addrummond/lightmeter/Readme.markdown

ARM gcc toolchain:

    https://launchpad.net/gcc-arm-embedded/+download

Programming known to work with OpenOCD 0.8.0.

See firmware/GDB_Readme.markdown.

Python 3 plus 'pypng' module required for build process.
