addrummond/lightmeter/schematic/lbr/README.markdown

Some lbr files which may be used in the schematic (some of these aren't but I haven't sorted out which ones yet).
