addrummond/lightmeter/schematic/proto2notes.markdown

* Layout for headphone jack is slightly wrong.
* Switch to fixed voltage buck reg (2.8V ?)
* Appear not to have 1uF caps in parts list?
* No Schotkey diodes in parts list?
* Power mux design is bad when both sources plugged in.
