addrummond/lightmeter/schematic/lipolybatterynotes.markdown

Display is ~27mm wide.

A good battery match is the HW352730, which is 27mm wide, 30mm long and 3.5mm
thick.

http://www.howellenergy.com/en/products/Li_polymer_battery/2013/0703/28.html

These batteries output 3.7V (nominal) and have a 200mAH capacity. Could consider
using two of them (27x60mm).

Also some suitable ones here:

http://www.lipolbattery.com/lipo%20battery.html
http://www.plgenergy.com/content/?1186.html
