addrummond/lightmeter/schematic/ordered/notesonfirstprotoboards.markdown

Notes on issues with initial prototype boards
-----

* Diodes should all have anode/cathode the same way round.

* Q5 and R5 are too close.

* Debug pad should be turned into via.

* Pad spacing on attiny1634 to be changed.

* Add battery recharge circuit (with microusb connector)?

* Test pad for op amp output?
