addrummond/lightmeter/schematic/Display_power_usage.markdown

When all pixels are set, uses 35mA when running on 5V via the Adafruit board,
and 20mA when half of the pixels are set, 11.8 when 1/4 are set, and 7.6 when
1/8 are set.

Typical usage for displaying moderate amounts of text appears to be around 5mA.
