addrummond/lightmeter/schematic/lightmeter.brd

## EAGLE design schematic/lightmeter.brd (2016-03-10)

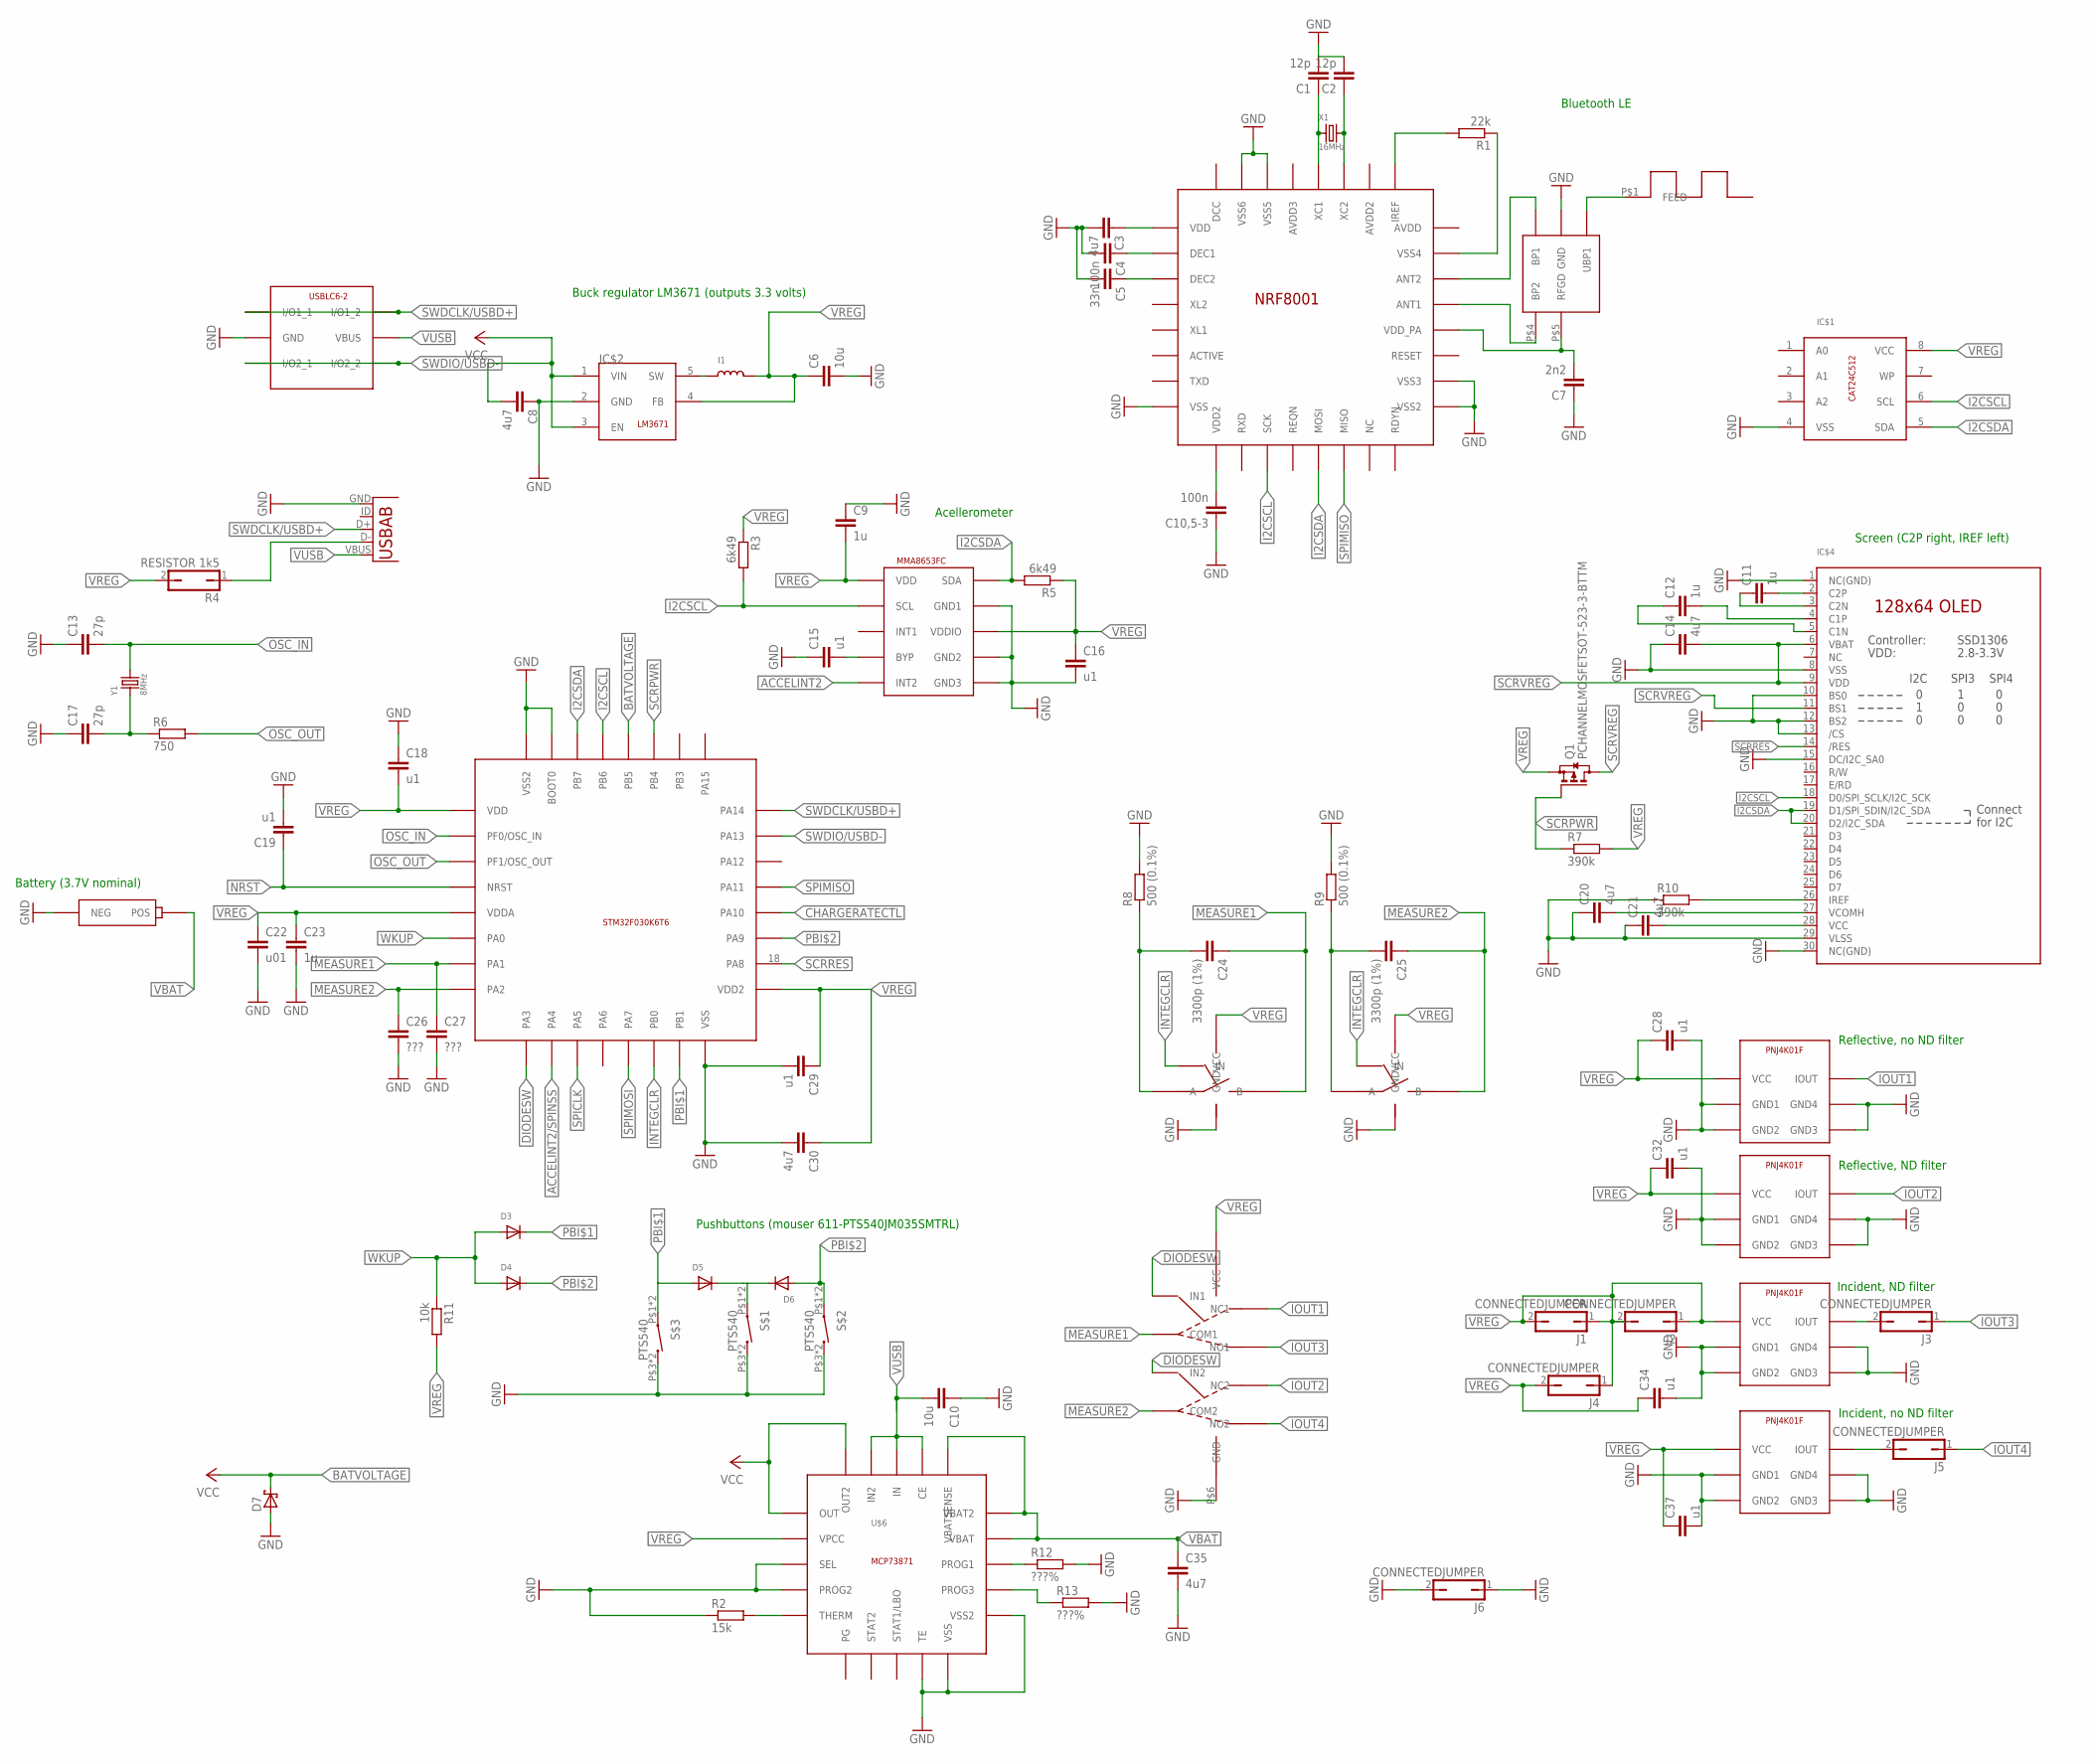
[picture p1: schematic lightmeter.sch]

Parts:
C1, C2: 12p; C0402
C3, C8, C14, C20, C21, C30, C35: 4u7; C0402
C4, C10,5-3: 100n; C0402
C5: 33n; C0402
C6: 10u; C0603
C7: 2n2; C0402
C9: 1u; C0603
C10: 10u; C0402
C11, C12: 1u; C0402
C13: 27p; GAP0402
C15, C16, C18, C19, C28, C29, C32, C34, C37: u1; C0402
C17: 27p; C0402
C22: u01; GAP0402
C23: 1u; GAP0603
C24, C25: 3300p (1%); C0603
C26, C27: ???; GAP0402
D3, D4, D5, D6: DIODESOD-323F; SOD-323F
D7: SCHOTTKY-DIODESOD-929; SOD-923
I1: CDRH2D14
IC$1: CAT24C512; TSSOP8
IC$2: LM3671; SOT23-5
IC$3: MMA8653; DFN-10
IC$4: DISP_OLED_UG-2864HSWEG010.96"; UG-2864HSWEG01_0.96IN_WRAPAROUND
IC$5: STM32F030K6T6; QFP-32
IC$6, IC$7: SN74LVC1G66; SOT-553-5
IC$8, IC$9, IC$11, IC$13: PNJ4K01F
IC$12: NLAS5223B; WQFN10
J1, J2, J3, J4, J5, J6: CONNECTEDJUMPER; JUMPER_R0402
Q1: PCHANNELMOSFETSOT-523-3-BTTM; SOT-523-3-BTTM
R1: 22k; R0402
R2: 15k; R0402
R3, R5: 6k49; R0402
R4: RESISTOR 1k5; JUMPER_R0402
R6: 750; R0402
R7, R10: 390k; R0402
R8, R9: 500 (0.1%); R0402
R11: 10k; R0402
R12, R13: ???%; R0402
S$1, S$2, S$3: PTS540; PTS540BTM
U1: USB-ABUSB-AB-MICRO-MIDMOUNT; USB-AB-MICRO-MIDMOUNT
U$1: 2450AT18A100
U$2: 2450BM14A00022450BM14A0002; 2450BM14A0002
U$3: NRF8001
U$4: USBLC6-2; SOT666
U$5: LIBAT; 78171-0002
U$6: MCP73871; QFN20
X1: 16MHz; CRYSTAL-2X1.6
Y1: 8MHz; CRYSTAL3.2X5MM

Connections:
ACCELINT2: IC$3.P$5 (INT2)
ACCELINT2/SPINSS: IC$5.10 (PA4)
ANT1CON: U$2.P$4 (BP2), U$3.P$21 (ANT1)
ANT2CON: U$2.P$3 (BP1), U$3.P$22 (ANT2)
ANTTRACE: U$1.P$1, U$2.P$1 (UBP1)
BATVOLTAGE: D7.P$2 (C), IC$5.28 (PB5)
CHARGERATECTL: IC$5.20 (PA10)
DIODESW: IC$5.9 (PA3), IC$12.P$4 (IN1), IC$12.P$8 (IN2)
GND: C1.2, C2.2, C3.2, C4.2, C5.2, C6.2, C7.1, C8.1, C9.1, C10.1, C10,5-3.1, C13.1, C14.1, C15.1, C16.2, C17.1, C18.1, C19.2, C20.1, C21.1, C22.2, C23.2, C26.2, C27.2, C28.2, C29.2, C30.2, C32.2, C34.2, C35.2, C37.2, D7.P$1 (A), IC$1.4 (VSS), IC$2.2 (GND), IC$3.P$6 (GND3), IC$3.P$7 (GND2), IC$3.P$9 (GND1), IC$4.1 (NC(GND)), IC$4.8 (VSS), IC$4.10 (BS0), IC$4.12 (BS2), IC$4.13 (/CS), IC$4.15 (DC/I2C_SA0), IC$4.29 (VLSS), IC$4.30 (NC(GND)), IC$5.16 (VSS), IC$5.31 (BOOT0), IC$5.32 (VSS2), IC$6.P$3 (GND), IC$7.P$3 (GND), IC$8.P$2 (GND1), IC$8.P$3 (GND2), IC$8.P$4 (GND3), IC$8.P$5 (GND4), IC$9.P$2 (GND1), IC$9.P$3 (GND2), IC$9.P$4 (GND3), IC$9.P$5 (GND4), IC$11.P$2 (GND1), IC$11.P$3 (GND2), IC$11.P$4 (GND3), IC$11.P$5 (GND4), IC$12.P$6 (GND), IC$13.P$2 (GND1), IC$13.P$3 (GND2), IC$13.P$4 (GND3), IC$13.P$5 (GND4), J6.1, J6.2, R2.1, R8.2, R9.2, R10.1, R12.2, R13.2, S$1.P$3 (2), S$1.P$4 (2), S$2.P$3 (2), S$2.P$4 (2), S$3.P$3 (2), S$3.P$4 (2), U1.GND, U$2.P$2 (GND), U$3.P$8 (VSS), U$3.P$17 (VSS2), U$3.P$18 (VSS3), U$3.P$30 (VSS5), U$3.P$31 (VSS6), U$3.P$33 (VSS), U$4.P$2 (GND), U$5.P$1 (NEG), U$6.P$3 (SEL), U$6.P$4 (PROG2), U$6.P$9 (TE), U$6.P$10 (VSS), U$6.P$11 (VSS2), U$6.P$21 (VSS2)
I2CSCL: IC$1.6 (SCL), IC$3.P$2 (SCL), IC$4.18 (D0/SPI_SCLK/I2C_SCK), IC$5.29 (PB6), R3.2, U$3.P$11 (SCK)
I2CSDA: IC$1.5 (SDA), IC$3.P$10 (SDA), IC$4.19 (D1/SPI_SDIN/I2C_SDA), IC$4.20 (D2/I2C_SDA), IC$5.30 (PB7), R5.2, U$3.P$13 (MOSI)
INTEGCLR: IC$5.14 (PB0), IC$6.P$4 (IN), IC$7.P$4 (IN)
IOUT1: IC$8.P$6 (IOUT), IC$12.P$5 (NC1)
IOUT2: IC$9.P$6 (IOUT), IC$12.P$7 (NC2)
IOUT3: IC$12.P$2 (NO1), J3.1
IOUT4: IC$12.P$10 (NO2), J5.1
MEASURE1: C24.1, C27.1, IC$5.7 (PA1), IC$6.P$2 (B), IC$12.P$3 (COM1)
MEASURE2: C25.1, C26.1, IC$5.8 (PA2), IC$7.P$2 (B), IC$12.P$9 (COM2)
unnamed: IC$11.P$6 (IOUT), J3.2
unnamed: IC$13.P$6 (IOUT), J5.2
unnamed: C24.2, IC$6.P$1 (A), R8.1
unnamed: R2.2, U$6.P$5 (THERM)
unnamed: C25.2, IC$7.P$1 (A), R9.1
unnamed: C15.2, IC$3.P$4 (BYP)
unnamed: C17.2, R6.1, Y1.P$1 (1)
unnamed: I1.P$1 (1), IC$2.5 (SW)
unnamed: C20.2, IC$4.27 (VCOMH)
unnamed: D5.C, D6.C, S$1.P$1 (1), S$1.P$2 (1)
unnamed: C11.2, IC$4.2 (C2P)
unnamed: C11.1, IC$4.3 (C2N)
unnamed: C7.2, U$2.P$5 (RFGD), U$3.P$20 (VDD_PA)
unnamed: R1.2, U$3.P$25 (IREF)
unnamed: IC$4.26 (IREF), R10.2
unnamed: R1.1, U$3.P$23 (VSS4)
unnamed: C5.1, U$3.P$3 (DEC2)
unnamed: C3.1, U$3.P$1 (VDD)
unnamed: C10,5-3.2, U$3.P$9 (VDD2)
unnamed: C12.1, IC$4.5 (C1N)
unnamed: C4.1, U$3.P$2 (DEC1)
unnamed: C1.1, U$3.P$28 (XC1), X1.P$1 (1)
unnamed: C12.2, IC$4.4 (C1P)
unnamed: C2.1, U$3.P$27 (XC2), X1.P$3 (2)
unnamed: C21.2, IC$4.28 (VCC)
unnamed: R12.1, U$6.P$13 (PROG1)
unnamed: R13.1, U$6.P$12 (PROG3)
NRST: C19.1, IC$5.4 (NRST)
OSC_IN: C13.2, IC$5.2 (PF0/OSC_IN), Y1.P$2 (2)
OSC_OUT: IC$5.3 (PF1/OSC_OUT), R6.2
PBI$1: D3.C, D5.A, IC$5.15 (PB1), S$3.P$1 (1), S$3.P$2 (1)
PBI$2: D4.C, D6.A, IC$5.19 (PA9), S$2.P$1 (1), S$2.P$2 (1)
SCRPWR: IC$5.27 (PB4), Q1.P$3 (G), R7.1
SCRRES: IC$4.14 (/RES), IC$5.18 (PA8)
SCRVREG: C14.2, IC$4.6 (VBAT), IC$4.9 (VDD), IC$4.11 (BS1), Q1.P$1 (D)
SPICLK: IC$5.11 (PA5)
SPIMISO: IC$5.21 (PA11), U$3.P$14 (MISO)
SPIMOSI: IC$5.13 (PA7)
SWDCLK/USBD+: IC$5.24 (PA14), U1.D+, U$4.P$1 (I/O1_1), U$4.P$6 (I/O1_2)
SWDIO/USBD-: IC$5.23 (PA13), U$4.P$3 (I/O2_1), U$4.P$4 (I/O2_2)
USBD-: R4.1, U1.D-
VBAT: C35.1, U$5.P$2 (POS), U$6.P$14 (VBAT), U$6.P$15 (VBAT2), U$6.P$16 (VBATSENSE)
VCC: C8.2, IC$2.1 (VIN), IC$2.3 (EN), U$6.P$1 (OUT), U$6.P$20 (OUT2)
VREG: C6.1, C9.2, C16.1, C18.2, C22.1, C23.1, C28.1, C29.1, C30.1, C32.1, C34.1, C37.1, I1.P$2 (2), IC$1.8 (VCC), IC$2.4 (FB), IC$3.P$1 (VDD), IC$3.P$8 (VDDIO), IC$5.1 (VDD), IC$5.5 (VDDA), IC$5.17 (VDD2), IC$6.P$5 (VCC), IC$7.P$5 (VCC), IC$8.P$1 (VCC), IC$9.P$1 (VCC), IC$11.P$1 (VCC), IC$12.P$1 (VCC), IC$13.P$1 (VCC), J1.1, J1.2, J2.1, J2.2, J4.1, J4.2, Q1.P$2 (S), R3.1, R4.2, R5.1, R7.2, R11.2, U$6.P$2 (VPCC)
VUSB: C10.2, U1.VBUS, U$4.P$5 (VBUS), U$6.P$17 (CE), U$6.P$18 (IN), U$6.P$19 (IN2)
WKUP: D3.A, D4.A, IC$5.6 (PA0), R11.1

Notes on the sheet:
Battery (3.7V nominal)
Buck regulator LM3671 (outputs 3.3 volts)
Pushbuttons (mouser 611-PTS540JM035SMTRL)
Screen (C2P right, IREF left)
Acellerometer
Reflective, no ND filter
Reflective, ND filter
Incident, ND filter
Incident, no ND filter
Bluetooth LE

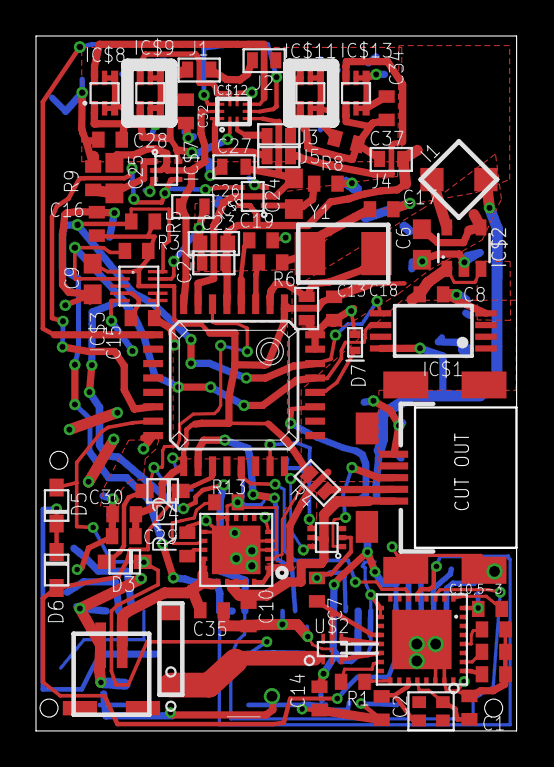
[picture p2: board lightmeter.brd from above]

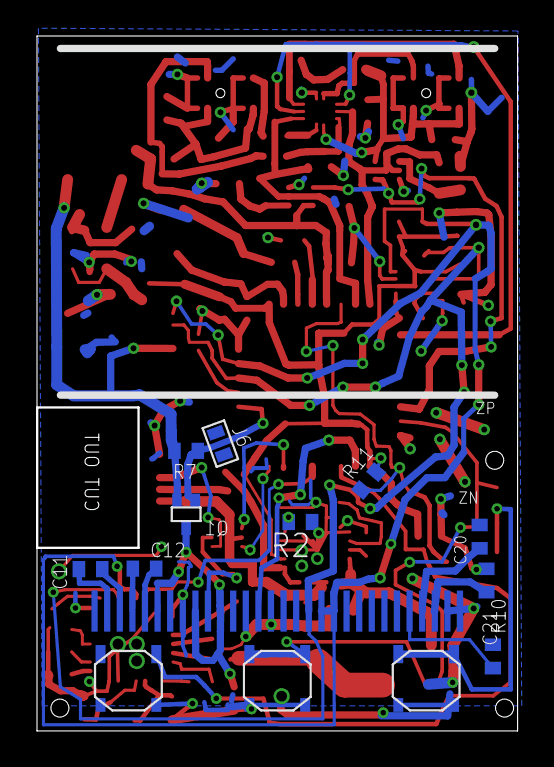
[picture p3: board lightmeter.brd from below]

Board: 2 copper layers, 26.7 x 38.6 mm, 85 parts (9 on the bottom side), 59 nets.
