addrummond/lightmeter/schematic/ordered/lightmeter_seeed2.brd

## EAGLE design schematic/ordered/lightmeter_seeed2.brd (2015-05-27)

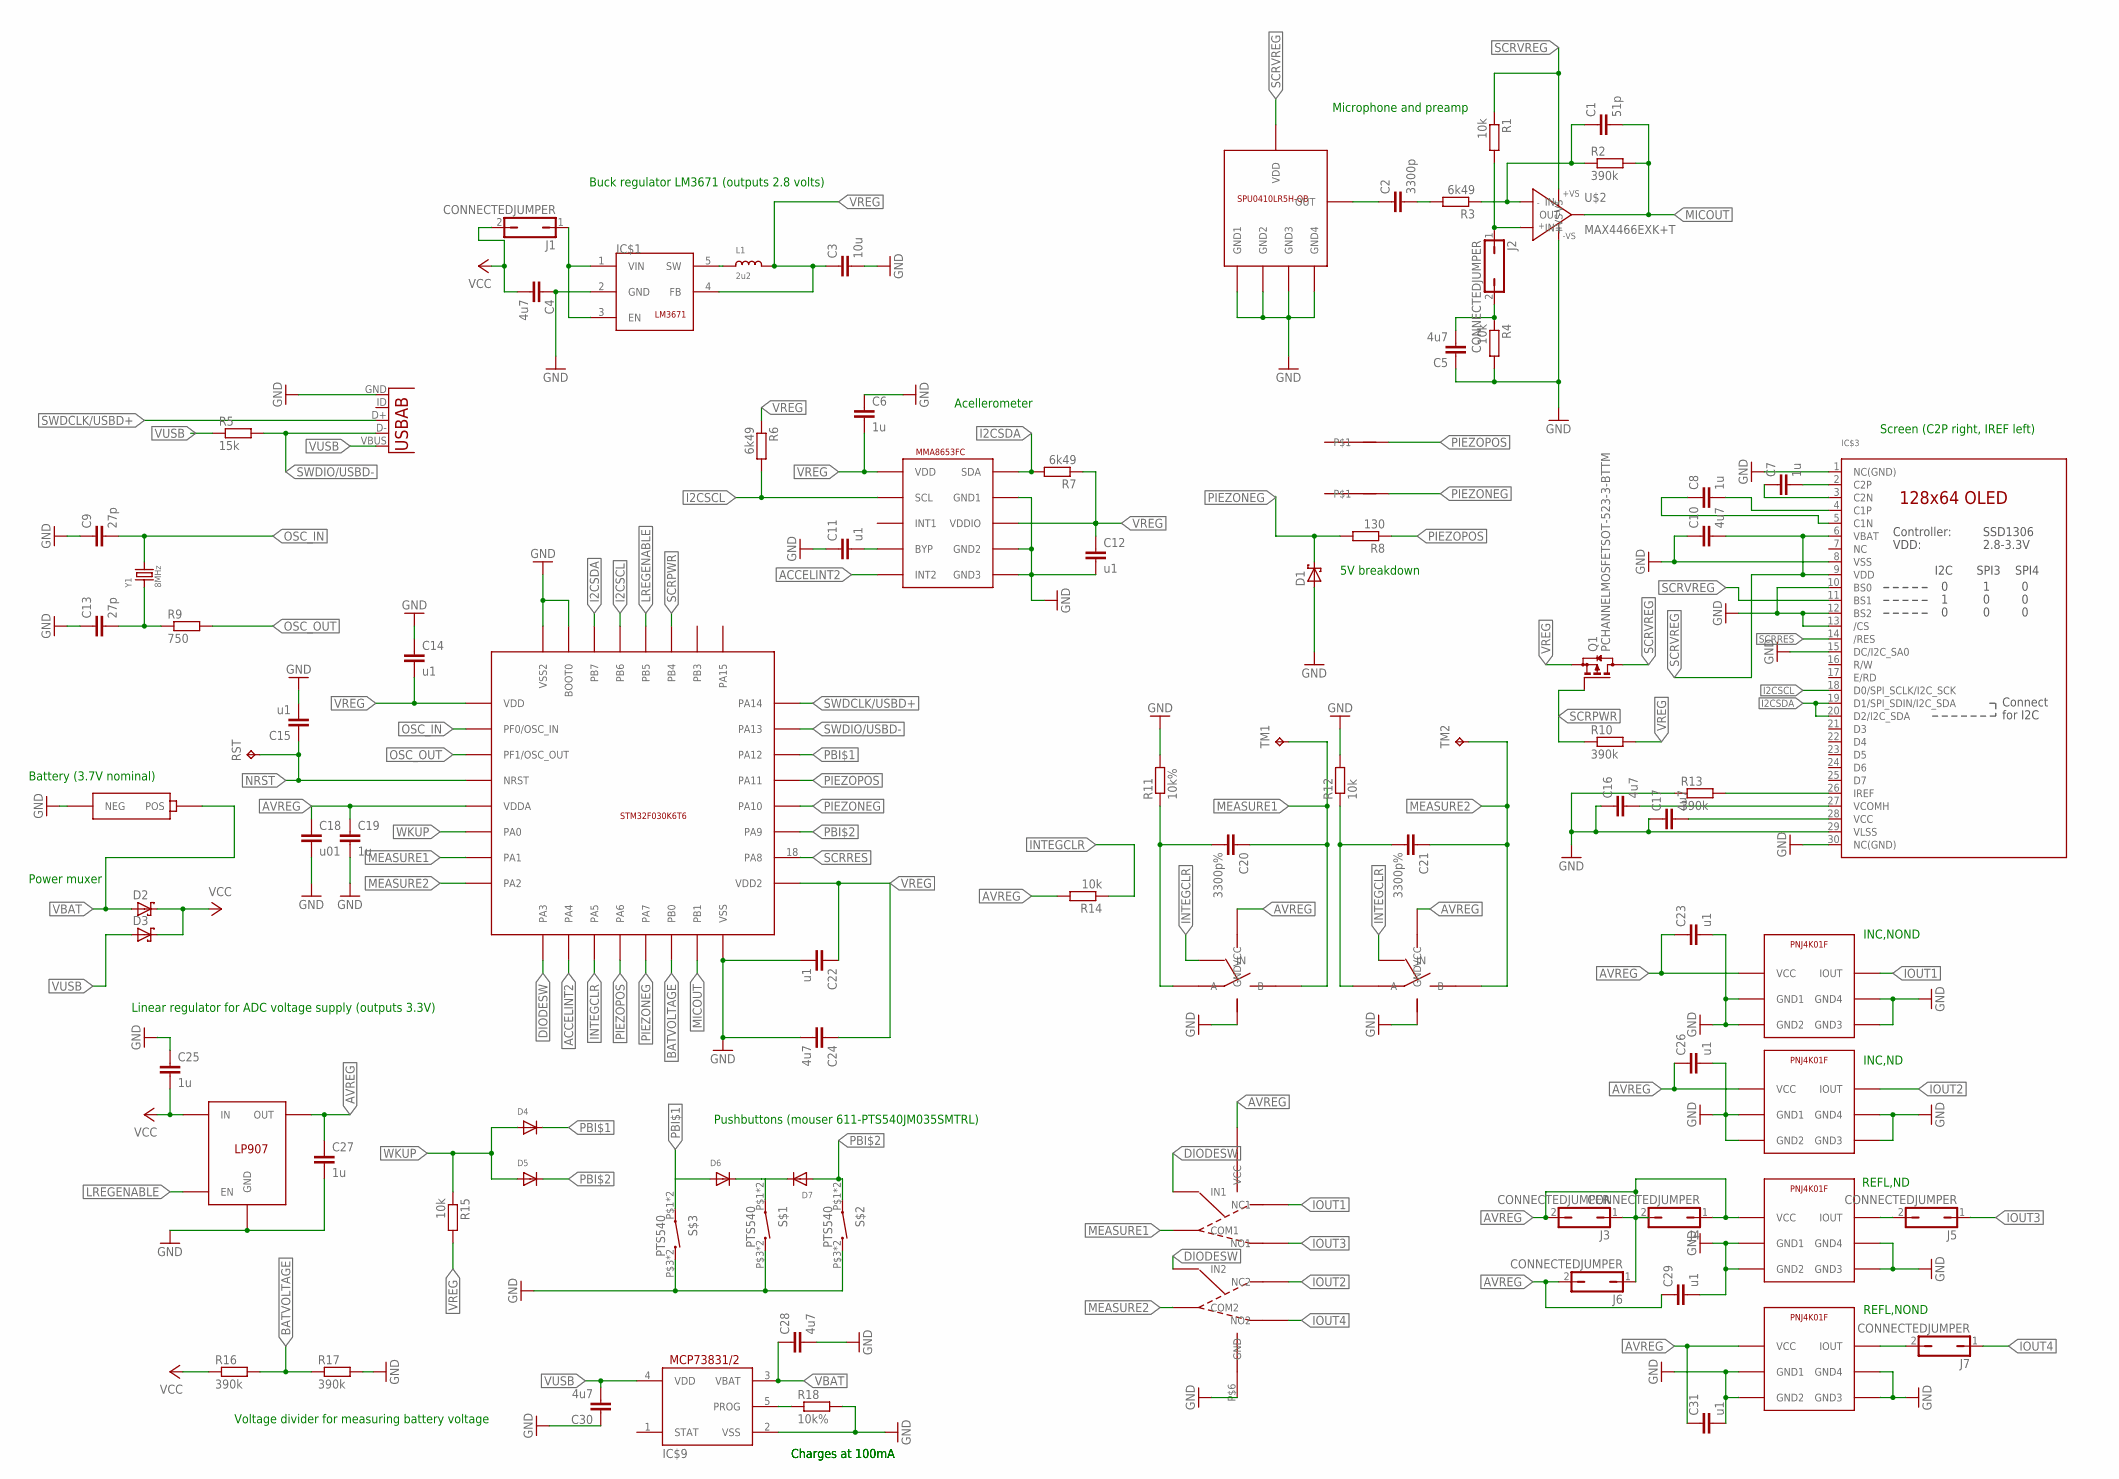
[picture p4: schematic lightmeter_seeed2.sch]

Parts:
C1: 51p; C0402
C2: 3300p; C0603
C3: 10u; C0402
C4, C5, C10, C16, C17, C24, C28, C30: 4u7; C0402
C6, C7, C8, C25, C27: 1u; C0603
C9: 27p; GAP0402
C11, C12, C14, C15, C22, C23, C26, C29, C31: u1; C0402
C13: 27p; C0402
C18: u01; GAP0402
C19: 1u; GAP0603
C20, C21: 3300p%; C0603
D1: SCHOTTKY-DIODESOD-923-BTTM; SOD-923-BTTM
D2, D3: SCHOTTKY-DIODESC-79; SC-79
D4, D5, D6, D7: DIODESOD-323F; SOD-323F
IC$1: LM3671; SOT23-5
IC$2: MMA8653; DFN-10
IC$3: DISP_OLED_UG-2864HSWEG010.96"; UG-2864HSWEG01_0.96IN_WRAPAROUND
IC$4: STM32F030K6T6; QFP-32
IC$5, IC$7, IC$8, IC$10: PNJ4K01F
IC$6: LP5907; SOT23-5L
IC$9: MCP73831/OT; SOT23-5L
J1, J2, J3, J4, J5, J6, J7: CONNECTEDJUMPER; JUMPER_R0402
L1: 2u2; _0603
Q1: PCHANNELMOSFETSOT-523-3-BTTM; SOT-523-3-BTTM
R1, R4, R12, R14, R15: 10k; R0402
R2, R10, R13, R17: 390k; R0402
R3, R6, R7: 6k49; R0402
R5: 15k; R0402
R8: 130; R0402
R9: 750; R0402
R11, R18: 10k%; R0402
R16: 390k; JUMPER_R0402
RST: TPB1,27; B1,27
S$1, S$2, S$3: PTS540; PTS540BTM
TM1, TM2: TPB1,27; B1,27
U1: USB-ABUSB-AB-MICRO-MIDMOUNT; USB-AB-MICRO-MIDMOUNT
U$1: SPU0410LR5H-QBSPU0410LRSH-QB; SPU0410LR5H-QB
U$2: MAX4466EXK+T; SC-70-5
U$3: LIBAT; 78171-0002
U$4, U$5: SN74LVC1G66; SOT-553-5
U$6: NLAS5223B; WQFN10
Y1: 8MHz; CRYSTAL3.2X5MM
ZN: WIREATTACHMENT; SMALLSQUAREWIREHOLE
ZP: WIREATTACHMENT; SMALLSQUAREWIREHOLE

Connections:
ACCELINT2: IC$2.P$5 (INT2), IC$4.10 (PA4)
AVREG: C18.1, C19.1, C23.1, C26.1, C27.1, C29.1, C31.1, IC$4.5 (VDDA), IC$5.P$1 (VCC), IC$6.5 (OUT), IC$7.P$1 (VCC), IC$8.P$1 (VCC), IC$10.P$1 (VCC), J3.1, J3.2, J4.1, J4.2, J6.1, J6.2, R14.2, U$4.P$5 (VCC), U$5.P$5 (VCC), U$6.P$1 (VCC)
BATVOLTAGE: IC$4.14 (PB0), R16.2, R17.1
DIODESW: IC$4.9 (PA3), U$6.P$4 (IN1), U$6.P$8 (IN2)
GND: C3.2, C4.1, C5.1, C6.1, C9.1, C10.1, C11.1, C12.2, C13.1, C14.1, C15.2, C16.1, C17.1, C18.2, C19.2, C22.2, C23.2, C24.2, C25.1, C26.2, C27.2, C28.2, C29.2, C30.1, C31.2, D1.P$1 (A), IC$1.2 (GND), IC$2.P$6 (GND3), IC$2.P$7 (GND2), IC$2.P$9 (GND1), IC$3.1 (NC(GND)), IC$3.8 (VSS), IC$3.10 (BS0), IC$3.12 (BS2), IC$3.13 (/CS), IC$3.15 (DC/I2C_SA0), IC$3.29 (VLSS), IC$3.30 (NC(GND)), IC$4.16 (VSS), IC$4.31 (BOOT0), IC$4.32 (VSS2), IC$5.P$2 (GND1), IC$5.P$3 (GND2), IC$5.P$4 (GND3), IC$5.P$5 (GND4), IC$6.2 (GND), IC$7.P$2 (GND1), IC$7.P$3 (GND2), IC$7.P$4 (GND3), IC$7.P$5 (GND4), IC$8.P$2 (GND1), IC$8.P$3 (GND2), IC$8.P$4 (GND3), IC$8.P$5 (GND4), IC$9.2 (VSS), IC$10.P$2 (GND1), IC$10.P$3 (GND2), IC$10.P$4 (GND3), IC$10.P$5 (GND4), R4.2, R11.2, R12.2, R13.1, R17.2, R18.2, S$1.P$3 (2), S$1.P$4 (2), S$2.P$3 (2), S$2.P$4 (2), S$3.P$3 (2), S$3.P$4 (2), U1.GND, U$1.P$2 (GND1), U$1.P$3 (GND2), U$1.P$5 (GND3), U$1.P$6 (GND4), U$2.P$2 (-VS), U$3.P$1 (NEG), U$4.P$3 (GND), U$5.P$3 (GND), U$6.P$6 (GND)
I2CSCL: IC$2.P$2 (SCL), IC$3.18 (D0/SPI_SCLK/I2C_SCK), IC$4.29 (PB6), R6.2
I2CSDA: IC$2.P$10 (SDA), IC$3.19 (D1/SPI_SDIN/I2C_SDA), IC$3.20 (D2/I2C_SDA), IC$4.30 (PB7), R7.2
INTEGCLR: IC$4.11 (PA5), R14.1, U$4.P$4 (IN), U$5.P$4 (IN)
IOUT1: IC$5.P$6 (IOUT), U$6.P$5 (NC1)
IOUT2: IC$7.P$6 (IOUT), U$6.P$7 (NC2)
IOUT3: J5.1, U$6.P$2 (NO1)
IOUT4: J7.1, U$6.P$10 (NO2)
LREGENABLE: IC$4.28 (PB5), IC$6.3 (EN)
MEASURE1: C20.1, IC$4.7 (PA1), TM1.TP, U$4.P$2 (B), U$6.P$3 (COM1)
MEASURE2: C21.1, IC$4.8 (PA2), TM2.TP, U$5.P$2 (B), U$6.P$9 (COM2)
MICOUT: C1.2, IC$4.15 (PB1), R2.2, U$2.P$4 (OUT)
unnamed: IC$8.P$6 (IOUT), J5.2
unnamed: IC$10.P$6 (IOUT), J7.2
unnamed: C20.2, R11.1, U$4.P$1 (A)
unnamed: IC$1.1 (VIN), IC$1.3 (EN), J1.1
unnamed: IC$9.5 (PROG), R18.1
unnamed: C21.2, R12.1, U$5.P$1 (A)
unnamed: C11.2, IC$2.P$4 (BYP)
unnamed: C13.2, R9.1, Y1.P$1 (1)
unnamed: IC$1.5 (SW), L1.1
unnamed: C16.2, IC$3.27 (VCOMH)
unnamed: D6.C, D7.C, S$1.P$1 (1), S$1.P$2 (1)
unnamed: C2.1, U$1.P$1 (OUT)
unnamed: C7.2, IC$3.2 (C2P)
unnamed: C7.1, IC$3.3 (C2N)
unnamed: C2.2, R3.2
unnamed: C1.1, R2.1, R3.1, U$2.P$3 (IN-)
unnamed: IC$3.26 (IREF), R13.2
unnamed: J2.1, R1.2, U$2.P$1 (IN+)
unnamed: C5.2, J2.2, R4.1
unnamed: C8.1, IC$3.5 (C1N)
unnamed: C8.2, IC$3.4 (C1P)
unnamed: C17.2, IC$3.28 (VCC)
NRST: C15.1, IC$4.4 (NRST), RST.TP
OSC_IN: C9.2, IC$4.2 (PF0/OSC_IN), Y1.P$2 (2)
OSC_OUT: IC$4.3 (PF1/OSC_OUT), R9.2
PBI$1: D4.C, D6.A, IC$4.22 (PA12), S$3.P$1 (1), S$3.P$2 (1)
PBI$2: D5.C, D7.A, IC$4.19 (PA9), S$2.P$1 (1), S$2.P$2 (1)
PIEZONEG: D1.P$2 (C), IC$4.13 (PA7), IC$4.20 (PA10), R8.2, ZN.P$1
PIEZOPOS: IC$4.12 (PA6), IC$4.21 (PA11), R8.1, ZP.P$1
SCRPWR: IC$4.27 (PB4), Q1.P$2 (G), R10.1
SCRRES: IC$3.14 (/RES), IC$4.18 (PA8)
SCRVREG: C10.2, IC$3.6 (VBAT), IC$3.9 (VDD), IC$3.11 (BS1), Q1.P$1 (D), R1.1, U$1.P$4 (VDD), U$2.P$5 (+VS)
SWDCLK/USBD+: IC$4.24 (PA14), U1.D+
SWDIO/USBD-: IC$4.23 (PA13), R5.2, U1.D-
VBAT: C28.1, D2.P$2 (A), IC$9.3 (VBAT), U$3.P$2 (POS)
VCC: C4.2, C25.2, D2.P$1 (C), D3.P$1 (C), IC$6.1 (IN), J1.2, R16.1
VREG: C3.1, C6.2, C12.1, C14.2, C22.1, C24.1, IC$1.4 (FB), IC$2.P$1 (VDD), IC$2.P$8 (VDDIO), IC$4.1 (VDD), IC$4.17 (VDD2), L1.2, Q1.P$3 (S), R6.1, R7.1, R10.2, R15.2
VUSB: C30.2, D3.P$2 (A), IC$9.4 (VDD), R5.1, U1.VBUS
WKUP: D4.A, D5.A, IC$4.6 (PA0), R15.1

Notes on the sheet:
Battery (3.7V nominal)
Buck regulator LM3671 (outputs 2.8 volts)
Pushbuttons (mouser 611-PTS540JM035SMTRL)
Screen (C2P right, IREF left)
Power muxer
Charges at 100mA
Acellerometer
Linear regulator for ADC voltage supply (outputs 3.3V)
Voltage divider for measuring battery voltage
INC,NOND
INC,ND
REFL,ND
REFL,NOND
5V breakdown
Microphone and preamp

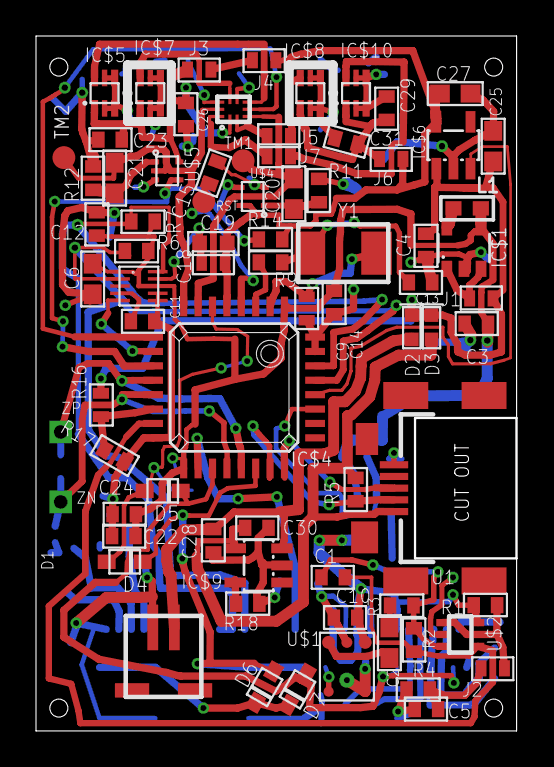
[picture p5: board lightmeter_seeed2.brd from above]

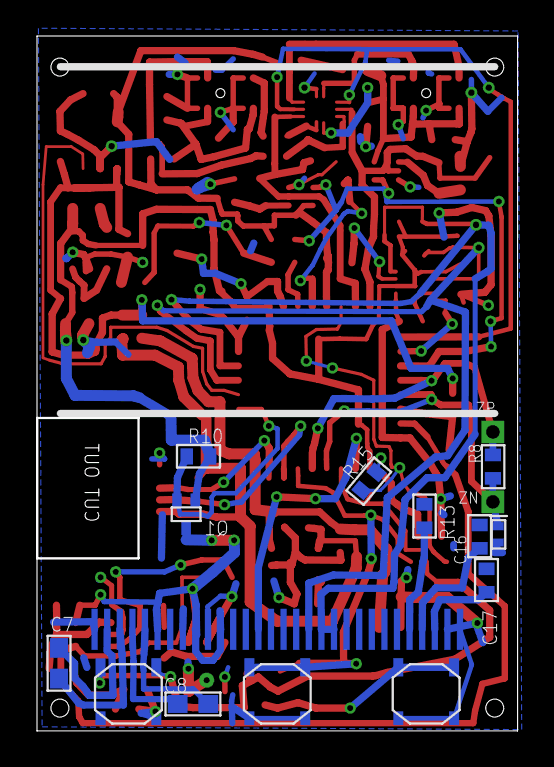
[picture p6: board lightmeter_seeed2.brd from below]

Board: 2 copper layers, 26.7 x 38.6 mm, 91 parts (8 on the bottom side), 55 nets.
