addrummond/lightmeter/schematic/ordered/lightmeter_seeed1.brd

## EAGLE design schematic/ordered/lightmeter_seeed1.brd (2015-03-22)

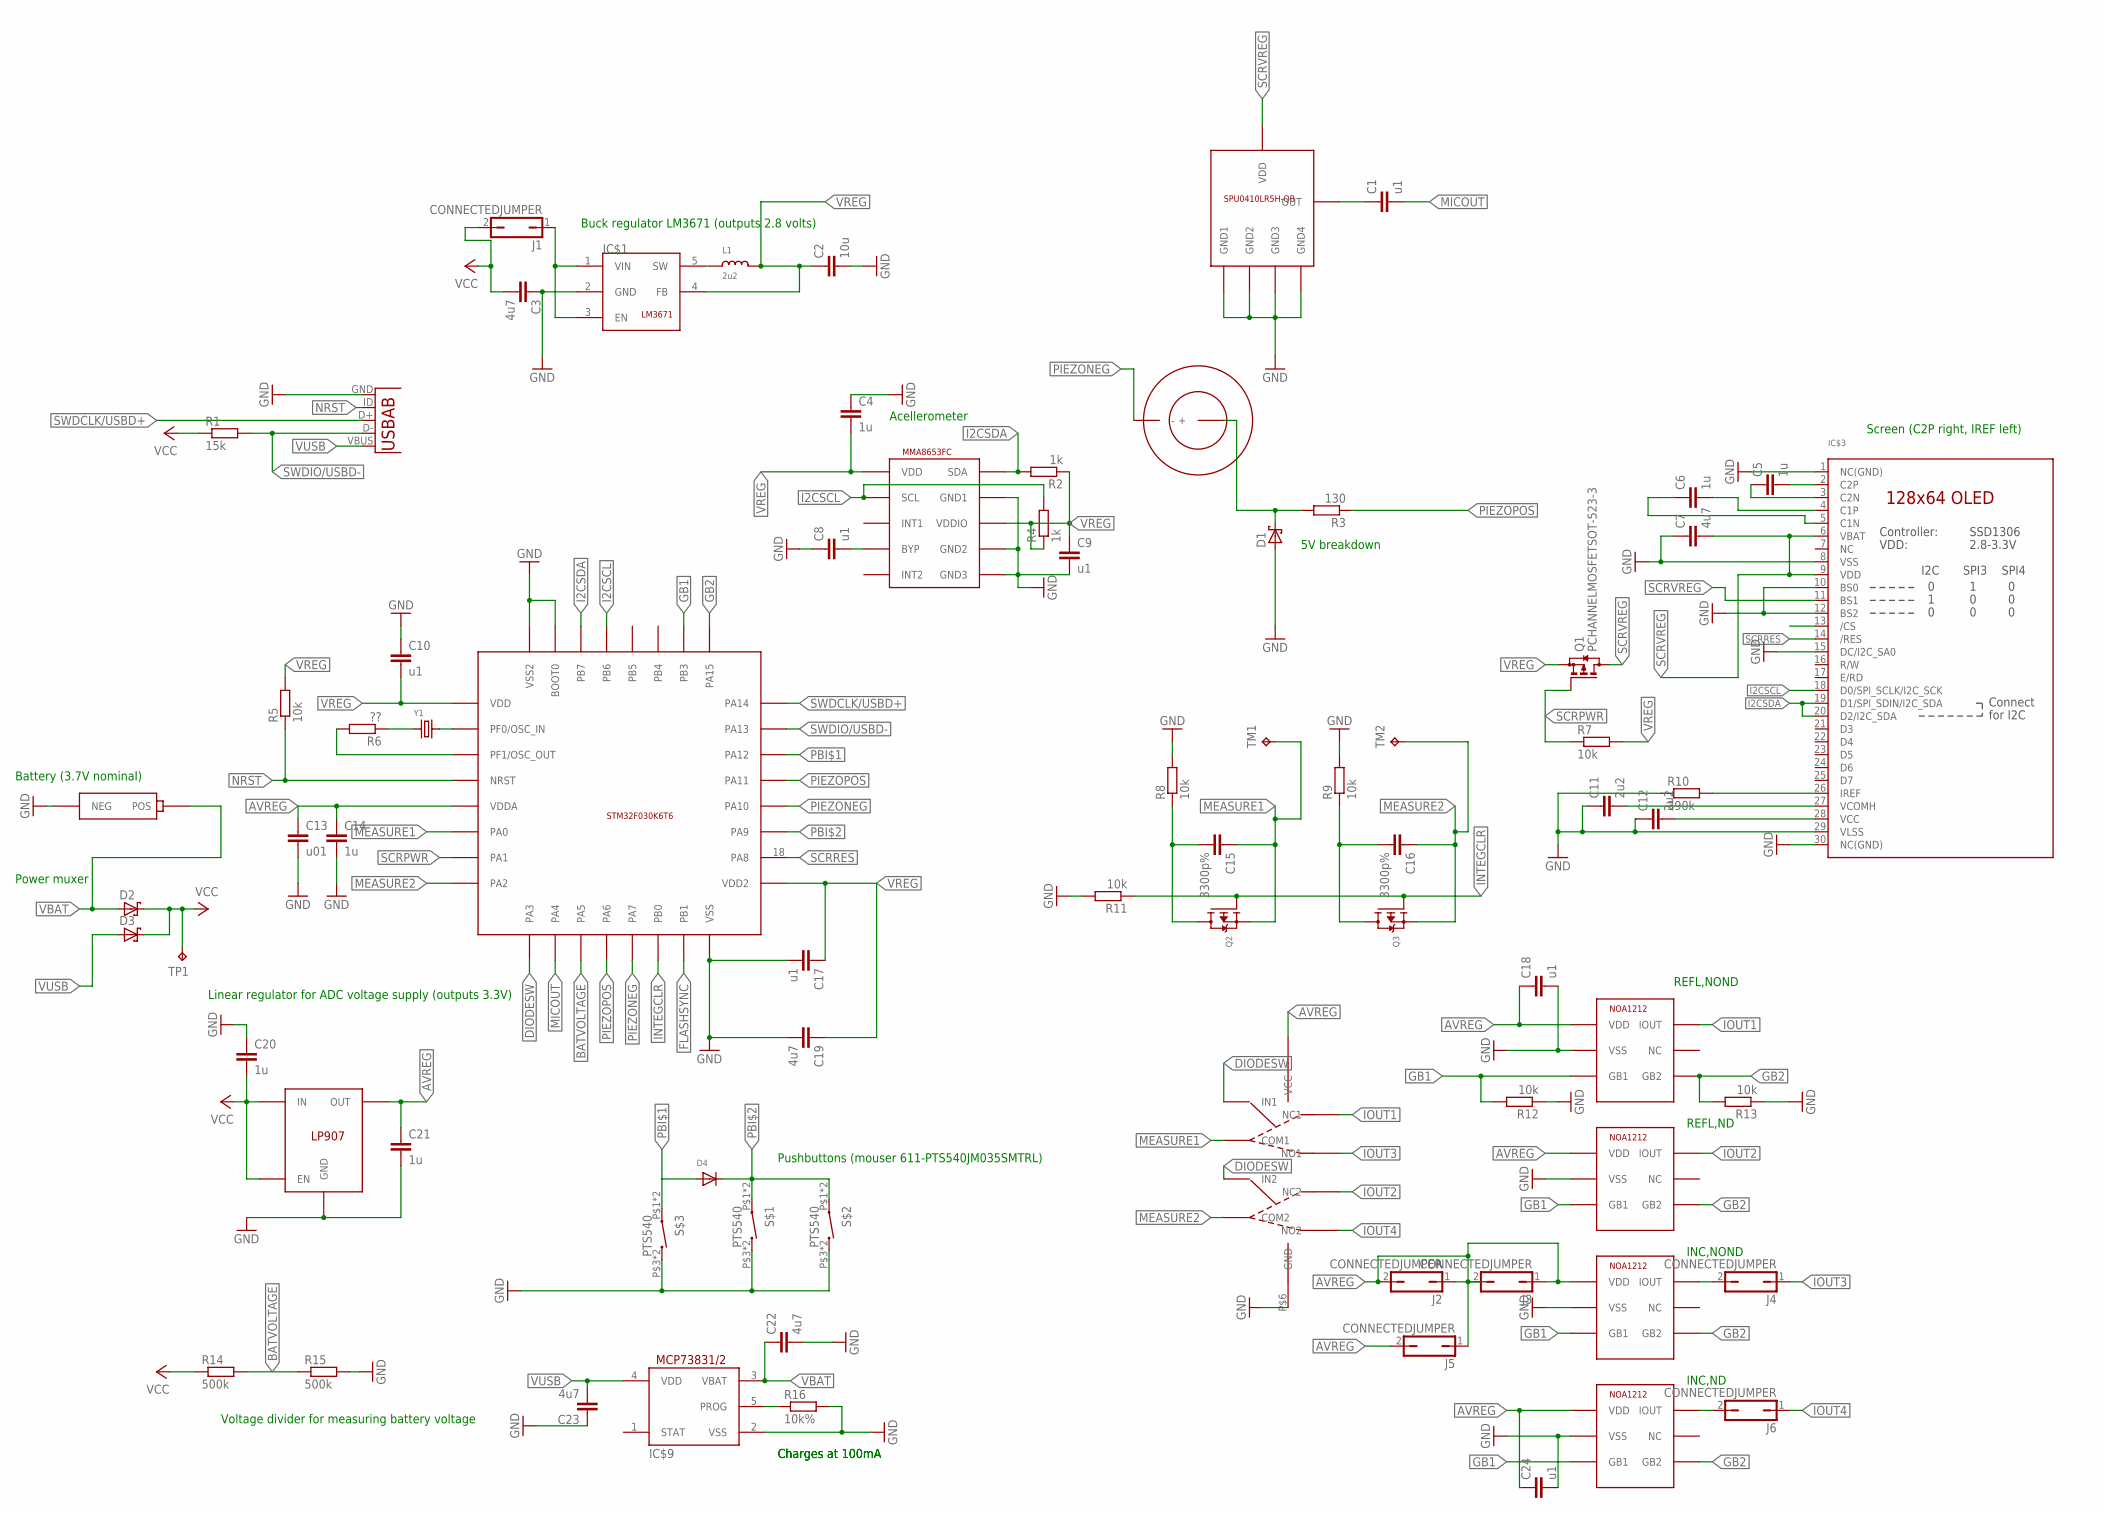
[picture p7: schematic lightmeter_seeed1.sch]

Parts:
C1, C9, C10, C17, C18, C24: u1; C0402
C2: 10u; C0402
C3, C7, C19, C22, C23: 4u7; C0402
C4, C5, C6, C20: 1u; C0603
C8: u1; C0603
C11, C12: 2u2; C0402
C13: u01; GAP0402
C14: 1u; GAP0402
C15, C16: 3300p%; C0603
C21: 1u; C0402
D1: SCHOTTKY-DIODESOD-929; SOD-923
D2, D3: SCHOTTKY-DIODEX3-DFN0603-2; X3-DFN0603-2
D4: DIODESOD-323F; SOD-323F
IC$1: LM3671; SOT23-5
IC$2: MMA8653; DFN-10
IC$3: DISP_OLED_UG-2864HSWEG010.96"; UG-2864HSWEG01_0.96IN_WRAPAROUND
IC$4: STM32F030K6T6; QFP-32
IC$5, IC$7, IC$8, IC$10: NOA1212; CUDFN6
IC$6: LP5907; SOT23-5L
IC$9: MCP73831/OT; SOT23-5L
J1, J2, J3, J4, J5, J6: CONNECTEDJUMPER; JUMPER_R0402
L1: 2u2; _0603
Q1: PCHANNELMOSFETSOT-523-3; SOT-523-3
Q2, Q3: MOSFET-PWIDE; SOT23-WIDE
R1: 15k; R0402
R2, R4: 1k; R0402
R3: 130; R0603
R5, R7, R8, R9, R11, R12, R13: 10k; R0402
R6: ??; R0402
R10: 390k; R0402
R14, R15: 500k; R0402
R16: 10k%; R0402
S$1, S$2, S$3: PTS540; PTS540BTM
TM1, TM2: TPB1,27; B1,27
TP1: TPB1,27; B1,27
U1: USB-ABUSB-AB-MICRO-MIDMOUNT; USB-AB-MICRO-MIDMOUNT
U$1: SPU0410LR5H-QBSPU0410LRSH-QB; SPU0410LR5H-QB
U$2: PIEZOBENDER165
U$3: LIBAT; 78171-0002
U$4: NLAS5223B; WQFN10
Y1: CRYSTAL2.5X2.0MM; CRYSTAL_2.5X2

Connections:
AUDIOIN: D1.P$2 (C), R3.2, U$2.P$2 (+)
AVREG: C13.1, C14.1, C18.1, C21.1, C24.1, IC$4.5 (VDDA), IC$5.P$1 (VDD), IC$6.5 (OUT), IC$7.P$1 (VDD), IC$8.P$1 (VDD), IC$10.P$1 (VDD), J2.1, J2.2, J3.1, J3.2, J5.1, J5.2, U$4.P$1 (VCC)
BATVOLTAGE: IC$4.11 (PA5), R14.2, R15.1
DIODESW: IC$4.9 (PA3), U$4.P$4 (IN1), U$4.P$8 (IN2)
FLASHSYNC: IC$4.15 (PB1)
GB1: IC$4.26 (PB3), IC$5.P$3 (GB1), IC$7.P$3 (GB1), IC$8.P$3 (GB1), IC$10.P$3 (GB1), R12.2
GB2: IC$4.25 (PA15), IC$5.P$4 (GB2), IC$7.P$4 (GB2), IC$8.P$4 (GB2), IC$10.P$4 (GB2), R13.2
GND: C2.2, C3.1, C4.1, C7.1, C8.1, C9.2, C10.1, C11.1, C12.1, C13.2, C14.2, C17.2, C18.2, C19.2, C20.1, C21.2, C22.2, C23.1, C24.2, D1.P$1 (A), IC$1.2 (GND), IC$2.P$6 (GND3), IC$2.P$7 (GND2), IC$2.P$9 (GND1), IC$3.1 (NC(GND)), IC$3.8 (VSS), IC$3.10 (BS0), IC$3.12 (BS2), IC$3.15 (DC/I2C_SA0), IC$3.29 (VLSS), IC$3.30 (NC(GND)), IC$4.16 (VSS), IC$4.31 (BOOT0), IC$4.32 (VSS2), IC$5.P$2 (VSS), IC$5.P$7 (VSS), IC$6.2 (GND), IC$7.P$2 (VSS), IC$7.P$7 (VSS), IC$8.P$2 (VSS), IC$8.P$7 (VSS), IC$9.2 (VSS), IC$10.P$2 (VSS), IC$10.P$7 (VSS), R8.2, R9.2, R10.1, R11.2, R12.1, R13.1, R15.2, R16.2, S$1.P$3 (2), S$1.P$4 (2), S$2.P$3 (2), S$2.P$4 (2), S$3.P$3 (2), S$3.P$4 (2), U1.GND, U$1.P$2 (GND1), U$1.P$3 (GND2), U$1.P$5 (GND3), U$1.P$6 (GND4), U$3.P$1 (NEG), U$4.P$6 (GND)
I2CSCL: IC$2.P$2 (SCL), IC$3.18 (D0/SPI_SCLK/I2C_SCK), IC$4.29 (PB6), R4.2
I2CSDA: IC$2.P$10 (SDA), IC$3.19 (D1/SPI_SDIN/I2C_SDA), IC$3.20 (D2/I2C_SDA), IC$4.30 (PB7), R2.2
INTEGCLR: IC$4.14 (PB0), Q2.1 (G), Q3.1 (G), R11.1
IOUT1: IC$5.P$6 (IOUT), U$4.P$5 (NC1)
IOUT2: IC$7.P$6 (IOUT), U$4.P$7 (NC2)
IOUT3: J4.1, U$4.P$2 (NO1)
IOUT4: J6.1, U$4.P$10 (NO2)
MEASURE1: C15.1, IC$4.6 (PA0), Q2.2 (S), TM1.TP, U$4.P$3 (COM1)
MEASURE2: C16.1, IC$4.8 (PA2), Q3.2 (S), TM2.TP, U$4.P$9 (COM2)
MICOUT: C1.2, IC$4.10 (PA4)
unnamed: IC$8.P$6 (IOUT), J4.2
unnamed: IC$10.P$6 (IOUT), J6.2
unnamed: C15.2, Q2.3 (D), R8.1
unnamed: IC$1.1 (VIN), IC$1.3 (EN), J1.1
unnamed: IC$9.5 (PROG), R16.1
unnamed: C16.2, Q3.3 (D), R9.1
unnamed: C8.2, IC$2.P$4 (BYP)
unnamed: IC$4.2 (PF0/OSC_IN), Y1.3 (2)
unnamed: IC$4.3 (PF1/OSC_OUT), R6.2
unnamed: IC$1.5 (SW), L1.1
unnamed: R6.1, Y1.1
unnamed: C11.2, IC$3.27 (VCOMH)
unnamed: C1.1, U$1.P$1 (OUT)
unnamed: C5.2, IC$3.2 (C2P)
unnamed: C5.1, IC$3.3 (C2N)
unnamed: IC$3.26 (IREF), R10.2
unnamed: C6.1, IC$3.5 (C1N)
unnamed: C6.2, IC$3.4 (C1P)
unnamed: C12.2, IC$3.28 (VCC)
NRST: IC$4.4 (NRST), R5.1, U1.ID (USBID)
PBI$1: D4.A, IC$4.22 (PA12), S$3.P$1 (1), S$3.P$2 (1)
PBI$2: D4.C, IC$4.19 (PA9), S$1.P$1 (1), S$1.P$2 (1), S$2.P$1 (1), S$2.P$2 (1)
PIEZONEG: IC$4.13 (PA7), IC$4.20 (PA10), U$2.P$1 (-)
PIEZOPOS: IC$4.12 (PA6), IC$4.21 (PA11), R3.1
SCRCS: IC$3.13 (/CS)
SCRPWR: IC$4.7 (PA1), Q1.P$2 (G), R7.1
SCRRES: IC$3.14 (/RES), IC$4.18 (PA8)
SCRVREG: C7.2, IC$3.6 (VBAT), IC$3.9 (VDD), IC$3.11 (BS1), Q1.P$1 (D), U$1.P$4 (VDD)
SWDCLK/USBD+: IC$4.24 (PA14), U1.D+
SWDIO/USBD-: IC$4.23 (PA13), R1.2, U1.D-
VBAT: C22.1, D2.P$1 (A), IC$9.3 (VBAT), U$3.P$2 (POS)
VCC: C3.2, C20.2, D2.P$2 (C), D3.P$2 (C), IC$6.1 (IN), IC$6.3 (EN), J1.2, R1.1, R14.1, TP1.TP
VREG: C2.1, C4.2, C9.1, C10.2, C17.1, C19.1, IC$1.4 (FB), IC$2.P$1 (VDD), IC$2.P$8 (VDDIO), IC$4.1 (VDD), IC$4.17 (VDD2), L1.2, Q1.P$3 (S), R2.1, R4.1, R5.2, R7.2
VUSB: C23.2, D3.P$1 (A), IC$9.4 (VDD), U1.VBUS

Notes on the sheet:
Battery (3.7V nominal)
Buck regulator LM3671 (outputs 2.8 volts)
Pushbuttons (mouser 611-PTS540JM035SMTRL)
Screen (C2P right, IREF left)
Power muxer
Charges at 100mA
Acellerometer
Linear regulator for ADC voltage supply (outputs 3.3V)
Voltage divider for measuring battery voltage
REFL,NOND
REFL,ND
INC,NOND
INC,ND
5V breakdown

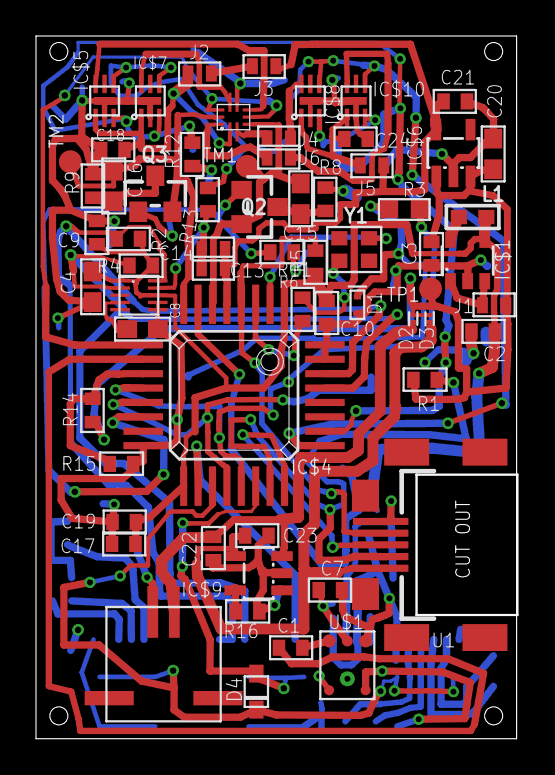
[picture p8: board lightmeter_seeed1.brd from above]

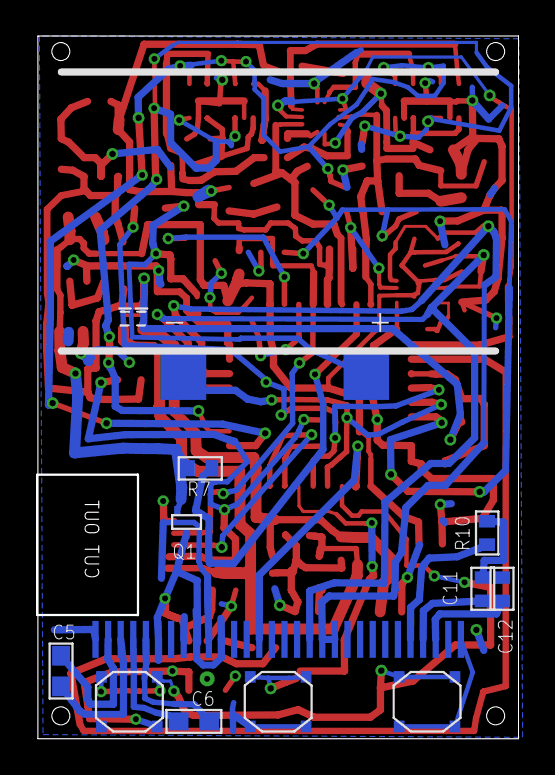
[picture p9: board lightmeter_seeed1.brd from below]

Board: 2 copper layers, 26.7 x 39.0 mm, 76 parts (7 on the bottom side), 50 nets.
