addrummond/lightmeter/schematic/ordered/lightmeter_proto1.brd

## EAGLE design schematic/ordered/lightmeter_proto1.brd (2014-10-13)

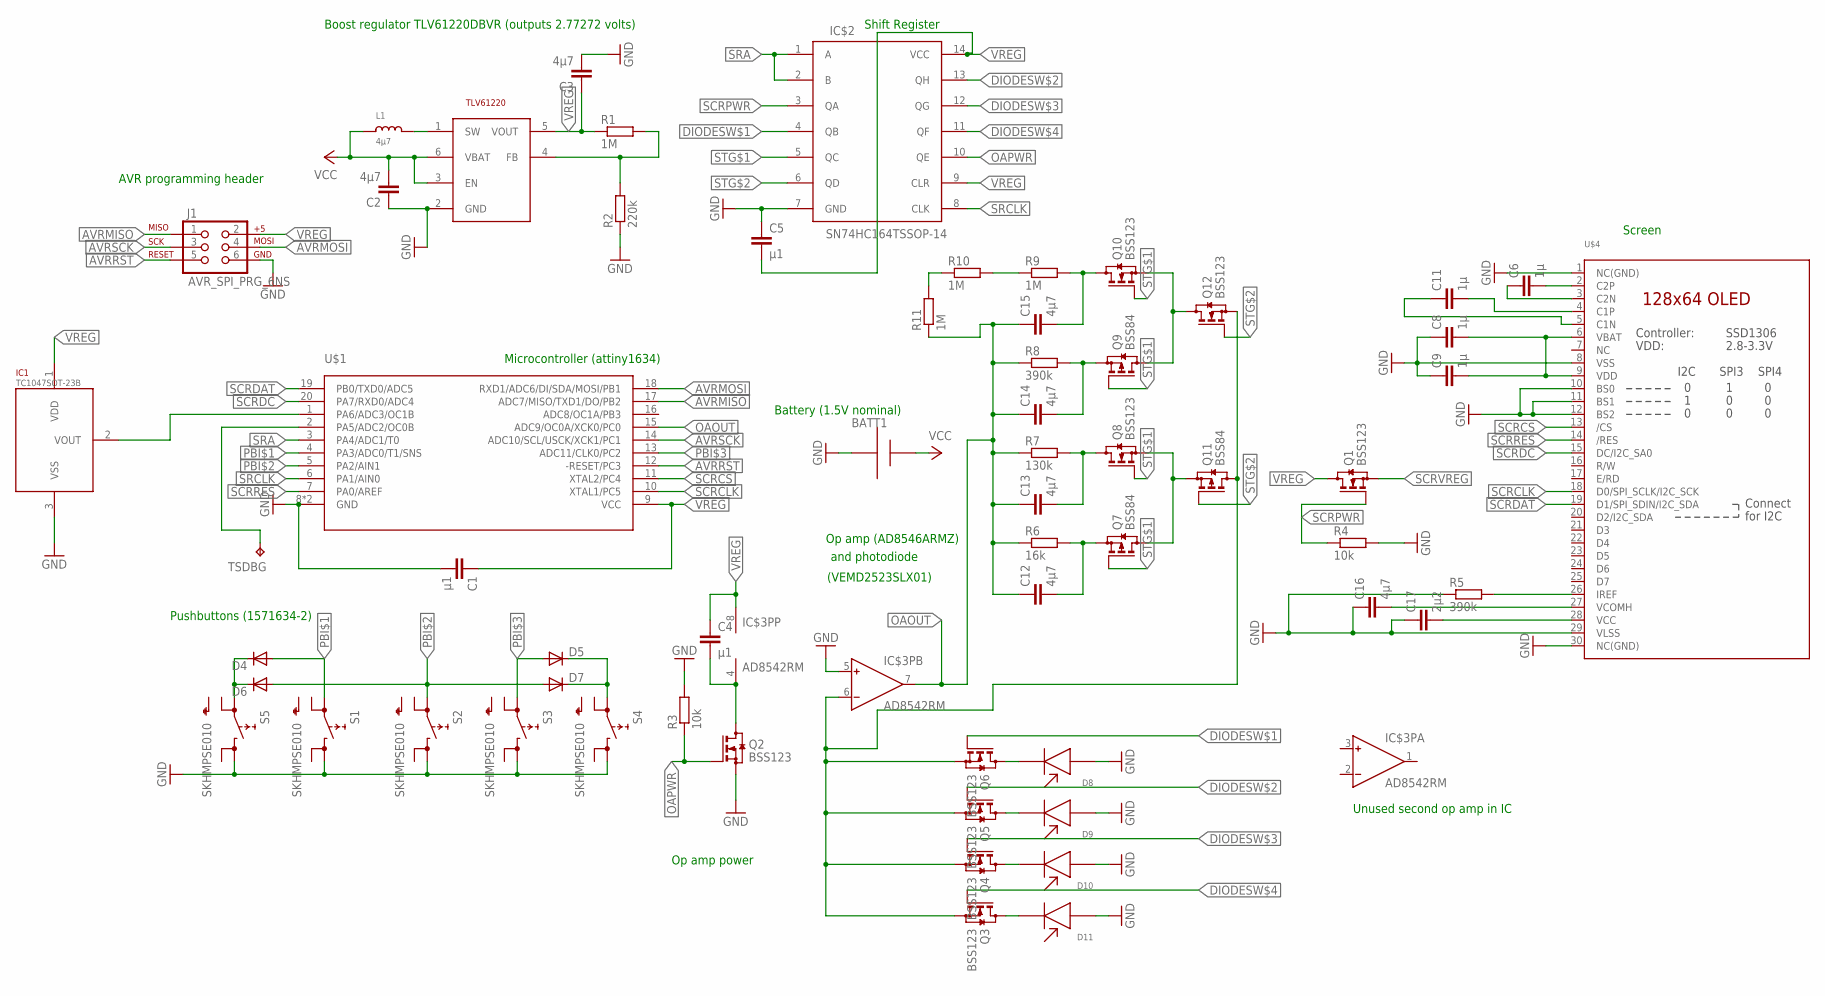
[picture p10: schematic lightmeter_proto1.sch]

Parts:
BATT1: AAA; 12BH412
C1, C4: µ1; C1608
C2, C3: 4µ7; C1608
C5: µ1; C0603K
C6, C8, C9: 1µ; C2012
C11: 1µ; C0402
C12, C13, C14, C15: 4µ7; C2012
C16: 4µ7; C0402
C17: 2µ2; C0402
D4, D5, D6, D7: DIODE-SOD323-W; SOD323-W
D8, D9, D10, D11: VEMD2523SLX01
IC1: TC1047SOT-23B; SOT-23B
IC$1: TI-TLV61220; SOT23-6L
IC$2: SN74HC164TSSOP-14; TSSOP14
IC$3P: AD8542RM; MSOP08
J1: AVR_SPI_PRG_6NS; 2X3-NS
L1: 4µ7; 0805
Q1, Q2, Q3, Q4, Q5, Q6, Q8, Q10, Q12: BSS123; SOT23
Q7, Q9, Q11: BSS84; SOT23
R1, R9, R10, R11: 1M; R2012
R2: 220k; R2012
R3, R4: 10k; R2012
R5: 390k; R0402
R6: 16k; R2012
R7: 130k; R2012
R8: 390k; R2012
S1, S2, S3, S4, S5: SKHMPSE010; SKHMPXE010
TSDBG: TPB1,27; B1,27
U$1: ATTINY1634MLF20; MLF20
U$4: DISP_OLED_UG-2864HSWEG010.96"; UG-2864HSWEG01_0.96IN_WRAPAROUND

Connections:
AVRMISO: J1.1, U$1.17 (ADC7/MISO/TXD1/DO/PB2)
AVRMOSI: J1.4, U$1.18 (RXD1/ADC6/DI/SDA/MOSI/PB1)
AVRRST: J1.5, U$1.12 (-RESET/PC3)
AVRSCK: J1.3, U$1.14 (ADC10/SCL/USCK/XCK1/PC1)
DIODESW$1: IC$2.4 (QB), Q6.1 (G)
DIODESW$2: IC$2.13 (QH), Q5.1 (G)
DIODESW$3: IC$2.12 (QG), Q4.1 (G)
DIODESW$4: IC$2.11 (QF), Q3.1 (G)
GND: BATT1.-, C1.2, C2.1, C3.2, C5.1, C8.1, C9.1, C16.1, C17.1, D8.P$1, D9.P$1, D10.P$1, D11.P$1, IC1.3 (VSS), IC$1.2 (GND), IC$2.7 (GND), IC$3P.5 (IN+), J1.6, Q2.2 (S), R2.1, R3.2, R4.2, R5.1, S1.3 (2.1), S2.3 (2.1), S3.3 (2.1), S4.3 (2.1), S5.3 (2.1), U$1.8 (GND), U$1.GND, U$4.1 (NC(GND)), U$4.8 (VSS), U$4.10 (BS0), U$4.11 (BS1), U$4.12 (BS2), U$4.29 (VLSS), U$4.30 (NC(GND))
unnamed: IC$1.1 (SW), L1.2
unnamed: D8.P$2, Q6.3 (D)
unnamed: C14.2, Q9.2 (S), R8.2
unnamed: C12.2, Q7.2 (S), R6.2
unnamed: D9.P$2, Q5.3 (D)
unnamed: C4.2, IC$3P.4 (V-), Q2.3 (D)
unnamed: D5.C, D7.C, S4.1 (1.1)
unnamed: D4.C, D6.C, S5.1 (1.1)
unnamed: D10.P$2, Q4.3 (D)
unnamed: IC$1.4 (FB), R1.2, R2.2
unnamed: D11.P$2, Q3.3 (D)
unnamed: C16.2, U$4.27 (VCOMH)
unnamed: R9.1, R10.2
unnamed: C13.2, Q8.3 (D), R7.2
unnamed: C6.2, U$4.2 (C2P)
unnamed: C6.1, U$4.3 (C2N)
unnamed: C8.2, C9.2, U$4.6 (VBAT), U$4.9 (VDD)
unnamed: R10.1, R11.2
unnamed: R5.2, U$4.26 (IREF)
unnamed: Q9.3 (D), Q10.2 (S), Q12.3 (D)
unnamed: C15.2, Q10.3 (D), R9.2
unnamed: Q7.3 (D), Q8.2 (S), Q11.2 (S)
unnamed: TSDBG.TP, U$1.2 (PA5/ADC2/OC0B)
unnamed: C11.1, U$4.5 (C1N)
unnamed: C17.2, U$4.28 (VCC)
unnamed: IC$3P.6 (IN-), Q3.2 (S), Q4.2 (S), Q5.2 (S), Q6.2 (S), Q11.3 (D), Q12.2 (S)
unnamed: C11.2, U$4.4 (C1P)
unnamed: IC1.2 (VOUT), U$1.1 (PA6/ADC3/OC1B)
OAOUT: C12.1, C13.1, C14.1, C15.1, IC$3P.7 (OUT), R6.1, R7.1, R8.1, R11.1, U$1.15 (ADC9/OC0A/XCK0/PC0)
OAPWR: IC$2.10 (QE), Q2.1 (G), R3.1
PBI$1: D4.A, S1.1 (1.1), U$1.4 (PA3/ADC0/T1/SNS)
PBI$2: D6.A, D7.A, S2.1 (1.1), U$1.5 (PA2/AIN1)
PBI$3: D5.A, S3.1 (1.1), U$1.13 (ADC11/CLK0/PC2)
SCRCLK: U$1.10 (XTAL1/PC5), U$4.18 (D0/SPI_SCLK/I2C_SCK)
SCRCS: U$1.11 (XTAL2/PC4), U$4.13 (/CS)
SCRDAT: U$1.19 (PB0/TXD0/ADC5), U$4.19 (D1/SPI_SDIN/I2C_SDA)
SCRDC: U$1.20 (PA7/RXD0/ADC4), U$4.15 (DC/I2C_SA0)
SCRPWR: IC$2.3 (QA), Q1.1 (G), R4.1
SCRRES: U$1.7 (PA0/AREF), U$4.14 (/RES)
SCRVREG: Q1.2 (S)
SRA: IC$2.1 (A), IC$2.2 (B), U$1.3 (PA4/ADC1/T0)
SRCLK: IC$2.8 (CLK), U$1.6 (PA1/AIN0)
STG$1: IC$2.5 (QC), Q7.1 (G), Q8.1 (G), Q9.1 (G), Q10.1 (G)
STG$2: IC$2.6 (QD), Q11.1 (G), Q12.1 (G)
VCC: BATT1.+, C2.2, IC$1.3 (EN), IC$1.6 (VBAT), L1.1
VREG: C1.1, C3.1, C4.1, C5.2, IC1.1 (VDD), IC$1.5 (VOUT), IC$2.9 (CLR), IC$2.14 (VCC), IC$3P.8 (V+), J1.2, Q1.3 (D), R1.1, U$1.9 (VCC)

Notes on the sheet:
Shift Register
Battery (1.5V nominal)
Boost regulator TLV61220DBVR (outputs 2.77272 volts)
Op amp (AD8546ARMZ)
Pushbuttons (1571634-2)
Microcontroller (attiny1634)
Screen
AVR programming header
and photodiode
(VEMD2523SLX01)
Unused second op amp in IC
Op amp power

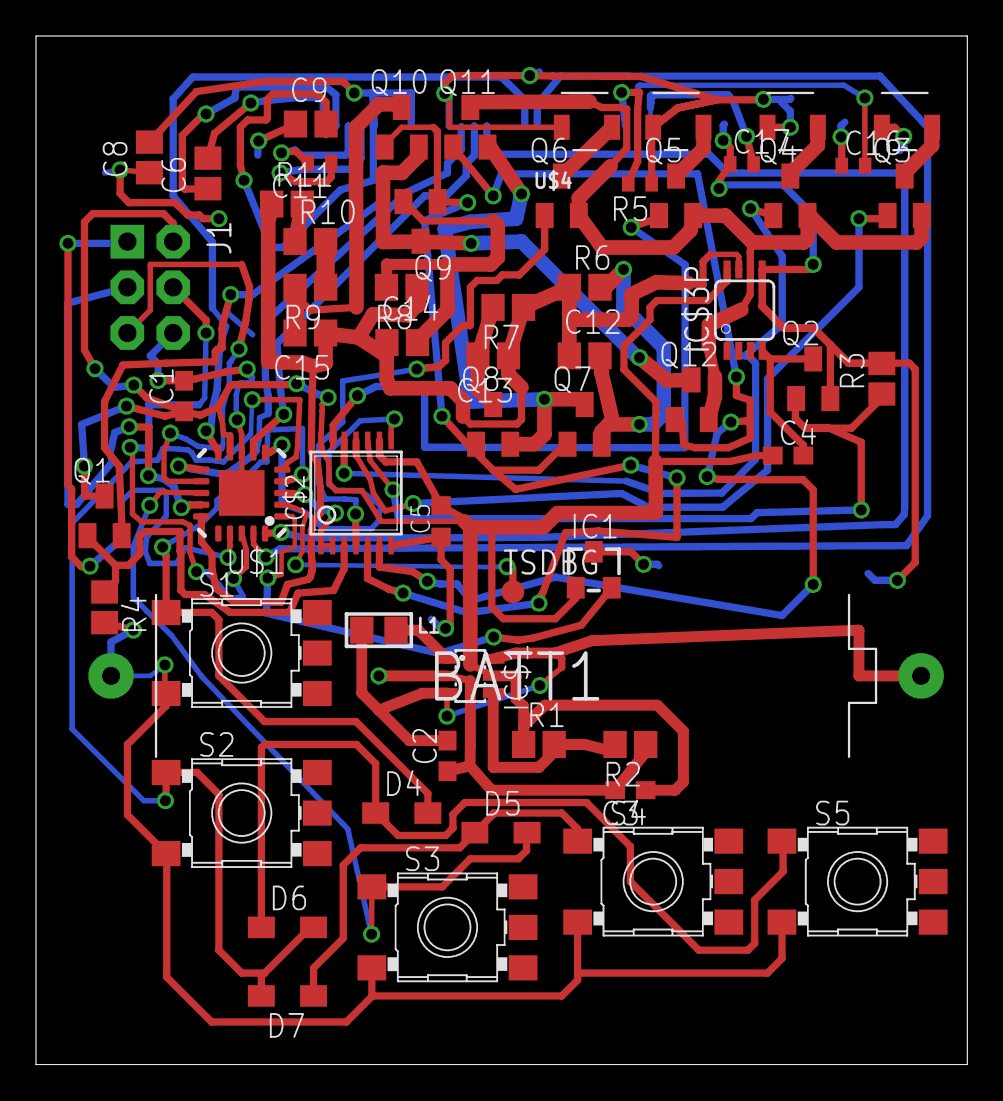
[picture p11: board lightmeter_proto1.brd from above]

Board: 2 copper layers, 51.7 x 57.1 mm, 61 parts (0 on the bottom side), 54 nets.
