addrummond/lightmeter/schematic/ordered/lightmeter_proto3.brd

## EAGLE design schematic/ordered/lightmeter_proto3.brd (2015-01-06)

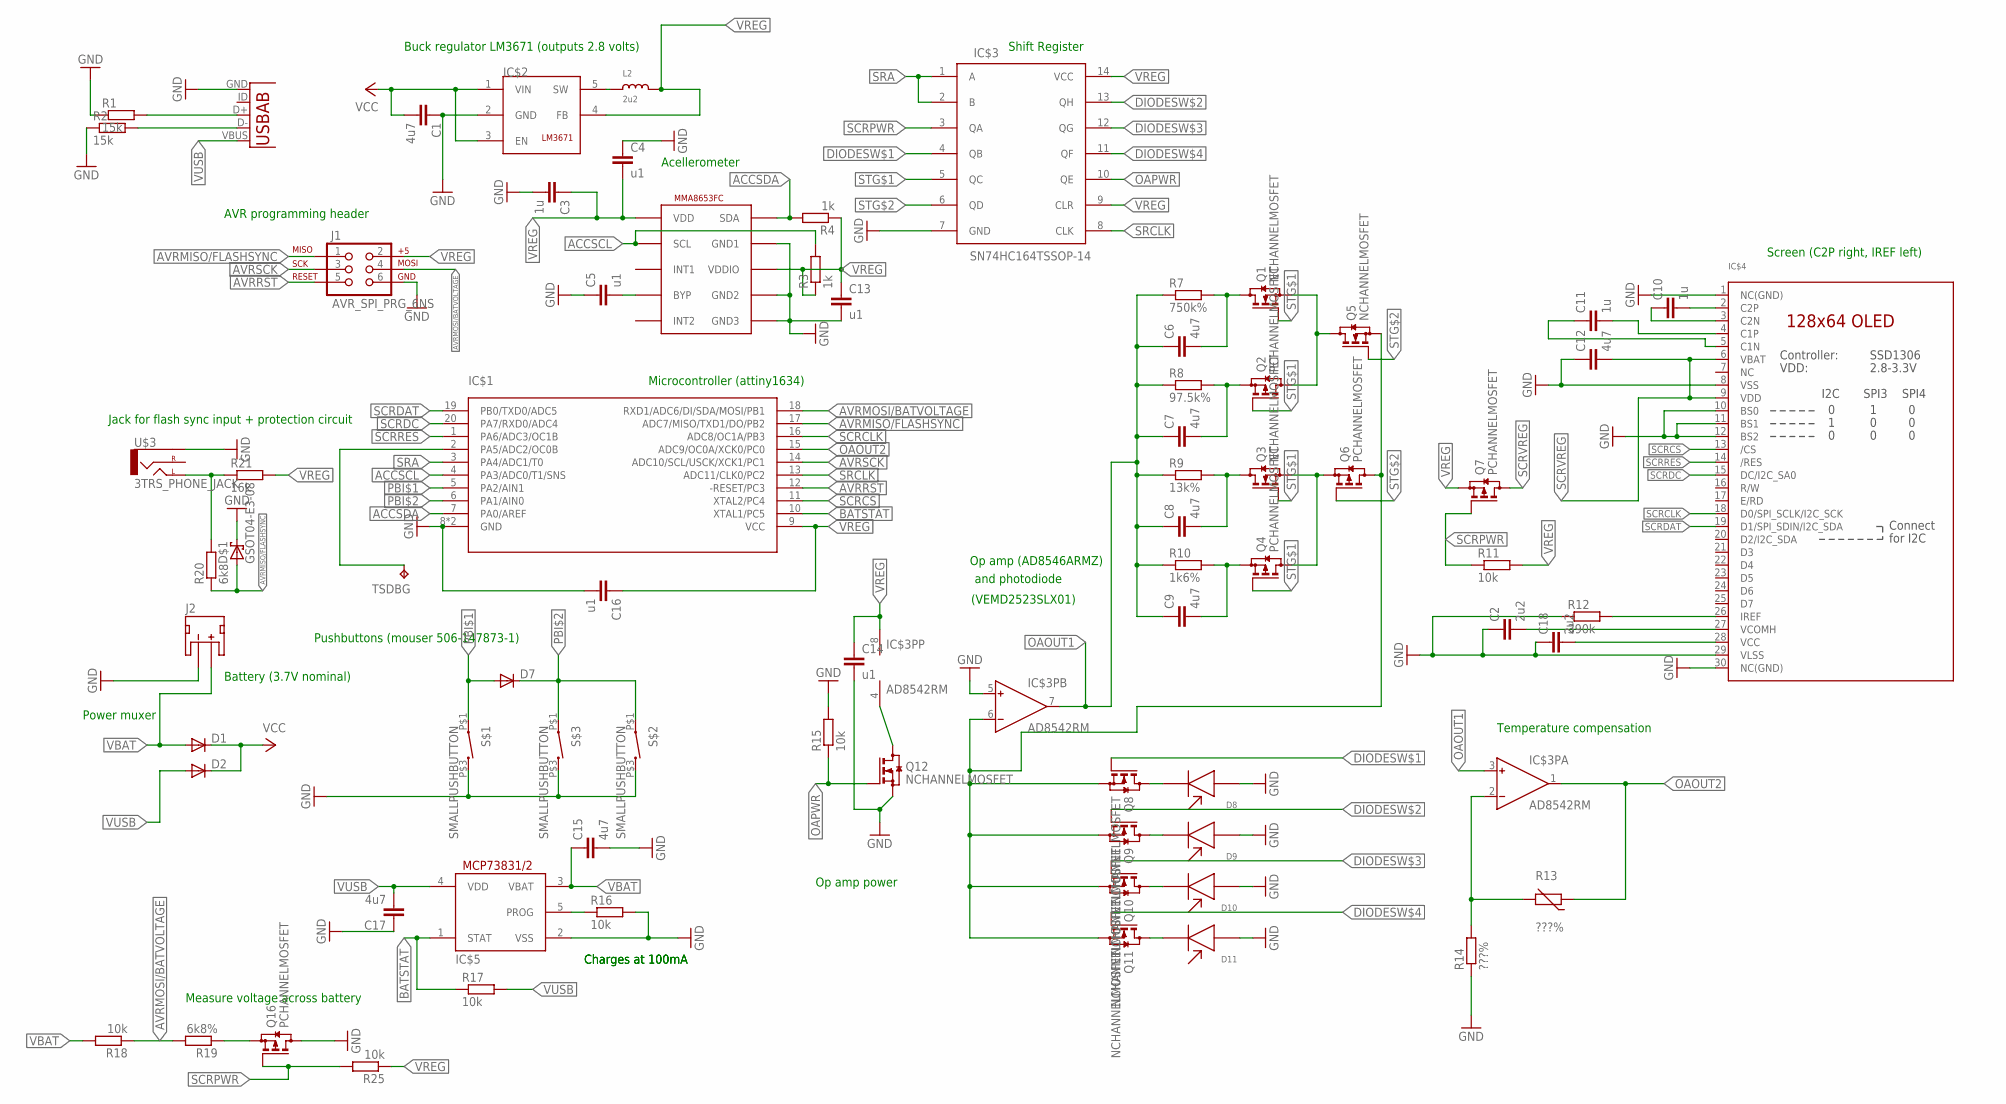
[picture p12: schematic lightmeter_proto3.sch]

Parts:
C1, C6, C7, C8, C9, C12, C15, C17: 4u7; C0402
C2, C18: 2u2; C0402
C3, C10, C11: 1u; C0402
C4, C5, C13, C14, C16: u1; C0402
D1, D2, D7: DIODE-SOD323-W; SOD323-W
D8, D9, D10, D11: VEMD2523SLX01
D$1: GSOT04-E3-08; SOT23
IC$1: ATTINY1634MLF20; MLF20
IC$2: LM3671; SOT23-5
IC$3: SN74HC164TSSOP-14; TSSOP14
IC$3P: AD8542RM; MSOP08
IC$4: DISP_OLED_UG-2864HSWEG010.96"; UG-2864HSWEG01_0.96IN_WRAPAROUND
IC$5: MCP73831/OT; SOT23-5L
IC$6: MMA8653; DFN-10
J1: AVR_SPI_PRG_6NS; 2X3-NS
J2: JST_2MM_MALE; JST-2-SMD
L2: 2u2; _0603
Q1, Q3, Q5, Q8, Q9, Q10, Q11, Q12: NCHANNELMOSFET; SOT-416-3
Q2, Q4, Q6, Q7, Q16: PCHANNELMOSFET; SOT-416-3
R1, R2: 15k; R0402
R3, R4: 1k; R0402
R7: 750k%; R0402
R8: 97.5k%; R0402
R9: 13k%; R0402
R10: 1k6%; R0402
R11, R15, R16, R17, R18, R25: 10k; R0402
R12: 390k; R0402
R13, R14: ???%; R0402
R19: 6k8%; R0402
R20: 6k8; R0402
R21: 16k; R0402
S$1, S$2, S$3: SMALLPUSHBUTTON; BUTTON
TSDBG: TPPAD1-13; P1-13
U1: USB-AB; USB-AB-MICRO
U$3: 3TRS_PHONE_JACK; 3TRS-SMD

Connections:
ACCSCL: IC$1.4 (PA3/ADC0/T1/SNS), IC$6.P$2 (SCL), R3.2
ACCSDA: IC$1.7 (PA0/AREF), IC$6.P$10 (SDA), R4.2
AVRMISO/FLASHSYNC: D$1.1 (A), IC$1.17 (ADC7/MISO/TXD1/DO/PB2), J1.1, R20.1
AVRMOSI/BATVOLTAGE: IC$1.18 (RXD1/ADC6/DI/SDA/MOSI/PB1), J1.4, R18.1, R19.2
AVRRST: IC$1.12 (-RESET/PC3), J1.5
AVRSCK: IC$1.14 (ADC10/SCL/USCK/XCK1/PC1), J1.3
BATSTAT: IC$1.10 (XTAL1/PC5), IC$5.1 (STAT), R17.1
DIODESW$1: IC$3.4 (QB), Q8.P$1 (G)
DIODESW$2: IC$3.13 (QH), Q9.P$1 (G)
DIODESW$3: IC$3.12 (QG), Q10.P$1 (G)
DIODESW$4: IC$3.11 (QF), Q11.P$1 (G)
GND: C1.1, C2.1, C3.2, C4.1, C5.1, C12.1, C13.2, C14.2, C15.2, C16.2, C17.1, C18.1, D8.P$1, D9.P$1, D10.P$1, D11.P$1, D$1.3 (C), IC$1.8 (GND), IC$1.GND, IC$2.2 (GND), IC$3.7 (GND), IC$3P.5 (IN+), IC$4.1 (NC(GND)), IC$4.8 (VSS), IC$4.10 (BS0), IC$4.11 (BS1), IC$4.12 (BS2), IC$4.29 (VLSS), IC$4.30 (NC(GND)), IC$5.2 (VSS), IC$6.P$6 (GND3), IC$6.P$7 (GND2), IC$6.P$9 (GND1), J1.6, J2.1 (-), Q12.P$2 (S), Q16.P$3 (D), R1.1, R2.1, R12.1, R14.1, R15.2, R16.2, S$1.P$3 (2), S$2.P$3 (2), S$3.P$3 (2), U1.GND, U$3.P$1 (SLEEVE)
unnamed: D8.P$2, Q8.P$3 (D)
unnamed: D9.P$2, Q9.P$3 (D)
unnamed: C7.2, Q2.P$2 (S), R8.2
unnamed: C9.2, Q4.P$2 (S), R10.2
unnamed: IC$5.5 (PROG), R16.1
unnamed: IC$3P.4 (V-), Q12.P$3 (D)
unnamed: C5.2, IC$6.P$4 (BYP)
unnamed: D10.P$2, Q10.P$3 (D)
unnamed: IC$2.5 (SW), L2.1
unnamed: D11.P$2, Q11.P$3 (D)
unnamed: C2.2, IC$4.27 (VCOMH)
unnamed: C8.2, Q3.P$3 (D), R9.2
unnamed: C10.2, IC$4.2 (C2P)
unnamed: C10.1, IC$4.3 (C2N)
unnamed: Q16.P$2 (S), R19.1
unnamed: IC$4.26 (IREF), R12.2
unnamed: Q1.P$2 (S), Q2.P$3 (D), Q5.P$3 (D)
unnamed: C6.2, Q1.P$3 (D), R7.2
unnamed: Q3.P$2 (S), Q4.P$3 (D), Q6.P$2 (S)
unnamed: IC$1.2 (PA5/ADC2/OC0B), TSDBG.TP
unnamed: C11.1, IC$4.5 (C1N)
unnamed: IC$3P.6 (IN-), Q5.P$2 (S), Q6.P$3 (D), Q8.P$2 (S), Q9.P$2 (S), Q10.P$2 (S), Q11.P$2 (S)
unnamed: C11.2, IC$4.4 (C1P)
unnamed: R1.2, U1.D+
unnamed: R20.2, R21.1, U$3.P$3 (LEFT)
unnamed: C18.2, IC$4.28 (VCC)
unnamed: IC$3P.2 (IN-), R13.2, R14.2
unnamed: R2.2, U1.D-
OAOUT1: C6.1, C7.1, C8.1, C9.1, IC$3P.3 (IN+), IC$3P.7 (OUT), R7.1, R8.1, R9.1, R10.1
OAOUT2: IC$1.15 (ADC9/OC0A/XCK0/PC0), IC$3P.1 (OUT), R13.1
OAPWR: IC$3.10 (QE), Q12.P$1 (G), R15.1
PBI$1: D7.A, IC$1.5 (PA2/AIN1), S$1.P$1 (1)
PBI$2: D7.C, IC$1.6 (PA1/AIN0), S$2.P$1 (1), S$3.P$1 (1)
SCRCLK: IC$1.16 (ADC8/OC1A/PB3), IC$4.18 (D0/SPI_SCLK/I2C_SCK)
SCRCS: IC$1.11 (XTAL2/PC4), IC$4.13 (/CS)
SCRDAT: IC$1.19 (PB0/TXD0/ADC5), IC$4.19 (D1/SPI_SDIN/I2C_SDA)
SCRDC: IC$1.20 (PA7/RXD0/ADC4), IC$4.15 (DC/I2C_SA0)
SCRPWR: IC$3.3 (QA), Q7.P$1 (G), Q16.P$1 (G), R11.1, R25.2
SCRRES: IC$1.1 (PA6/ADC3/OC1B), IC$4.14 (/RES)
SCRVREG: C12.2, IC$4.6 (VBAT), IC$4.9 (VDD), Q7.P$3 (D)
SRA: IC$1.3 (PA4/ADC1/T0), IC$3.1 (A), IC$3.2 (B)
SRCLK: IC$1.13 (ADC11/CLK0/PC2), IC$3.8 (CLK)
STG$1: IC$3.5 (QC), Q1.P$1 (G), Q2.P$1 (G), Q3.P$1 (G), Q4.P$1 (G)
STG$2: IC$3.6 (QD), Q5.P$1 (G), Q6.P$1 (G)
VBAT: C15.1, D1.A, IC$5.3 (VBAT), J2.2 (+), R18.2
VCC: C1.2, D1.C, D2.C, IC$2.1 (VIN), IC$2.3 (EN)
VREG: C3.1, C4.2, C13.1, C14.1, C16.1, IC$1.9 (VCC), IC$2.4 (FB), IC$3.9 (CLR), IC$3.14 (VCC), IC$3P.8 (V+), IC$6.P$1 (VDD), IC$6.P$8 (VDDIO), J1.2, L2.2, Q7.P$2 (S), R3.1, R4.1, R11.2, R21.2, R25.1
VUSB: C17.2, D2.A, IC$5.4 (VDD), R17.2, U1.VBUS

Notes on the sheet:
Shift Register
Battery (3.7V nominal)
Buck regulator LM3671 (outputs 2.8 volts)
Op amp (AD8546ARMZ)
Pushbuttons (mouser 506-147873-1)
Microcontroller (attiny1634)
Screen (C2P right, IREF left)
AVR programming header
and photodiode
(VEMD2523SLX01)
Temperature compensation
Op amp power
Power muxer
Jack for flash sync input + protection circuit
Charges at 100mA
Measure voltage across battery
Acellerometer

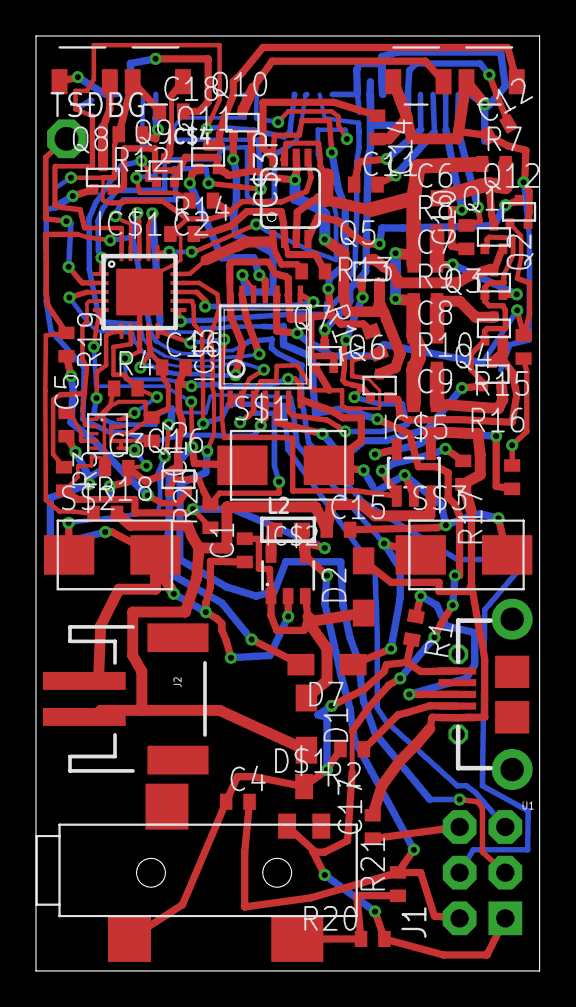
[picture p13: board lightmeter_proto3.brd from above]

Board: 2 copper layers, 28.0 x 51.9 mm, 75 parts (0 on the bottom side), 60 nets.
