addrummond/lightmeter/schematic/ordered/swdtousb_seeed.brd

## EAGLE design schematic/ordered/swdtousb_seeed.brd (2015-03-21)

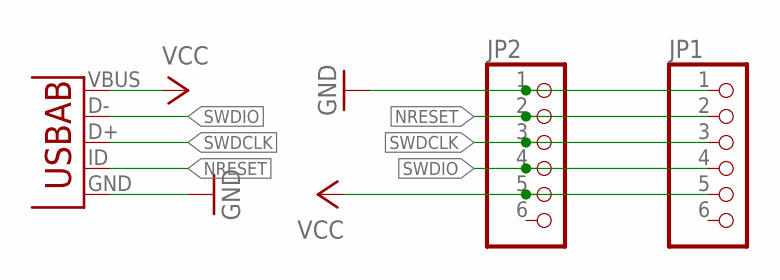
[picture p14: schematic swdtousb_seeed.sch]

Parts:
JP1, JP2: PINHD-1X6; 1X06
U1: USB-AB; USB-AB-MICRO

Connections:
GND: JP1.1, JP2.1, U1.GND
NRESET: JP1.2, JP2.2, U1.ID (USBID)
SWDCLK: JP1.3, JP2.3, U1.D+
SWDIO: JP1.4, JP2.4, U1.D-
VCC: JP1.5, JP2.5, U1.VBUS

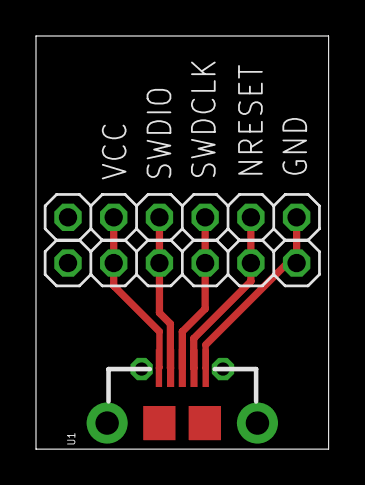
[picture p15: board swdtousb_seeed.brd from above]

Board: 2 copper layers, 16.3 x 23.0 mm, 3 parts (0 on the bottom side), 5 nets.
