addrummond/lightmeter/firmware/piezo.h

#ifndef PIEZO_H
#define PIEZO_H

#include <stdint.h>
#include <stdbool.h>
#include <goetzel.h>
#include <stm32f0xx_misc.h>
#include <stm32f0xx_dma.h>
#include <stm32f0xx_adc.h>

#define PIEZO_MIC_BUFFER_N_SAMPLES 80

void piezo_mic_init(void);
void piezo_mic_deinit(void);

void piezo_mic_read_buffer();
int32_t piezo_get_magnitude();

void piezo_out_init(void);
void piezo_set_period(unsigned channels, uint16_t period);
void piezo_turn_on(unsigned channels);
void piezo_pause(unsigned channels);
void piezo_unpause(unsigned channels);
void piezo_out_deinit(void);

bool piezo_read_data(uint8_t *buffer, unsigned nbits);

extern __IO int16_t piezo_mic_buffer[];

#endif
