addrummond/lightmeter/firmware/myassert.h

#ifndef MYASSERT_H
#define MYASSERT_H

#include <stdint.h>

#ifdef TEST
#include <assert.h>
#else

#ifdef USE_FULL_ASSERT
#define assert_param(expr) ((expr) ? (void)0 : assert_failed((uint8_t *)__FILE__, __LINE__))
void assert_failed(uint8_t* file, uint32_t line);
#else
#define assert_param(expr) ((void)0)
#endif

#define assert(x) assert_param(x)

#endif

#endif
