addrummond/lightmeter/firmware/ui.c

#include <deviceconfig.h>
#include <ui.h>
#include <bcd.h>
#include <display.h>
#include <bitmaps/bitmaps.h>
#include <exposure.h>
#include <stdlib.h>
#include <stdbool.h>
#include <accel.h>
#include <debugging.h>
#include <mymemset.h>
#include <myassert.h>
#include <menus/menu_strings.h>

// Python 3: [(int(round((190*math.exp(x/16))/4500000000))//100) for x in range(512,256,-1)][:32]
// NOTE: Should be bit-shifted up by 1.
static const uint16_t VERTICAL_SCROLL_DELAYS[] = {
    33339, 31319, 29422, 27639, 25965, 24392, 22914, 21525, 20221, 18996, 17845, 16764, 15748, 14794, 13898, 13056, 12265, 11521, 10823, 10168, 9552, 8973, 8429, 7918, 7439, 6988, 6565, 6167, 5793, 5442, 5112, 4803
};

//
// Modularizing the display code takes a little bit of care when
// we're not buffering the entire screen area. We will often want
// have multiple ui widgets drawing to the same page. E.g., if one line is
// 12px high, then other ui widgets might
// want to draw on the remaining 4px of the second page. The basic
// strategy here is to have a function for each widget which
// renders some number of columns of the widget at the specified x value.
// In cases where multiple widgets are being displayed on overlapping
// pages, the corresponding functions can then each be called in
// each iteration of a loop.
//

#define ms global_meter_state
#define tms global_transient_meter_state

static void show_reading()
{
    uint8_t i;
    uint8_t out[6];
    memset8_zero(out, sizeof(out));
    ui_top_status_line_state_t state0;
    memset8_zero(&state0, sizeof(state0));
    for (i = 0; i < DISPLAY_LCDWIDTH; i += 6) {
        memset8_zero(out, sizeof(out));
        ui_top_status_line_at_6col(&state0, out, 1, i);
        display_write_page_array(out, 6, 1, i, 0);
    }

    uint8_t out2[24];
    memset8_zero(out2, sizeof(out2));
    ui_main_reading_display_state_t state;
    memset8_zero(&state, sizeof(state));
    //static uint8_t val = 0;
    for (i = 0; i < DISPLAY_LCDWIDTH; i += 8) {
        memset8_zero(out2, sizeof(out2));
        ui_main_reading_display_at_8col(&state, out2, 3, i);
        //out2[0] = val++;
        display_write_page_array(out2, 8, 3, i, 3);
    }

    ui_bttm_status_line_state_t state2;
    memset8_zero(out, sizeof(out));
    memset8_zero(&state2, sizeof(state2));
    for (i = 0; DISPLAY_LCDWIDTH - i >= 6; i += 6) {
        memset8_zero(out, sizeof(out));
        ui_bttm_status_line_at_6col(&state2, out, 1, i);
        display_write_page_array(out, 6, 1, i, 7);
    }
}

static uint8_t down_from(uint8_t max, uint8_t i, uint8_t down)
{
    if (i >= down)
        return i-down;
    else
        return max - (down - i);
}

static uint8_t up_from(uint8_t max, uint8_t i, uint8_t up)
{
    if (i + up < max)
        return i + up;
    else
        return i - max;
}

const const_ptr_to_uint8_t ui_main_menu_strings[] = {
    MENU_STRING_ISO,
    MENU_STRING_PRIORITY_MODE,
    MENU_STRING_PRECISION,
    MENU_STRING_CINEMATOGRAPHY,
    MENU_STRING_SETTINGS
};
#define NUM_MAIN_MENU_STRINGS (sizeof(ui_main_menu_strings)/sizeof(const_ptr_to_uint8_t))
#define MMS(i) ((const_ptr_to_uint8_t)ui_main_menu_strings[(i)])

static uint8_t menu_bwrite_12px_char(uint8_t code, uint8_t *buf, uint8_t voffset)
{
    if (code == MENU_STRING_SPECIAL_SPACE)
        return 0;
    if (code == 0)
        return 1;
    display_bwrite_12px_char(CHAR_12PX_GRIDS + CHAR_OFFSET_FROM_CODE_12PX(code), buf, DISPLAY_NUM_PAGES, voffset);
    return 0;
}

static uint8_t center_item_pages_from_start_line(uint8_t start_line)
{
    int sl = start_line;
    sl -= DISPLAY_LCDHEIGHT/2;
    if (sl < 0)
        sl += DISPLAY_LCDHEIGHT;
    sl /= 8;
    return (uint8_t)sl;
}

// Starts at pixel vindex=25, which is one pixel below beginning of third page.
static const uint8_t arrow_page_array1[] = {
    0b11111110,
    0b11111100,
    0b01111000,
    0b00110000,
};
static const uint8_t arrow_page_array2[] = {
    0b00000001,
    0b00000000,
    0b00000000,
    0b00000000
};
static const uint8_t arrow_erase_page_array[] = {
    0b00000000,
    0b00000000,
    0b00000000,
    0b00000000,
    0b00000000,
    0b00000000,
    0b00000000,
    0b00000000
};

#define MENU_ARROW_WIDTH (sizeof(arrow_page_array1)/sizeof(arrow_page_array1[0]))

static void draw_main_menu_arrow()
{
    uint8_t old_first_page = center_item_pages_from_start_line(ms.ui_mode_state .main_menu.last_start_line);
    uint8_t first_page = center_item_pages_from_start_line(ms.ui_mode_state.main_menu.start_line);
    uint8_t second_page = first_page + 1;
    if (second_page > 7)
        second_page = 8 - second_page;

    display_write_page_array(arrow_erase_page_array, (sizeof(arrow_erase_page_array)/sizeof(arrow_erase_page_array[0]))/2, 2, 0, old_first_page);
    int arrow_y = ((int)DISPLAY_LCDHEIGHT)/2 - (int)(ms.ui_mode_state.main_menu.start_line);
    if (arrow_y < 0)
        arrow_y = DISPLAY_LCDHEIGHT + arrow_y;
    else if (arrow_y >= DISPLAY_LCDHEIGHT)
        arrow_y -= DISPLAY_LCDHEIGHT;
    display_write_page_array(arrow_page_array1, sizeof(arrow_page_array1)/sizeof(arrow_page_array1[0]), 1, 0, first_page);
    display_write_page_array(arrow_page_array2, sizeof(arrow_page_array2)/sizeof(arrow_page_array2[0]), 1, 0, second_page);
}

static void show_main_menu(uint32_t ticks_since_ui_last_shown, bool first_time)
{
    // TEMP HACK.
    const int item_index = 0;
    const uint8_t voffset = 0;

    assert(NUM_MAIN_MENU_STRINGS >= 5);
    assert(voffset < UI_MENU_VOFFSET_MAX);

    if (first_time) {
        display_command(DISPLAY_SETSTARTLINE + 0);
        // Selected item is in the middle, with two above it and two below it.

        // Menu item 1. 1st and 2nd pages, 1px offset
        //           2. 2nd and 3rd pages, 5px offset
        //           3. 3rd and 4th pages, 1px offset
        //           4. 4th and 5th pages, 5px offset
        //           5. 5th and 6th pages, 1px offset

        uint8_t center_str[MENU_MAX_SHORT_STRING_LENGTH+1];
        uint8_t top1_str[MENU_MAX_SHORT_STRING_LENGTH+1];
        uint8_t top2_str[MENU_MAX_SHORT_STRING_LENGTH+1];
        uint8_t bttm1_str[MENU_MAX_SHORT_STRING_LENGTH+1];
        uint8_t bttm2_str[MENU_MAX_SHORT_STRING_LENGTH+1];

        // Write selected (center) item.
        menu_string_decode_short(MMS(item_index), center_str);
        // Write other items.
        menu_string_decode_short(MMS(down_from(NUM_MAIN_MENU_STRINGS, item_index, 1)), top1_str);
        menu_string_decode_short(MMS(down_from(NUM_MAIN_MENU_STRINGS, item_index, 2)), top2_str);
        menu_string_decode_short(MMS(up_from(NUM_MAIN_MENU_STRINGS, item_index, 1)), bttm1_str);
        menu_string_decode_short(MMS(up_from(NUM_MAIN_MENU_STRINGS, item_index, 2)), bttm2_str);

        // Generated via gen_ks_in_show_main_menu_in_ui.c.py.
        static const uint8_t ks[] = {
            0,1,3,4,6,
            0,5,2,7,4,

            0,1,3,5,6,
            1,6,3,0,5,

            0,1,3,5,6,
            2,7,4,1,6,

            0,2,3,5,6,
            3,0,5,2,7,

            0,2,3,5,7,
            4,1,6,3,0,

            0,2,3,5,7,
            5,2,7,4,1,

            0,2,4,5,7,
            6,3,0,5,2,

            0,2,4,5,7,
            7,4,1,6,3,

            1,2,4,5,7,
            0,5,2,7,4,

            1,2,4,6,7,
            1,6,3,0,5,

            1,2,4,6,7,
            2,7,4,1,6,

            1,3,4,6,7,
            3,0,5,2,7,
        };

        uint8_t i;
        uint8_t buf[CHAR_WIDTH_12PX*(DISPLAY_NUM_PAGES+1)];
        uint_fast8_t finished_mask = 0;
        for (i = 0; i < DISPLAY_LCDWIDTH/8 && finished_mask != 0b11111; ++i) {
            memset8_zero(buf, sizeof(buf));

            if (! (finished_mask & 0b1))
                finished_mask |= menu_bwrite_12px_char(top1_str[i], buf+ks[(voffset*10)+0], ks[(voffset*10)+5]);
            if (! (finished_mask & 0b10))
                finished_mask |= (menu_bwrite_12px_char(top2_str[i], buf+ks[(voffset*10)+1], ks[(voffset*10)+6]) << 1);
            if (! (finished_mask & 0b100))
                finished_mask |= (menu_bwrite_12px_char(center_str[i], buf+ks[(voffset*10)+2], ks[(voffset*10)+7]) << 2);
            if (! (finished_mask & 0b1000))
                finished_mask |= (menu_bwrite_12px_char(bttm1_str[i], buf+ks[(voffset*10)+3], ks[(voffset*10)+8]) << 3);
            if (!(finished_mask & 0b10000))
                finished_mask |= (menu_bwrite_12px_char(bttm2_str[i], buf+ks[(voffset*10)+4], ks[(voffset*10)+9]) << 4);

            display_write_page_array(
                buf,
                CHAR_WIDTH_12PX,                             // ncols
                DISPLAY_NUM_PAGES,                           // pages_per_col
                MENU_ARROW_WIDTH + 2 + (i*CHAR_WIDTH_12PX),  // x
                0                                            // y
            );
        }

        draw_main_menu_arrow();
    }

    int8_t a = accel_read_register(ACCEL_REG_OUT_Y_MSB);
    if (a > -5 && a < 5) {
        a = 0;
        ms.ui_mode_state.main_menu.current_accel_y = 0;
        ms.ui_mode_state.main_menu.ticks_waited = 0;
    }
    else if ((a > 0 && ms.ui_mode_state.main_menu.current_accel_y < 0) ||
             (a < 0 && ms.ui_mode_state.main_menu.current_accel_y > 0)) {
        ms.ui_mode_state.main_menu.current_accel_y = 0;
        ms.ui_mode_state.main_menu.ticks_waited = 0;
    }
    else {
        ms.ui_mode_state.main_menu.ticks_waited += ticks_since_ui_last_shown;
        int pa = a;
        if (pa < 0)
            pa = -pa;
        int in = pa/2;
        if (in > sizeof(VERTICAL_SCROLL_DELAYS)/sizeof(VERTICAL_SCROLL_DELAYS[0]))
            in = (sizeof(VERTICAL_SCROLL_DELAYS)/sizeof(VERTICAL_SCROLL_DELAYS[0]))-1;
        uint32_t dt = ((uint32_t)VERTICAL_SCROLL_DELAYS[in]) << 1;

        if (ms.ui_mode_state.main_menu.ticks_waited >= dt) {
            ms.ui_mode_state.main_menu.ticks_waited = 0;

            // Scroll menu.
            int sl = ms.ui_mode_state.main_menu.start_line;
            if (a < 0)
                --sl;
            else
                ++sl;
            if (sl >= DISPLAY_LCDHEIGHT)
                sl -= DISPLAY_LCDHEIGHT;
            else if (sl < 0)
                sl = DISPLAY_LCDHEIGHT + sl;

            display_command(DISPLAY_SETSTARTLINE + sl);

            ms.ui_mode_state.main_menu.start_line = (uint8_t)sl;

            if (sl % 12 == 0) {
                // Draw arrow on right indicating that center item is currently selected.
                draw_main_menu_arrow();
                ms.ui_mode_state.main_menu.last_start_line = ms.ui_mode_state.main_menu.start_line;
            }
        }
    }
}

static void show_init()
{
    uint8_t pages[8];
    unsigned i;
    for (i = 0; i < 8; ++i) {
        pages[i] = 0xFF;
    }
    display_command(DISPLAY_SETSTARTLINE + 0);
    display_write_page_array(pages, 8, 1, (DISPLAY_LCDWIDTH/2)+4, DISPLAY_NUM_PAGES/2);
}

static void show_metering()
{
    uint8_t pages[8];
    unsigned i;
    for (i = 0; i < 8; ++i) {
        pages[i] = 0b10101010;
    }
    display_command(DISPLAY_SETSTARTLINE + 0);
    display_write_page_array(pages, 8, 1, (DISPLAY_LCDWIDTH/2)+4, DISPLAY_NUM_PAGES/2);
}

void ui_show_interface(uint32_t ticks_since_ui_last_shown)
{
    // Used to make measurements of display power consumption.
    /*uint8_t col, page;
    for (page = 0; page < 8; ++page) {
        display_command(DISPLAY_SET_COL_START_LOW + (col & 0xF));
        display_command(DISPLAY_SET_COL_START_HIGH + (col >> 4));
        display_command(DISPLAY_SET_PAGE_START + page);
        for (col = 0; col < 128; ++col) {
            DISPLAY_WRITE_DATA {
                //display_write_byte(0xFF);
                //display_write_byte(0xF0);
                //display_write_byte(0b11000000);
                display_write_byte(0b1000000);
            }
        }
    }
    return;*/

    bool first_time = false;
    static uint8_t last_mode = 255;
    if (last_mode != ms.ui_mode) {
        display_clear();
        first_time = true;
    }
    last_mode = ms.ui_mode;

    if (ms.ui_mode == UI_MODE_INIT) {
        show_init();
    }
    else if (ms.ui_mode == UI_MODE_READING) {
        show_reading();
    }
    else if (ms.ui_mode == UI_MODE_METERING) {
        show_metering();
    }
    else if (ms.ui_mode == UI_MODE_MAIN_MENU) {
        show_main_menu(ticks_since_ui_last_shown, first_time);
    }
}

void ui_top_status_line_at_6col(ui_top_status_line_state_t *func_state,
                                uint8_t *out,
                                uint8_t pages_per_col,
                                uint8_t x)
{

    //
    // * Incident/reflective symbol (top left).
    // * ISO (top right).
    //

    //
    // Incident/reflective symbol.
    //
    if (x == 0) {
        if (ms.meter_mode == METER_MODE_REFLECTIVE) {
            display_bwrite_8px_char(CHAR_8PX_R, out, pages_per_col, 0);
        }
        else { // METER_MODE_INCIDENT
            display_bwrite_8px_char(CHAR_8PX_I, out, pages_per_col, 0);
        }
    }

    // We're now behind by two pixels from the right edge of the display.

    //
    // ISO
    //

    uint8_t iso_start_x = DISPLAY_LCDWIDTH - (ms.bcd_iso_length << 2) - (ms.bcd_iso_length << 1) - (4*CHAR_WIDTH_8PX);

    if (x >= iso_start_x - 2 && x < DISPLAY_LCDWIDTH) {
        const uint8_t *px_grid;

        bool dont_write = false;
        if (x == iso_start_x - 2) {
            px_grid = CHAR_8PX_I;
        }
        else if (x == iso_start_x - 2 + 6) {
            px_grid = CHAR_8PX_S;
        }
        else if (x == iso_start_x - 2 + 12) {
            px_grid = CHAR_8PX_O;
        }
        else if (x >= iso_start_x - 2 + 24) {
            uint8_t di;
            for (di = 0; x > iso_start_x - 2 + 24; x -= 6, ++di);

            if (di < ms.bcd_iso_length) {
                uint8_t digit = ms.bcd_iso_digits[di];
                px_grid = CHAR_PIXELS_8PX + CHAR_8PX_0_O + CHAR_OFFSET_8PX(digit);
            }
            else {
                px_grid = NULL;
                dont_write = true;
            }
        }
        else {
            dont_write = true;
        }

        // Write tail end of last char if there was one.
        if (func_state->charbuffer_has_contents) {
            uint8_t j;
            uint8_t *o;
            for (j = 5, o = out + pages_per_col; j >= 4; --j, o -= pages_per_col)
                *o = func_state->charbuffer[j];
        }

        memset8_zero(func_state->charbuffer, sizeof(func_state->charbuffer));
        if (! dont_write) {
            display_bwrite_8px_char(px_grid, func_state->charbuffer, 1, 0);
            func_state->charbuffer_has_contents = true;

            // Write beginning of that char.
            uint8_t j;
            uint8_t *o;
            for (j = 0, o = out + (pages_per_col << 1); j < 4; ++j, o += pages_per_col)
                *o = func_state->charbuffer[j];
        }
    }
}

// For shutter speeds and apertures (hence 'ssa').
static const uint8_t *ssa_get_12px_grid(uint8_t ascii)
{
    uint8_t m;
    if (ascii >= '0' && ascii <= '9') {
        m = '0';
        goto diff;
    }
    else if (ascii == '/') {
        return CHAR_12PX_SLASH;
    }
    else if (ascii == 'F') {
        return CHAR_12PX_F;
    }
    else if (ascii == '.') {
        return CHAR_12PX_PERIOD;
    }
    else if (ascii == '+') {
        return CHAR_12PX_PLUS;
    }
    else if (ascii == '-') {
        return CHAR_12PX_MINUS;
    }
    else {
        // Should never get here. Useful for running test code before full
        // character set has been created. (The 0 is just a dummy char,
        // could have chosen anything.)
        return CHAR_12PX_0;
    }

diff:
    return CHAR_12PX_GRIDS + CHAR_12PX_0_O + CHAR_OFFSET_12PX(ascii - m);
}

void ui_main_reading_display_at_8col(ui_main_reading_display_state_t *func_state,
                                     uint8_t *out,
                                     uint8_t pages_per_col,
                                     uint8_t x)
{
    const uint8_t VOFFSET = 5;

    if (func_state->len == 0) { // State is unitialized; initialize it.
        // Copy because volatile.
        func_state->exposure_ready = tms.exposure_ready;
        if (! func_state->exposure_ready)
            return;

        shutter_speed_to_string(tms.shutter_speed, &(func_state->shutter_speed_string), PRECISION_MODE_TENTH); // TODO PRECISION MODES
        aperture_to_string(tms.aperture, &(func_state->aperture_string), PRECISION_MODE_TENTH); // TODO PRECISION MODES

        // Total number of chars is the sum of the two plus one for a space plus one for
        // the 'f' we insert before the aperture.
        func_state->len = func_state->shutter_speed_string.length + func_state->aperture_string.length + 2;
        func_state->start_x = (DISPLAY_LCDWIDTH >> 1) - ((func_state->len << 3) >> 1);
        func_state->i = 0;
    }

    if (! func_state->exposure_ready)
        return;

    if (x >= func_state->start_x && func_state->i < func_state->len) {
        if (func_state->i < func_state->shutter_speed_string.length) {
            const uint8_t *shutstr = SHUTTER_STRING_OUTPUT_STRING(func_state->shutter_speed_string);
            uint8_t ascii = shutstr[func_state->i];
            display_bwrite_12px_char(ssa_get_12px_grid(ascii), out, pages_per_col, VOFFSET);
        }
        else if (func_state->i == func_state->shutter_speed_string.length + 1) {
            display_bwrite_12px_char(CHAR_12PX_F, out, pages_per_col, VOFFSET);
        }
        else if (func_state->i >= func_state->shutter_speed_string.length + 2) {
            const uint8_t *apstr = APERTURE_STRING_OUTPUT_STRING(func_state->aperture_string);
            uint8_t ascii = apstr[func_state->i - func_state->shutter_speed_string.length - 2];
            display_bwrite_12px_char(ssa_get_12px_grid(ascii), out, pages_per_col, VOFFSET);
       }

        ++(func_state->i);
    }
    else if (ms.precision_mode == PRECISION_MODE_TENTH &&
        func_state->i < func_state->len + 2) {
        // Write tenths if any.
    }
}

static void write_eighths_8px_chars(uint8_t *digits, uint8_t eighths)
{
    //    assert(eighths < 8 && eighths > 0);
    if (eighths == 1 || eighths == 2 || eighths == 4)
        digits[0] = CHAR_8PX_1_O;
    else if (eighths == 3 || eighths == 6)
        digits[0] = CHAR_8PX_3_O;
    else if (eighths == 5)
        digits[0] = CHAR_8PX_5_O;
    else // if (eighths == 7)
        digits[0] = CHAR_8PX_7_O;

    digits[1] = CHAR_8PX_SLASH_O;

    if (eighths & 1)
        digits[2] = CHAR_8PX_8_O;
    else if (eighths == 4)
        digits[2] = CHAR_8PX_2_O;
    else
        digits[2] = CHAR_8PX_4_O;
}

void ui_bttm_status_line_at_6col(ui_bttm_status_line_state_t *func_state,
                                 uint8_t *out,
                                 uint8_t pages_per_col,
                                 uint8_t x)
{
    if (func_state->expcomp_chars[0] == 0) { // State is not initialized; initialize it.
        // Cache because volatile.
        func_state->exposure_ready = tms.exposure_ready;

        if (! func_state->exposure_ready)
            return;

        // Compute strings for fractional EV values according to precision mode.
        int evwhole = ev_with_fracs_get_wholes(tms.last_ev_with_fracs);
        int tenths = ev_with_fracs_get_nearest_tenths(tms.last_ev_with_fracs);
        int eighths = ev_with_fracs_get_nearest_eighths(tms.last_ev_with_fracs);
        int thirds = ev_with_fracs_get_nearest_thirds(tms.last_ev_with_fracs);
        if (evwhole < 0) {
            assert(evwhole > -10);
            func_state->ev_length = 2;
            func_state->ev_chars[0] = CHAR_8PX_MINUS_O;
            func_state->ev_chars[1] = CHAR_8PX_0_O + CHAR_OFFSET_8PX(-evwhole);
        }
        else {
            func_state->ev_length = uint32_to_bcd(evwhole, func_state->ev_chars);
            uint8_t i;
            for (i = 0; i < func_state->ev_length; ++i)
                func_state->ev_chars[i] = CHAR_OFFSET_8PX(func_state->ev_chars[i]) + CHAR_8PX_0_O;
        }

        uint8_t l = func_state->ev_length;
        if (ms.precision_mode == PRECISION_MODE_EIGHTH && eighths != 0 && eighths != 8) {
            func_state->ev_chars[l++] = CHAR_8PX_PLUS_O;
            write_eighths_8px_chars(func_state->ev_chars + l, eighths);
            l += 3;
        }
        else if (ms.precision_mode == PRECISION_MODE_TENTH && tenths != 0 && tenths != 10) {
            func_state->ev_chars[l++] = CHAR_8PX_PERIOD_O;
            func_state->ev_chars[l++] = CHAR_OFFSET_8PX(tenths) + CHAR_8PX_0_O;
        }
        else if (ms.precision_mode == PRECISION_MODE_THIRD && thirds != 0 && thirds != 3) {
            // TODO
        }

        func_state->ev_length = l;
    }

    if (! func_state->exposure_ready)
        return;

    // Exposure compensation is stored in 1/8 stops in an int8_t.
    // This means that if we ignore the eighths, it can only be up to +/- 16 stops.
    // We can therefore avoid doing a proper conversion to BCD,
    // since it's easy to convert binary values from 0-16 to a two-digit decimal.
    //
    // *** TODO ***
    // It's actually now stored as an ev_with_fracs_t together with a sign.
    // Should add abiliy to display it properly for all precision settings.
    //

    uint8_t i = 0;

    int32_t exp_comp_120 = ev_with_fracs_to_int32_120th(global_meter_state.exp_comp) * global_meter_state.exp_comp_sign;
    if (exp_comp_120 < 0) { // It's negative.
        func_state->expcomp_chars[i++] = CHAR_8PX_MINUS_O;
    }
    else {
        func_state->expcomp_chars[i++] = CHAR_8PX_PLUS_O;
    }

    // exp_comp is now positive.
    uint8_t full_comp = ev_with_fracs_get_wholes(global_meter_state.exp_comp);
    uint8_t full_d1 = 0, full_d2 = 0;
    if (full_comp > 9) {
        full_d1 = 1;
        full_comp -= 10;
    }
    full_d2 = full_comp;

    if (full_d1)
        func_state->expcomp_chars[i++] = CHAR_8PX_0_O + CHAR_OFFSET_8PX(full_d1);
    func_state->expcomp_chars[i++] = CHAR_8PX_0_O + CHAR_OFFSET_8PX(full_d2);

    uint8_t eighths = ev_with_fracs_get_nearest_eighths(global_meter_state.exp_comp);
    if (eighths) {
        func_state->expcomp_chars[i++] = CHAR_8PX_PLUS_O;
        write_eighths_8px_chars(func_state->expcomp_chars + i, eighths);
        i += 3;
    }

    func_state->expcomp_chars_length = i;
    func_state->start_x = DISPLAY_LCDWIDTH - (i << 2) - (i << 1);

    if (x == 0) {
        display_bwrite_8px_char(CHAR_8PX_E, out, pages_per_col, 0);
    }
    else if (x == 6) {
        display_bwrite_8px_char(CHAR_8PX_V, out, pages_per_col, 0);
    }
    else if (x >= 18 && x < 18 + (8*6)) {
        uint8_t off, j;
        for (off = 0, j = x; j > 18; j -= 6, ++off);

        if (off < func_state->ev_length) {
            uint8_t co = func_state->ev_chars[off];
            display_bwrite_8px_char(CHAR_PIXELS_8PX + co, out, pages_per_col, 0);
        }
    }

    if (ev_with_fracs_is_zero(global_meter_state.exp_comp))
        return;

    // We're now two pixels behind alignment with the right edge of the display.

    if (x >= func_state->start_x - 2) {
        // Write tail end of previous char if there was one.
        if (func_state->charbuffer_has_contents) {
            uint8_t j;
            uint8_t *o;
            for (j = 5, o = out + pages_per_col; j >= 4; --j, o -= pages_per_col)
                *o = func_state->charbuffer[j];
        }

        memset8_zero(func_state->charbuffer, sizeof(func_state->charbuffer));

        uint8_t index;
        for (index = 0; x > func_state->start_x - 2; x -= 6, ++index);

        uint8_t char_offset = func_state->expcomp_chars[index];
        display_bwrite_8px_char(CHAR_PIXELS_8PX + char_offset, func_state->charbuffer, 1, 0);
        func_state->charbuffer_has_contents = true;

        // Write beginning of that char.
        uint8_t j;
        uint8_t *o;
        for (j = 0, o = out + (pages_per_col << 1); j < 4; ++j, o += pages_per_col)
            *o = func_state->charbuffer[j];
    }
}
