addrummond/lightmeter/(commit log)

2014-03-30 Fix typo in calculate_tables.py
    [calculate_tables.py]
2014-03-30 Add constants.h, update build.sh, add adc conversion to calculate.c
2014-03-30 Reference voltage is actually about 2.5V with current circuit
2014-03-30 Add calculation for 1.65V ref voltage and fix typo in calculate.c
2014-03-31 Switch to using a timed interrupt for ADC readings (about 8 per second)
2014-03-31 Add led_debug.c/h
2014-03-31 Fix typo in led_debug.c
2014-04-01 Some further work on getting EV calculations right (still some bugs)
    [calculate_tables.py]
2014-04-01 Guard printf with #ifdef TEST in calculate.c
2014-04-01 Some initial work on using temperature readings
2014-04-01 Fix typo in calculate_tables.py comment
    [calculate_tables.py]
2014-04-01 Some fixes to calculation of voltage from raw adc reading
2014-04-02 Apparently successful attempt to use ADC to get both temp and light readings
2014-04-02 Change ref voltage to 5000mV now that voltage splitter turns out not to be needed
2014-04-02 Add vusb library to repo
    [tiny45-rc.sch, with-series-diodes.sch, with-vreg.sch, with-zener.sch]
2014-04-02 More vusb fiddling (is recognized as usb device now)
2014-04-02 Remove dead led_debug code.
2014-04-02 Update usbtest.c and lightmeter.c to do a test read from device
2014-04-02 Add reference voltage 5300 and fix bug in calculation for 5000
2014-04-02 5300 ref voltage to 5500
2014-04-02 Fix bug in calculation for ref voltage = 5000
2014-04-03 Fix typo and remove unnecessary import in calculate_tables.py
    [calculate_tables.py]
2014-04-03 More fixes to calculations.
    [calculate_tables.py]
2014-04-03 Fix some numerical bugs caused by forgetting that '1' translates to '0' on the x axis in log scale.
    [calculate_tables.py]
2014-04-03 Some initial work on aperture_to_string (buggy)
    [calculate_tables.py, exposure.c, exposure.h]
2014-04-03 aperture_to_string now working correctly.
    [calculate_tables.py, exposure.c]
2014-04-03 Fix too small array in exposure.h
    [exposure.h]
2014-04-03 aperture_given_shutter_speed_iso_ev now basically working (but with offset bug)
    [exposure.c]
2014-04-04 'aperture_given_shutter_speed_iso_ev' now computes correctly.
    [exposure.c]
2014-04-04 Correct spelling error in lightmeter.c
    [exposure.h]
2014-04-04 Fix problem causes by not using PROGMEM where I should have been.
    [calculate_tables.py, exposure.c]
2014-04-04 Remove debugging printf from calculate.c
2014-04-04 Fix error in calculate_tables.py which caused EV to be off by 5; add additional test output
    [calculate_tables.py]
2014-04-04 Some more work on storing temperature calibration info in EEPROM
2014-04-04 Move firmware code into its own dir
    [tiny45-rc.sch, with-series-diodes.sch, with-vreg.sch, with-zener.sch]
2014-04-05 Add prototype for bcd_gt to bcd.h
2014-04-05 Add a couple more tests for bcd_gt
2014-04-05 Some initial (extremely buggy) work on BCD division
    [bcd.c, bcd.h]
2014-04-05 Some fixes to ISO calculations.
    [exposure.c]
2014-04-06 Untested buggy code for handling 1/8 stop iso changes
    [bcd.c, bcd.h, exposure.c]
2014-04-06 Some more work on ISO eighth-stop calculations (still very buggy)
    [bcd.c, bcd.h, exposure.c]
2014-04-06 Fix a couple bugs in bcd.c
    [bcd.c]
2014-04-06 Fix bug in bcd_sub
    [bcd.c]
2014-04-06 Code calculating stops from bcd isos is now calculating correctly, but needs cleaning up
    [exposure.c]
2014-04-06 Some initial (no doubt buggy) work on persistent state
    [bcd.c, bcd.h, exposure.c, exposure.h, state.c, state.h]
2014-04-06 Fix some bugs in lightmeter.c and elsewhere
    [state.c, state.h]
2014-04-06 Fix silly bug in aperture_given_shutter_speed_iso_ev
    [exposure.c]
2014-04-07 Free up a pin by using single-ended ADC (does not seem to affect accuracy)
2014-04-07 Some initial (no doubt buggy) work on switchable op amp gain
    [calculate_tables.py, state.h]
2014-04-08 Fix various bugs and problems; move to having two entire tables for low/high gain
    [calculate_tables.py]
2014-04-08 Remove devmulutils.c, devmulutils.h, which are no longer used.
    [exposure.c]
2014-04-08 Remove debug prints in calculate_tables.py
2014-04-08 Revert "Remove devmulutils.c, devmulutils.h, which are no longer used."
    This reverts commit 940b3360285c796634af5816803c9995fb88692a.
    [exposure.c]
2014-04-08 Some initial work on using value of temp sensor. This appears to be highly noisy and in need of calibration. May need to use a real temperature sensor in the end?
2014-04-09 Some initial work on fixing the totally broken exposure calculations.
    [calculate_tables.py]
2014-04-09 Some more work on temperature compensation.
2014-04-09 Fix sign bug in temperature compensation code in calculate.c
2014-04-09 Get tests working correctly again in calculate.c
    [calculate_tables.py]
2014-04-10 Fix tests in calculate.c and bug in calculate_tables.py
    [calculate_tables.py]
2014-04-10 Remove commented-out debug prints
2014-04-10 Increase ISO test cases exposing (ho ho) some bugs
    [exposure.c]
2014-04-10 Fix some bugs in ISO test; still not getting all 2/3 stops right.
    [exposure.c]
2014-04-10 Fix another bug in ISO code
    [exposure.c]
2014-04-11 Switch I2C libraries.
2014-04-11 Update i2cmaster.S defines for attiny85
2014-04-11 Update device-specific defines in USI_TWI_Master.h for attiny85
2014-04-12 Screen works using software SPI
2014-04-12 Tidy up screen test code a bit; switch back to 16.5MHz as it seems to work
2014-04-12 Switching to 4x4 blocks gives much better compression
    (In retrospect using 3x3 blocks was silly, since we have one one-byte index per block, but 8 bits is almost enough to encode a 3x3 block in two-bit color anyway.)
2014-04-13 Not currently working for page non-aligned writes...
2014-04-14 8x8 digits now displaying correctly when page-aligned (non-page-aligned not tested)
    [display.c, display.h]
2014-04-14 Remove no-longer-used i2cmaster.S
2014-04-15 Some work on testing a simple charge pump
2014-04-16 Invert black/white in process_bitmaps.py so it doesn't have to be done on the microcontroller.
    [display.c]
2014-04-16 Couple of small fixes to process_bitmaps.py
2014-04-17 Fix typos in display.c
    [display.c]
2014-04-17 Some more work on chargepumptest.c
2014-04-17 Switch to optimizing for size (-Os)
2014-04-17 Fix off-by-one error in shutter_speed_to_string in exposure.c
    [exposure.c]
2014-04-17 Fix off-by-one error in aperture_to_string in exposure.c
    [exposure.c]
2014-04-18 Switch to 8x6 chars from 8x8 chars.
2014-04-18 Some progress on 12x12 -> 12x8 chars; weird display bugs.
    [display.c, display.h, ui.c, ui.h]
2014-04-19 Finally fix horrible 12px character display bug.
    [display.c]
2014-04-19 Change voffset for main exposure display exposing minor display code bug.
    [ui.c]
2014-04-20 Make some corrections to luminance/illuminance calculations in calculate_tables.py
    [calculate_tables.py]
2014-04-21 Allow abritrary numbers of op amp resistor values in calculate_tables.py
2014-04-22 Update resistor values in calculate_tables.py
2014-04-24 Make largest resistor a bit less stupidly large.
2014-04-24 Some work on making it easier to calculate op amp resistor values in calculate_tables.py
2014-04-24 Fix typo in comment in exposure.c
    [exposure.c]
2014-04-25 Start move towards abstracting out pin assignments to deviceconfig.h
2014-04-25 More work on deviceconfig.h
2014-04-25 Some work on adapting calculate_tables.py for new light diode.
2014-04-25 Fix bug in calculate_tables.py
    [calculate_tables.py]
2014-04-25 Some initial work on removing USB stuff.
    [tiny45-rc.sch, with-series-diodes.sch, with-vreg.sch, with-zener.sch]
2014-04-26 Some more work on improving handling of op amp gain stages.
2014-04-26 Move to having arbitrary numbers of op amp resistor stages.
2014-04-26 Some more work on lightmeter.c; still not working properly.
    [deviceconfig.h]
2014-04-26 First attempt at displaying actual readings on display doesn't quite work but is promising.
    [deviceconfig.h, state.h, ui.c]
2014-04-26 Fix some bugs in display of aperture in exposure readings.
    [exposure.c, ui.c]
2014-04-26 Displayed exposures now track amount of light (uncalibrated)
2014-04-27 Fix some errors in x_give_y_iso_ev in exposure.c
    Still weird off-by-one-stop error when called via aperture_given_iso_shutter_speed_ev
    [exposure.c]
2014-04-27 Fix minor error in bitfiddle_uint8_div_by_10 in bcd.c
    [bcd.c]
2014-04-27 Correct typo in commment in exposure.c
    [exposure.c]
2014-04-27 Some initial work on improving ui buffering method; currently buggy.
    [ui.c, ui.h]
2014-04-27 Fix ui_top_status_line_at_6col to finally stop using offset hack (ui.c)
    [ui.c]
2014-04-27 Bug fix to bottom status line rendering.
    [ui.c]
2014-04-27 Some work on displaying EV values; still buggy.
    [state.c, state.h, ui.c, ui.h]
2014-04-27 Some more work on buggy EV/display code.
    [ui.c]
2014-04-27 Fix logic error in ui_main_reading_display_at_8col in ui.c
    [ui.c]
2014-04-27 Move op amp resistor stage to transient state.
2014-04-27 Some work on verifying that exposure calculations are correct.
    [calculate_tables.py]
2014-04-27 Reduce code size by a few bytes by replacing switch with if/then/else in bcd.c
2014-04-28 Shave off some code size by replacing switch with if/then/else in ui.c
2014-04-28 Finally fix annoying EV display bug.
    [ui.c]
2014-04-28 Remove some currently-irrelevant test code.
2014-04-28 Fix indentation error in exposure.c
    [exposure.c]
2014-04-28 Fix typo in exposure.c
    [exposure.c]
2014-04-29 Add initial rough code in lightmeter.c for driving charge pump.
2014-04-29 Tidy up code for driving charge pump
2014-04-29 Update comment describing pin uses in deviceconfig.h
2014-04-29 Add Eagle schematic to repository
    [lightmeter.sch]
2014-04-29 Update schematic.
    [lightmeter.sch]
2014-04-29 Some initial work on buttons/capacitors.
2014-04-29 Add some unttested code for handling button presses by timing capacitor discharge.
2014-04-29 Add some division by two because interrupt is called every 2ms.
2014-04-29 Move dummy test struct from deviceconfig.h to lightmeter.c
2014-04-29 Change resistor values to ones we have available.
2014-04-30 Some more work on buttons (not working yet)
    [deviceconfig.h]
2014-04-30 Button trick still not working.
2014-04-30 Some more work on schematic stuff.
2014-04-30 Add screen to schematic.
    [lightmeter.sch]
2014-04-30 Power op amp via regulator in schematic.
    [lightmeter.sch]
2014-05-01 Some more work on schematic.
    [lightmeter.sch]
2014-05-01 More work on switching to a more surface-mounty schematic.
    [lightmeter.sch]
2014-05-01 Add some early work on lightmeter.brd
    [lightmeter.brd]
2014-05-01 Some more work on schematic/board
    [lightmeter.brd, lightmeter.sch]
2014-05-01 More work on schematic/board.
    [lightmeter.brd]
2014-05-01 Some more work on schematic
    [lightmeter.brd, lightmeter.sch]
2014-05-01 some work on shift register device lbr
2014-05-01 Some work on integrating shift register into circuit.
2014-05-01 Switch to 4-gain stage design in calculate_tables.py (using three resistors)
2014-05-01 Some fixes to calculate_tables.py
    [calculate_tables.py]
2014-05-02 Initial code for outputting tenths array; seems that it will be the same for all stages which is good.
2014-05-02 Fix some silly mistakes in tenths calculations in calculate_tables.py
    [calculate_tables.py]
2014-05-02 Store temperature compensation offsets in more space-efficient way.
2014-05-02 Some changes to lightmeter.sch
    [lightmeter.sch]
2014-05-02 Increase charge pump clock frequency.
2014-05-02 Get charge pump working more or less ok for ~15mA loads.
    [lightmeter.sch]
2014-05-02 Add costs.xlsx to repo
    [costs.xlsx]
2014-05-02 Change to current version of costs.xlsx (old version added originally by accident)
    [costs.xlsx]
2014-05-04 Fix bug in calculation of temp compensation in get_ev100_at_temperature_voltage
    [exposure.c]
2014-05-04 Fix overflow bug in x_given_y_iso_ev
    [exposure.c]
2014-05-04 Offset bug appears to be gone.
    [exposure.c]
2014-05-05 Revert "Remove incorrect remainder code."
    This reverts commit 999108bbdbe2f638f944b977f80e1b7ce661a726.
    [exposure.c]
2014-05-05 Revert "Revert "Remove incorrect remainder code.""
    This reverts commit 033710ab748956918b0272dbb63b929e41fc4608.
    [exposure.c]
2014-05-05 Revert attempt to generate apertures dynamically.
    [bcd.c, bcd.h, calculate_tables.py, exposure.c, exposure.h, state.h, ui.c]
2014-05-05 Minor corrections to aperture_eighth table
    [calculate_tables.py]
2014-05-05 Fix bug in exposure.c
    [exposure.c]
2014-05-06 Update resistor values for testing.
2014-05-06 Fix some bugs in aperture to string code.
    [calculate_tables.py, exposure.c, ui.c]
2014-05-06 More fixes to aperture to string.
    [exposure.c]
2014-05-06 Aperture to string conversion now working correctly.
    [exposure.c]
2014-05-09 Fix weird enum thing.
    [exposure.c, exposure.h, state.h]
2014-05-09 Fix bug in tenths_from_eighths in exposure.c
    [exposure.h]
2014-05-09 Fix another stupid typo in exposure.h!
    [exposure.h]
2014-05-10 Minor fix to macro in exposure.h
    [exposure.h]
2014-05-10 Fix some cases where full-stop apertures in the tenths table had non-conventional digits following the point
    [calculate_tables.py]
2014-05-10 Some progress on fixing weird exposure display bugs.
    [exposure.c, ui.c]
2014-05-10 Rename tenths_from_eights to tenth_below_eighth to emphasize that it doesn't round.
    [exposure.c, exposure.h]
2014-05-10 Fix bug in get_ev_at_temperature_voltage in exposure.c
    [exposure.c]
2014-05-10 Fix bugs in aperture_to_string in exposure.c
    [exposure.c]
2014-05-10 Fix logic bug in currently commented-out code in aperture_to_string in exposure.c
    [exposure.c]
2014-05-10 Fix bug with handling of tenths in x_given_y_iso_ev in exposure.c
    [exposure.c]
2014-05-10 Remove an old debug printf from exposure.c
2014-05-11 Complete shutter_speeds_thirds and add some corrections to shutter_speeds_eighths
    [calculate_tables.py]
2014-05-11 Fix various errors in calculate_tables.py
    [calculate_tables.py]
2014-05-12 Fix some bugs/typos in previously-committed uncompiled code.
    [calculate_tables.py, exposure.c, exposure.h]
2014-05-13 Shutter speeds in eighths now being calculated correctly.
    [calculate_tables.py, exposure.c]
2014-05-13 Shutter speed output now basically working. Still a bug with addition of 'S' and '/' for tenths and thirds.
    [exposure.c]
2014-05-13 Shutter speeds now output correctly.
    [exposure.c]
2014-05-15 Update reference voltage in calculate_tables.py for battery power + regulator.
2014-05-18 Attempt to make in-circuit programming more reliable by changing config in deviceconfig.h
2014-05-18 Unset CLKDIV fuse
2014-05-18 Fix bug in shutter_speed_to_string in exposure.c
    [exposure.c]
2014-05-19 Initial attempt at fixing up capacitor button code; currently causes crash.
2014-05-20 Fix bug with timed interrupt for detecting button presses.
2014-05-20 Some more work on currently non-working button handling code.
2014-05-20 Some initial work on updating schematic for attiny1634 and use of analogue input for detecting button presses.
    [lightmeter.sch]
2014-05-21 Initial work on new button handling code.
2014-05-22 Making serial debug and button port non-adjacent seems to prevent weird random resets.
    [deviceconfig.h]
2014-05-22 Fix typo in deviceconfig.h
    [deviceconfig.h]
2014-05-22 Fix layout in deviceconfig.h
    [deviceconfig.h]
2014-05-23 More work on button input.
2014-05-23 Add back charge pump code.
2014-05-25 Use consistent naming convention for 12px files.
    [lightmeter.sch]
2014-05-30 Fix comment in exposure.c
    [exposure.c]
2014-05-31 Fix bug in iso calculations in exposure.c
    [exposure.c]
2014-06-01 Add schematic/protonotes.markdown
2014-06-02 Update deviceconfig.h for shift register.
2014-06-02 Reset not needed for shift register.
    [deviceconfig.h]
2014-06-02 Some fixes to previous commit.
    [deviceconfig.h]
2014-06-02 Some initial work on cleaning up and updating schematic.
    [lightmeter.sch]
2014-06-02 Further work on updating and tidying up schematic.
    [lightmeter.sch]
2014-06-02 Switch to new boost regulator in schematic.
    [lightmeter.sch]
2014-06-02 Clean up schematic layout.
    [lightmeter.sch]
2014-06-02 Minor schematic edits.
    [lightmeter.sch]
2014-06-02 Update reference voltage.
    [lightmeter.sch]
2014-06-02 More updates to schematic.
    [lightmeter.sch]
2014-06-03 Add more test pads to schematic.
    [lightmeter.sch]
2014-06-03 Clean up schematic some more.
    [lightmeter.sch]
2014-06-03 Switch to AAA battery in schematic.
    [lightmeter.sch]
2014-06-03 More work on schematic.
    [lightmeter.sch]
2014-06-03 Tidy up component naming in schematic.
    [lightmeter.sch]
2014-06-03 Update ref voltage output and tweak schematic.
    [lightmeter.sch]
2014-06-03 Use p-channel mosfet to generate second charge pump clock, freeing up AVR pin.
    [lightmeter.sch]
2014-06-03 Fix labeling mistake in schematic.
    [lightmeter.sch]
2014-06-03 Fix typo in comment in exposure.h
    [exposure.h]
2014-06-03 Correct comment in exposure.c
    [exposure.c]
2014-06-04 Minor changes to fuses.markdown
2014-06-04 Remove not very useful circuit diagram from protonotes.markdown
2014-06-07 Various changes, the main one being the use of PWM to drive charge pump clocks.
2014-06-07 Removeo outdated comments from lightmeter.c
    [lightmeter.sch]
2014-06-08 Some initial work on using separate input pins for each pushbutton.
    [lightmeter.sch]
2014-06-08 Minor formatting change to deviceconfig.h
2014-06-08 Some intial work on separating out shiftregister module and using shift reg to flip screen reset pin
    [deviceconfig.h, display.c]
2014-06-08 Change to 3-pin multiplexing system for buttons (could handle up to 7 buttons)
    [lightmeter.sch]
2014-06-08 Remove unused macro in deviceconfig.h
2014-06-08 Add cautionary comment back to deviceconfig.h
2014-06-08 Remove outdated comment from deviceconfig.h
2014-06-08 Add BUTTON_ defines to deviceconfig.h
2014-06-08 Initial work on getting mode switch using 'menu' button.
2014-06-08 Update charge pump in schematic.
    [lightmeter.sch]
2014-06-09 Switch to smaller shift register package.
2014-06-09 Switch op amp to smaller package.
    [lightmeter.sch]
2014-06-09 Some work on reconfiguring op amp resistor stages.
    [lightmeter.sch]
2014-06-09 Correct error in deviceconfig.h
    [deviceconfig.h]
2014-06-11 Stop using shift register for reset pin
    [lightmeter.sch]
2014-06-11 Some more work on resistor stages.
2014-06-11 Some initial work on laying out board.
    [lightmeter.brd]
2014-06-11 More work on board layout.
    [lightmeter.brd, lightmeter.sch]
2014-06-11 More work on pcb layout.
    [lightmeter.brd]
2014-06-12 Some initial attempts at manual routing.
    [lightmeter.brd]
2014-06-12 Some more work on board layout.
    [lightmeter.brd]
2014-06-12 More work on board/schematic.
    [lightmeter.brd, lightmeter.sch]
2014-06-12 Improve shift reg bypass cap repr
    [lightmeter.sch]
2014-06-12 More schematic/board work.
    [lightmeter.sch, lightmeter_initiallayout.brd]
2014-06-12 Fix consistency errors and abandon two-layer routing attempt.
    [lightmeter.brd, lightmeter_initiallayout.brd, lightmeter_routed_horrorstory.brd, lightmeter_withbypass.brd, lightmeter_withbypassandanalogue.brd]
2014-06-12 Make consistent with LaenPCBOrder.dru
    [lightmeter.brd, lightmeter_withbypassandanalogue.brd]
2014-06-12 Switch to four layers.
    [lightmeter.brd, lightmeter.sch, lightmeter_withbypassandanalogue.brd]
2014-06-12 Board routed with 3 layers.
    [lightmeter.brd, lightmeter.sch]
2014-06-12 Fix clearence errors.
    [lightmeter.brd]
2014-06-12 Snap dimensions to grid.
    [lightmeter.brd]
2014-06-12 Some work on routing to ground using ground plane.
    [lightmeter.brd]
2014-06-12 All done except CPCLK1 trace.
    [lightmeter.brd, lightmeter.sch]
2014-06-13 PCB design complete (maybe)
    [lightmeter.brd]
2014-06-13 Get rid of clearence errors.
    [lightmeter.brd]
2014-06-13 DRC checks now complete successfully.
    [lightmeter.brd]
2014-06-13 Two-diode layout complete.
    [lightmeter.brd, lightmeter.sch]
2014-06-16 Remove use of fliph/flipv to enable larger number of 12px char blocks to be stored.
    [display.c]
2014-06-21 Fix regression in ISO code.
    [lightmeter.brd]
2014-06-21 Fix bug in exposure.c test.
    [exposure.c]
2014-06-21 New exposure calculation bugs mostly fixed.
    [exposure.c, exposure.h]
2014-06-21 Remaining exposure calc bug fixed.
    [exposure.c]
2014-06-24 Tests now compile for cinematography calculations (not giving correct results)
    [exposure.c]
2014-06-24 Fix typo in test in exposure.c
    [exposure.c]
2014-07-08 Some initial buggy work on implementing bcd_mul
    [bcd.c, bcd.h]
2014-07-09 Improve loop login in bcd_add_ and fix bug with carry
    [bcd.c]
2014-07-09 Add new failing test for bcd_sub
    [bcd.c]
2014-07-09 Fix failing test for bcd_sub in bcd.c
    [bcd.c]
2014-07-10 More work on bcd_exp10 (not working yet)
    [bcd.c]
2014-07-12 Working on bug in bcd_mul
    [bcd.c]
2014-07-13 bcd_exp10 appears to be more or less working correctly now
    [bcd.c]
2014-07-13 Another non-working test for bcd_exp10 to fix.
    [bcd.c]
2014-07-13 Fix bug in bcd_exp10
    [bcd.c]
2014-07-13 Fix typo in bcd.c
    [bcd.c]
2014-07-13 Fix bug in uint32_to_bcd
    [bcd.c]
2014-07-14 Add currently non-working test for ev_at_100_to_bcd_lux
2014-07-14 Fix some bugs in bcd.c and add non-working test for ev_at_100_to_bcd_lux in exposure.c
    [bcd.c, exposure.c]
2014-07-14 Fix silly mistake in exposure.c
    [exposure.c]
2014-07-14 ev_at_100_to_bcd_lux now giving vaguely correct results for inputs > 0
    [exposure.c]
2014-08-14 Change most resistors to smaller 603 package.
    [lightmeter.sch]
2014-08-14 Use proper symbol for inductor
    [lightmeter.sch]
2014-08-14 Use proper AVR programming header.
    [lightmeter.sch]
2014-08-14 Switch capacitors to 603 package.
    [lightmeter.sch]
2014-08-14 Get MOSFETs the right way round.
    [lightmeter.sch]
2014-08-14 Add separate capacitors for each op-amp resistor stage (proper values not calculated yet)
    [lightmeter.sch]
2014-08-14 More work on schematic, and costs.xlsx replaced with parts.ods
    [costs.xlsx, lightmeter.sch, parts.ods]
2014-08-14 Tenative new choice of photodiode (cheap)
    [parts.ods]
2014-08-15 More work on move to new diodes.
    [lightmeter.sch, parts.ods, vemd2503x01_spectral_sensitivity.csv]
2014-08-15 Add product codes for major parts to schematic.
    [lightmeter.sch]
2014-08-15 Remove stray spaces.
    [vemd2503x01_spectral_sensitivity.csv]
2014-08-16 Some more work on new diode
    [luminosity_function.csv, qb11_spectral_sensitivity.csv]
2014-08-16 More work on new diode.
    [qb12_spectral_sensitivity.csv]
2014-08-16 Some more work on new diode.
2014-08-17 Update circuit for more stages/diodes.
    [lightmeter.sch, parts.ods]
2014-08-17 Fix mistake in lightmeter.sch
    [lightmeter.sch]
2014-08-17 More work on new diode
    [lightmeter.brd, lightmeter.sch, parts.ods]
2014-08-17 Reduce to four resistors for op amp
    [lightmeter.sch, parts.ods]
2014-08-17 Minor schematic layout tweaks.
    [lightmeter.sch]
2014-08-18 Corrections to schematic.sch and parts.ods
    [lightmeter.sch, parts.ods]
2014-08-18 Add diode datasheet.
2014-08-18 Add package for photodiodes
    [lightmeter.sch]
2014-08-18 Tweaks to schematic.
    [lightmeter.sch]
2014-08-18 Improvements/fixes to circuit design.
    [lightmeter.sch, parts.ods]
2014-08-18 More work on schematic and parts list.
    [lightmeter.sch, parts.ods]
2014-08-18 More work on schematic/parts.
    [parts.ods]
2014-08-18 Some preliminary layout work.
    [lightmeter.brd, lightmeter.sch]
2014-08-18 Add lightmeter_grouped.brd
    [lightmeter_grouped.brd]
2014-08-19 More work on layout.
    [lightmeter.brd, lightmeter.sch]
2014-08-19 Correct screen and diode positions.
    [lightmeter.brd]
2014-08-21 Fix mistake in comment in calculate_tables.py
    [calculate_tables.py]
2014-08-21 More routing work.
    [lightmeter.brd]
2014-08-21 Some work on routing buttons.
    [lightmeter.brd]
2014-08-22 Fix typos in calculate_tables.py
    [calculate_tables.py]
2014-08-22 More work on routing.
    [lightmeter.brd]
2014-08-22 Routing nearly done.
    [lightmeter.brd]
2014-08-23 Remove charge pump and use screen internal DC convertor
    [lightmeter.brd, lightmeter.sch, parts.ods]
2014-08-23 Fix some mistakes in circuit for screen.
    [lightmeter.brd, lightmeter.sch, parts.ods]
2014-08-23 Squeeze in tiny capacitors.
    [lightmeter.brd, lightmeter.sch]
2014-08-23 More work on squeezing in tiny caps.
    [lightmeter.brd, lightmeter.sch]
2014-08-25 Fix AVR header issues in layout and more work on layout.
    [lightmeter.brd, lightmeter.sch]
2014-08-26 Routing almost all done apart from connections to ground plane.
    [lightmeter.brd]
2014-08-29 Before adding round plane.
    [lightmeter.brd]
2014-08-29 Top ground pour added.
    [lightmeter.brd]
2014-08-29 Remove polygons to reconsider design.
    [lightmeter.brd]
2014-08-29 Fix crazy routing error and some work on spacing.
    [lightmeter.brd, lightmeter.sch]
2014-08-29 Some progress on removing clearences and overlaps.
    [lightmeter.brd]
2014-08-29 Only weird "dimension" errors now remain.
    [lightmeter.brd]
2014-08-30 DRC now passes. Ground polygons still not added.
    [lightmeter.brd]
2014-08-30 Fix an ERC warning.
    [lightmeter.brd, lightmeter.sch]
2014-08-30 Debug test pad added.
    [lightmeter.brd]
2014-08-30 Increase width of some power traces.
    [lightmeter.brd]
2014-08-31 Add temperature sensor.
    [lightmeter.brd, lightmeter.sch]
2014-10-12 Temperature center now hooked up.
    [lightmeter.brd, lightmeter.sch]
2014-10-12 Ready to add ground plane.
    [lightmeter.brd]
2014-10-12 Another attempt at pre-ground-plane prep
    [lightmeter.brd]
2014-10-12 More work preparatory to adding ground plane.
    [lightmeter.brd]
2014-10-12 More prepatatory work for ground plane.
    [lightmeter.brd]
2014-10-13 More work preparatory to ground plane.
    [lightmeter.brd]
2014-10-13 Some initial work on adding groud plane.
    [lightmeter.brd, lightmeter.sch]
2014-10-13 More work on adding ground polygon.
    [lightmeter.brd]
2014-10-13 Some more work on connecting to ground polygon.
    [lightmeter.brd]
2014-10-13 more work on routing ground polygon.
    [lightmeter.brd]
2014-10-13 Some more routing work.
    [lightmeter.brd]
2014-10-13 Ready for ground polygon (auto?) routing.
    [lightmeter.brd, parts.ods]
2014-10-13 Ready to attempt ground pad connection.
    [lightmeter.brd]
2014-10-13 Some more routing.
    [lightmeter.brd]
2014-10-13 More ground routing work.
    [lightmeter.brd, lightmeter.sch]
2014-10-13 Finally get processors VREG connected.
    [lightmeter.brd]
2014-10-13 Very nearly done routing.
    [lightmeter.brd]
2014-10-13 DONE?! (2)
    [lightmeter.brd]
2014-10-13 All air wires now routed.
    [lightmeter.brd]
2014-10-13 Disconnect pin 7 of screen.
    [lightmeter.brd, lightmeter.sch]
2014-10-13 Remove dimension box in screen component in microbuilder library.
    [lightmeter.brd, lightmeter.sch]
2014-10-13 Another attempt to remove annoying boxes.
    [lightmeter.brd, lightmeter.sch]
2014-10-13 Remove unnecessary routing complexity.
    [lightmeter.brd]
2014-10-14 Update parts spreadsheet.
    [parts.ods]
2014-10-29 Add separate copies of board/schematic used for first run of OSH Park boards.
    [lightmeter_proto1.brd, lightmeter_proto1.sch]
2014-10-29 Set reset DDR in display.c
    [display.c]
2014-10-31 Add additional build option for screwed-up prototype board.
2014-10-31 Add code to turn on display power MOSFET.
2014-10-31 Remove charge pump code (now using charge pump driver built into display unit)
2014-10-31 Remove call to charge pump initializer function that has now been removed.
2014-10-31 Update debug code for displaying button presses.
2014-11-01 Switch to new pad layout for attiny1634
    [lightmeter.brd, lightmeter.sch]
2014-11-01 Minor board layout changes.
    [lightmeter.brd]
2014-11-01 Another PDEBUG mode to deviceconfig.h
2014-11-01 Fix silly mistake in deviceconfig.h
    [deviceconfig.h]
2014-11-02 Some work on fixing screen power MOSFET in schematic.
    [lightmeter.sch]
2014-11-02 Some improvements to shiftregister.c
    [lightmeter.sch]
2014-11-02 Revert attempt at fixing screen power setup.
    [lightmeter.sch]
2014-11-02 More work on fixing screen power issue.
    [lightmeter.brd, lightmeter.sch]
2014-11-03 Fix shit register bit assignment errors in deviceconfig.h
    [deviceconfig.h]
2014-11-03 Edits to comment in deviceconfig.h
2014-11-04 Some work on fixing handling of amp stages.
    [calculate_tables.py, deviceconfig.h, exposure.c]
2014-11-04 Fix bitshifting bug in get_ev100_at_temperature_voltage in exposure.c
    [exposure.c]
2014-11-05 Fix typo in comment in bcd.c
    [bcd.c]
2014-11-05 Fix indentation error in exposure.h
    [exposure.h]
2014-11-05 Remove outdated comment in display.c (we are using internal charge pump in prod)
2014-11-05 Fix comments in calculate_tables.py
    [calculate_tables.py]
2014-11-06 Various tweaks and fixes.
    [deviceconfig.h, exposure.c]
2014-11-06 Add LM3671 buck converter device to lighmeter.lbr
2014-11-06 Some initial work on adding rechargeable battery to schematic.
    [lightmeter.brd, lightmeter.sch]
2014-11-08 Remove old code for ADC interrupts in lightmeter.c
2014-11-09 Buttons now debounced in software to an at-least-usable level
2014-11-11 Add lipolybatterynotes.markdown
2014-11-14 Add SOT-416 n-channel mosfet package
    http://www.mouser.com/ds/2/302/NX3020NAKT-352297.pdf
2014-11-14 Add P-channel sot-416 mosfet to lightmeter.lbr
    http://www.mouser.com/ds/2/302/PMR670UPE-352006.pdf
2014-11-15 Some more work on adding power muxing.
    [lightmeter.sch]
2014-11-23 Updates to lightmeter.sch
    [lightmeter.sch]
2014-11-23 Updates to lipolybatterynotes.markdown
2014-11-24 Fix errors in lightmeter.lbr relating to LM3671 buck converter
2014-11-24 Some work on buck regulator in schematic.
    [lightmeter.sch]
2014-11-24 Some more work on schematic / deviceconfig.h
    [lightmeter.sch]
2014-11-24 More work on lightmetet.sch / deviceconfig.h
    [lightmeter.sch]
2014-11-24 Add bypass capacitor for battery charger IC
    [lightmeter.sch]
2014-11-24 Adjust resistor on battery charger IC for slightly under 100mA charge rate
    [lightmeter.sch]
2014-11-24 Stop floating unused op amp pins
    http://www.analog.com/static/imported-files/rarely_asked_questions/unused_op-Amp_article.html
    [lightmeter.sch]
2014-11-24 Switch to 402 resistors/capacitors/inductors.
    [lightmeter.sch]
2014-11-25 New temp compensation scheme.
    [lightmeter.sch]
2014-11-25 Add headphone jack to schematic. Intending to use following jack.
    http://www.mouser.com/ProductDetail/Switchcraft/35RASMT2BHNTRX/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
    [lightmeter.sch]
2014-11-25 Add note to lightmeter.sch on screen orientation.
    [lightmeter.sch]
2014-11-25 Remove outdated lightmeter.brd
    [lightmeter.brd]
2014-11-25 Add some protection for flash sync input.
    [lightmeter.sch]
2014-11-26 Updates to protector diode on flash sync
    [lightmeter.sch]
2014-11-26 Switch to smaller pushbuttons
    http://www.mouser.com/ProductDetail/TE-Connectivity-Alcoswitch/147873-1/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
    [lightmeter.sch]
2014-11-26 Add label to lightmeter.sch
    [lightmeter.sch]
2014-11-26 Some initial routing work and fixes to lightmeter.sch
    [lightmeter.brd, lightmeter.sch]
2014-11-26 Some more work and layout; delete some unnecessary screen capacitors.
    [lightmeter.brd, lightmeter.sch]
2014-11-26 Adjust dimension layer.
    [lightmeter.brd]
2014-11-26 Put screen in correct orientation.
    [lightmeter.brd]
2014-11-26 Remove very old board layout that was never made
    [lightmeter_withbypassandanalogue.brd]
2014-11-26 Remove no longer applicable PDEBUG defs in deviceconfig.h
    [deviceconfig.h]
2014-11-27 Add battery voltage input; more work on board
    [lightmeter.brd, lightmeter.sch]
2014-11-28 Routing -ground almost all done.
    [lightmeter.brd]
2014-11-28 More work on layout
    [lightmeter.brd]
2014-11-28 Everything now routed except GND.
    [lightmeter.brd, lightmeter.sch]
2014-11-28 Work on clearences.
    [lightmeter.brd]
2014-11-28 Some more work on clearences.
    [lightmeter.brd]
2014-11-28 More work on clearences.
    [lightmeter.brd]
2014-11-29 More progess on fixing design rules errors
    [lightmeter.brd]
2014-11-29 Almost done with design rule errors
    [lightmeter.brd]
2014-11-29 Only remaining dimensions layers are those for weird usb thing.
    [lightmeter.brd]
2014-11-29 All routed except for GND; no dim exceptions; weird USB socket replaced
    [lightmeter.brd, lightmeter.sch]
2014-11-29 Groud usb data lines through 15K pulldowns
    [lightmeter.brd, lightmeter.sch]
2014-11-29 Fill attempt
    [lightmeter.brd]
2014-11-29 Some work on routing ground plane.
    [lightmeter.brd]
2014-11-29 More work on routing
    [lightmeter.brd]
2014-11-29 Fix AVRMOSI routing error.
    [lightmeter.brd, lightmeter.sch]
2014-11-29 More work on routing GND
    [lightmeter.brd]
2014-11-29 No DRC errors; GND routing almost complete.
    [lightmeter.brd]
2014-11-29 Some more work on routing GND
    [lightmeter.brd]
2014-11-30 More work on routing -- just one PITA airwire left.
    [lightmeter.brd]
2014-11-30 ALMOST ALMOST done routing.
    [lightmeter.brd]
2014-11-30 Everything routed!
    [lightmeter.brd]
2014-11-30 Some work on silkscreen
    [lightmeter.brd, lightmeter.sch]
2014-11-30 Add label to schematic.
    [lightmeter.sch]
2014-11-30 More work on labeling/silk screen.
    [lightmeter.brd, lightmeter.sch]
2014-11-30 Add checklist for schematic.
2014-11-30 Remove dummy airwires from lightmeter
    [lightmeter.brd, lightmeter.sch]
2014-11-30 Fix error in schematic for buck regulator.
    [lightmeter.brd, lightmeter.sch]
2014-11-30 Update checklist and schematic.
    [lightmeter.sch]
2014-11-30 Some more work going through board checklist.
    [lightmeter.brd, lightmeter.sch]
2014-11-30 More work going through board checklist.
    [lightmeter.brd, lightmeter.sch]
2014-11-30 More work on schematic/checklist; move diodes slightly further apart.
    [lightmeter.brd]
2014-12-01 Mork work on board/schematic checklist.
2014-12-01 More work on fixing board/schematic.
    [lightmeter.brd, lightmeter.sch]
2014-12-01 More fixes to schematic/checklist
    [lightmeter.sch]
2014-12-01 Various minor changes.
    [lightmeter.brd, lightmeter.sch]
2014-12-01 Fix silk screen a bit
    [lightmeter.brd]
2014-12-01 Some (incomplete) work on rejigging layour for update attiny1634 pad layout
    [lightmeter.brd, lightmeter.sch]
2014-12-01 Almost done with new layout adjustments.
    [lightmeter.brd, lightmeter.sch]
2014-12-01 Rerouted with fixes.
    [lightmeter.brd]
2014-12-01 Update schematic checklist.
2014-12-01 Nearly fixed weird solder mask issue with oshpark and attiny1634 pads.
    [lightmeter.brd, lightmeter.sch]
2014-12-02 Finally fix weird solder mask issue with OSH park preview
    [lightmeter.brd, lightmeter.sch]
2014-12-02 Update deviceconfig.h to match changes in pin assignments.
2014-12-02 Fix error with using N-channel MOSFET for batvoltage sensor switch.
    [lightmeter.brd, lightmeter.sch]
2014-12-03 Add '%' suffix to resistor values where high accuracy is required.
    [lightmeter.brd, lightmeter.sch]
2014-12-03 Some updates to screen cap values.
    [lightmeter.brd, lightmeter.sch]
2014-12-03 Replace parts.ods with parts.markdown (updated for new schematic)
    [parts.ods]
2014-12-04 More parts list tweaking.
    [lightmeter.brd, lightmeter.sch]
2014-12-04 Fix bad choice of footprint for protection diode.
    [lightmeter.brd, lightmeter.sch]
2014-12-11 Add second prototype pcb schematic and board files for reference.
    [lightmeter_proto2.brd, lightmeter_proto2.sch]
2014-12-12 Fix bug in power muxor
    [lightmeter.brd, lightmeter.sch]
2014-12-12 Fix reference schematic/board for second prototype.
    [lightmeter_proto2.brd, lightmeter_proto2.sch]
2014-12-15 Fix evil charge pump short.
    [lightmeter.brd, lightmeter.sch]
2014-12-15 Switch to simpler diode-based power muxer.
    [lightmeter.brd, lightmeter.sch]
2014-12-15 Switch to slightly larger inductor package.
    [lightmeter.brd, lightmeter.sch]
2014-12-16 Some work on board layout.
    [lightmeter.brd, lightmeter.sch]
2014-12-16 Fix pad layout for audio jack.
    [lightmeter.brd, lightmeter.sch]
2014-12-18 Routing and layout done for new prototype board with accelerometer
    [lightmeter.brd, lightmeter.sch, lightmeter_proto2.sch]
2014-12-18 Minor adjustment to lightmeter.brd.
    [lightmeter.brd]
2014-12-19 Some updates to parts spreadsheet.
    [lightmeter.sch]
2014-12-19 Updates to deviceconfig.h for new button setup, etc.
    [lightmeter.brd, lightmeter.sch]
2014-12-19 Some unfinished work on adding ground connection for accelerometer (!)
    [lightmeter.brd, lightmeter.sch]
2014-12-19 DRC checks now pass.
    [lightmeter.brd]
2014-12-19 More work on board/schematic
    [lightmeter.brd, lightmeter.sch]
2014-12-19 Tweaks to schematic/board.
    [lightmeter.brd, lightmeter.sch]
2014-12-19 Widen a VREG trace.
    [lightmeter.brd]
2014-12-19 Update resistor values and switch to single resistor for biggest amp stage
    [lightmeter.brd, lightmeter.sch]
2014-12-20 Update buck regulator to fixed 2.8V
    [calculate_tables.py]
2014-12-20 Add lightmeter_proto3.brd and lightmeter_proto3.sch
    [lightmeter_proto3.brd, lightmeter_proto3.sch]
2014-12-20 Add stabilization capacitor for VREG output.
    [lightmeter.brd, lightmeter.sch]
2014-12-23 Udpdate resistor values in parts spreadsheet.
2014-12-23 More work on parts spreadsheet.
    [lightmeter.brd, lightmeter.sch]
2014-12-24 Minor fix to deviceconfig.h
    [deviceconfig.h]
2014-12-24 Remove out of date comment from deviceconfig.h
2014-12-26 I2C code now compiles.
2014-12-26 Some more tweaks to I2C code.
2014-12-28 Integrate bypass capacitor for buck convertor onto PCB layout.
    [lightmeter.brd]
2014-12-28 Switch to using completely SMT USB connector
    http://www.quick-teck.co.uk/Management/EEUploadFile/1410362725.pdf
    http://www.quick-teck.co.uk/ElectronicElement/eeDetail.php?eeId=1215
    Made by QUARK-ELEC
    Order code: QCJ-00088
    [lightmeter.brd, lightmeter.sch]
2014-12-28 Reduce height of board to < 50mm
    [lightmeter.brd]
2014-12-29 Add missing GND connection.
    [lightmeter.brd]
2014-12-29 Move Q7 further from shift register. v
    [lightmeter.brd]
2014-12-29 Add device/package for STM32F030K6T6 to lightmeter.lbr
    http://uk.mouser.com/ProductDetail/STMicroelectronics/STM32F030K6T6/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
    http://www.st.com/web/en/resource/technical/document/datasheet/DM00088500.pdf
    http://www.st.com/web/en/resource/technical/document/programming_manual/DM00051352.pdf
    http://www.st.com/web/en/resource/technical/document/reference_manual/DM00091010.pdf
2014-12-31 Add stuff in arminfo for building code from stm32
2015-01-01 Add PIN 1 dot for switch thingy
2015-01-01 Some initial (very) exploratory work on ARM-based redesign.
    [lightmeter.brd, lightmeter.sch]
2015-01-01 Some work on modifying exposure and bcd modules for ARM Cortex M0
2015-01-02 Add decoupling capacitors.
    [lightmeter.sch]
2015-01-02 Tidy up schematic a bit.
    [lightmeter.sch]
2015-01-02 Some updates to schematic.
    [lightmeter.sch]
2015-01-02 Some fixes to bcd module (int sizes)
    [bcd.c, bcd.h]
2015-01-02 Remove shiftregister.c and shiftregister.h (arm design doesn't use shift reg)
2015-01-03 More work on arm migration.
2015-01-03 Some more work on arm stuff.
2015-01-03 Fix issue with assert.h which was stopping arm build.
    [bcd.c, exposure.c]
2015-01-03 Update comment with pin assignments in deviceconfig.h
2015-01-04 Use better schematic for SPDTs
    [lightmeter.sch]
2015-01-04 Some updates to deviceconfig.h
2015-01-04 Remove old fuses.markdown for AVR
2015-01-04 Minor formatting edit to tables/vemd2503x01_spectral_sensitivity.csv
    [vemd2503x01_spectral_sensitivity.csv]
2015-01-04 Minor fix to tables/vemd2503x01_spectral_sensitivity.csv
    [vemd2503x01_spectral_sensitivity.csv]
2015-01-04 Various AVR->ARM tweaks
2015-01-04 Remove old AVR defs from deviceconfig.h
2015-01-04 Add STM i2c lib
2015-01-06 Fix orientation of protection diode.
    [lightmeter.sch]
2015-01-06 Make naming of values systematic in proto boards.
    [lightmeter_proto3.brd, lightmeter_proto3.sch]
2015-01-06 Make naming of values consistent in schematic.
    [lightmeter.sch]
2015-01-08 Update lightmeter.lbr with bigger pads for accel to make it easier to solder.
2015-01-09 Some work on switching to integrator amp.
    [lightmeter.sch]
2015-01-09 Power analogue part of mc and op amp from linear regulator.
    [lightmeter.sch]
2015-01-10 Finally found a good linear regulator for analogue voltage supply
    http://www2.mouser.com/ProductDetail/Texas-Instruments/LP5907MFX-33-NOPB/?qs=sGAEpiMZZMtxga3Frp99ssdbdmlAwb6R
    [lightmeter.sch]
2015-01-10 Add datasheet for discovery board.
2015-01-10 Some work on using more compact connectors.
    [lightmeter.sch]
2015-01-10 Fix missing connection in schematic.
    [lightmeter.sch]
2015-01-10 Minor layout changes to schematic.
    [lightmeter.sch]
2015-01-10 Switch back to USB connector with holes (we know that this works nicely now).
    [lightmeter.sch]
2015-01-10 Switch to bigger batvoltage resistor divider
    [lightmeter.sch]
2015-01-10 Power consumption of op amps is insignificant for rechargeable device, if datasheet is to be believed. Remove MOSFET.
    [lightmeter.sch]
2015-01-10 Add some of the external components for the NRF8001
    [lightmeter.sch]
2015-01-10 More work on nrf8001 in schematic.
    [lightmeter.sch]
2015-01-11 Flash sync pin can also be used to measure voltage.
    [lightmeter.sch]
2015-01-11 Give up on low power bluetooth option.
    [lightmeter.sch]
2015-01-11 Add piezo bender to schematic.
    [lightmeter.sch]
2015-01-11 Some fiddling with audio circuit
    [lightmeter.sch]
2015-01-13 Some more work on piezo circuit.
    [lightmeter.sch]
2015-01-13 More work on piezo circuit.
    [lightmeter.sch]
2015-01-15 Initial test program works (flashes LED on discovery board).
2015-01-15 Some more work on arm port.
2015-01-15 Some more work on translating screen code to arm/i2c
2015-01-16 Some more work on screen I2C interface.
    [lightmeter.sch]
2015-01-16 More work on I2C/debugging.
2015-01-16 Some more fruitless work on I2C.
2015-01-16 Get things hooked up to right pins (still doesn't work)
    [lightmeter.sch]
2015-01-16 Fix I2C mode error in i2c.c
    [i2c.c]
2015-01-16 More fruitless work on I2C.
2015-01-16 Add new test in exposure.c revealing possible small errors in get_ev100_at_voltage.
    [exposure.c]
2015-01-16 Fix major bug with handling of ND filters in calculate_tables.py
    [calculate_tables.py, exposure.c]
2015-01-16 Test in exposure.c for EV@100 now written correctly.
    Appears to show that get_ev100_at_voltage working correctly
    [exposure.c]
2015-01-17 Pretty sure I2C is being driven by 8MHz HSI
2015-01-17 Add defines for various different speeds in i2c.c
2015-01-17 Set timeout to same as LM75 long timeout for now (I2C)
2015-01-17 Fruitless I2C fiddling.
2015-01-17 Fix typos in deviceconfig.h which were screwing things up.
    Screen now flashes some random pixels briefly. Progress!
    [deviceconfig.h]
2015-01-17 400kHz I2C seems to work ok.
2015-01-17 Some I2C code reorganization.
2015-01-17 Some more work on debugging I2C.
2015-01-17 More I2C debug fiddling.
2015-01-18 Currently working.
2015-01-18 Switch to more efficient way of writing data bytes to screen.
2015-01-18 Add state.c to ARM build.
2015-01-18 Add more UI stuff to ARM build.
2015-01-18 Revert "Some initial work on updating 12px chars."
    This reverts commit d906ba6641e082ff380f80748bcfc79c5c25843f.
    Conflicts:
    firmware/bitmaps/process_bitmaps.py
    [main.c]
2015-01-18 Switch back to old character set (to be improved)
2015-01-18 Fix incredibly irritating bug in display_write_page_array due to typo
    [display.c, display.h, ui.c]
2015-01-18 Fix comment in ui.c
    [ui.c]
2015-01-19 Minor schemtic/lbr update.
    [lightmeter.sch]
2015-01-22 Add FFT code found here: http://www.jjj.de/fft/fftpage.html
2015-01-25 Switch to using NOA1212 instead of photodiodes.
    [lightmeter.sch]
2015-01-25 Add indicator of nodal radius for piezo mounting.
2015-01-25 Some more work on audio stuff.
    [lightmeter.sch]
2015-01-25 Switch all Python scripts to Python 3
2015-01-26 Simplify piezo circuit a whole lot.
    [lightmeter.sch]
2015-01-26 Remove audio jack on assumption that flash sync will be via usb connector.
    [lightmeter.sch]
2015-01-26 Some very preliminary board layout work.
    [lightmeter.brd, lightmeter.sch]
2015-01-26 Some more fiddling with board/case layout possibilities.
    [lightmeter.brd, lightmeter.sch]
2015-01-27 Some further preliminary work on board layout.
    [lightmeter.brd, lightmeter.sch]
2015-01-27 Some more work on layout.
    [lightmeter.brd, lightmeter.sch]
2015-01-28 Add some initial work on case design.
2015-01-29 More work on case 3d model.
2015-01-29 More work on case.
2015-01-29 More work on case design.
2015-01-29 Adjust battery size.
2015-01-30 Separate out different components of case/buttons.
2015-01-30 More work on case (get it up to spec for 3d printing).
2015-01-31 Some work on case thickness.
2015-01-31 Some work on reducing case thickness using mid mount microusb connector.
2015-01-31 Switch to mid mount microusb connector.
    [lightmeter.brd, lightmeter.sch]
2015-01-31 Extend microusb pin pads to make hand-soldering easier.
2015-01-31 Extend cutout so that it clearly goes beyond board edge with micorusb conn
2015-01-31 Add swdtousb.sch (make it easier to use microusb port to connect programmer)
    [swdtousb.sch]
2015-02-01 Finish design of swd->usb adapter
    [swdtousb.brd, swdtousb.sch]
2015-02-01 Some work on making room for enormous microusb mid mount connector.
    [lightmeter.brd, lightmeter.sch]
2015-02-01 Some renaming of parts.
    [lightmeter.brd, lightmeter.sch]
2015-02-01 Switch to using smaller schotky diodes
    http://www2.mouser.com/ProductDetail/Comchip-Technology/CDBP0130L-G/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
    Mouser part no: 750-CDBP0130L-G
    Manaf. part no: CDBP0130L-G
    [lightmeter.brd, lightmeter.sch]
2015-02-01 Add USB opening to case. (Possible light leak issues in current location?)
2015-02-01 Adjust position of usb port in case to match schematic. Some initial work on signal_encode.c
2015-02-01 Connect NRST to usb id pin so that only one pin header is (maybe) needed for swdio
    [lightmeter.brd, lightmeter.sch]
2015-02-02 Make button rounding a bit more subtle and add TODO list.
2015-02-02 Some work on rectifying usb layout disaster.
    [lightmeter.brd]
2015-02-03 Fix screen positioning problem
    [lightmeter.brd]
2015-02-03 Remove some bad routing and prematurely placed holes.
    [lightmeter.brd]
2015-02-03 More work on case/layout.
    [lightmeter.brd]
2015-02-05 Some more work on board routing.
    [lightmeter.brd, lightmeter.sch]
2015-02-07 Board now completely routed (unrouted AVREG traces are spurious)
    [lightmeter.brd, lightmeter.sch]
2015-02-07 Some more board tweaks/fixes.
    [lightmeter.brd, lightmeter.sch]
2015-02-07 More work on board layout (problems with piezo bender).
    [lightmeter.brd, lightmeter.sch]
2015-02-07 Go back to pads for piezo bender.
    [lightmeter.brd, lightmeter.sch]
2015-02-07 Some work on fixing DRC violations.
    [lightmeter.brd]
2015-02-14 Some more work on design rules.
    [lightmeter.brd, lightmeter.sch]
2015-02-14 All DRC checks for Seeed now pass
    [lightmeter.brd]
2015-02-14 Remove old i2c bitbanging code in accel.c
2015-02-21 Some work on getting osh park DRU satisfied too.
    [lightmeter.brd]
2015-02-21 Now validates with osh park DRU too (except dimension errors)
    [lightmeter.brd, lightmeter.sch]
2015-02-27 Switch to more popular SOT-523-3 package for MOSFETs.
    [lightmeter.brd, lightmeter.sch]
2015-02-28 Some initial work on making dome separate glue-in piece.
2015-02-28 Some more work on case.
2015-02-28 Remove unnecessary bypass caps which were there due to misreading data sheet.
    [lightmeter.brd, lightmeter.sch]
2015-03-01 Add line for top of screen as well as bottom of screen
    [lightmeter.brd]
2015-03-01 Some work on silkscreen.
    [lightmeter.brd, lightmeter.sch]
2015-03-01 Add ledge to board and ensure components don't go over it.
    [lightmeter.brd, lightmeter.sch]
2015-03-01 Some more work on pcb attachment.
    [lightmeter.brd]
2015-03-01 Remove some old definitions from case.openjscad.js
2015-03-01 More work on adding spacer hole to case.
2015-03-01 Change location of fastner hole.
2015-03-01 Renumber parts.
    [lightmeter.brd, lightmeter.sch]
2015-03-01 Some initial work on updating parts spreadsheet.
    [lightmeter.brd, lightmeter.sch]
2015-03-01 More work on updating parts spreadsheet.
    [lightmeter.brd, lightmeter.sch]
2015-03-02 Switch some caps to 0603 package because it's cheaper.
    [lightmeter.brd, lightmeter.sch]
2015-03-02 Switch all 1u caps to 0603
2015-03-02 Add bypass caps for light sensors.
    [lightmeter.brd, lightmeter.sch]
2015-03-02 Second attempt at op-amp-less redesign.
    [lightmeter.brd, lightmeter.sch]
2015-03-02 Board layout for op-amp-free redesign.
    [lightmeter.brd, lightmeter.sch]
2015-03-02 Update silkscreen.
    [lightmeter.brd]
2015-03-02 Update parts spreadsheet with battery stuff.
    [lightmeter.brd]
2015-03-02 Fix issue with battery connector being in no-go area.
    [lightmeter.brd]
2015-03-02 Add outlines for resistors etc. on silkscreen.
    [lightmeter.brd, lightmeter.sch]
2015-03-02 Some more tweaks to board.
    [lightmeter.brd]
2015-03-03 Add stm32 adc code.
2015-03-03 Add ADC code to build script.
2015-03-03 Some initial work on adc code.
    [lightmeter.brd, lightmeter.sch]
2015-03-03 More work on sensor.c
2015-03-03 Some more work on sensor.c
2015-03-03 Switch to p-channel mosfets for clearing caps.
    [lightmeter.brd, lightmeter.sch]
2015-03-03 Tweak silkscreen name placement.
    [lightmeter.brd]
2015-03-03 More work on caps etc.
    [lightmeter.brd, lightmeter.sch]
2015-03-03 Some fixes to USB/programming connections.
    [lightmeter.brd, lightmeter.sch]
2015-03-03 Improve ground plane connectivity.
    [lightmeter.brd]
2015-03-03 Some changes in diode choice.
    [lightmeter.brd, lightmeter.sch]
2015-03-03 More fiddling with diodes.
    [lightmeter.brd, lightmeter.sch]
2015-03-03 More fiddling around with diodes.
2015-03-03 Some cosmetic changes to silk screen.
    [lightmeter.brd, lightmeter.sch]
2015-03-03 Add some test pads to use up remaining space.
    [lightmeter.brd, lightmeter.sch]
2015-03-03 Layout tweaks to schematic.
    [lightmeter.sch]
2015-03-04 Change piezo resistor value.
    [lightmeter.brd, lightmeter.sch]
2015-03-04 More pwm tweaks.
2015-03-06 Experiment with using four pins and two PWM clocks.
2015-03-06 Modify interface to piezo code and some work on updating schematic/board.
    [lightmeter.brd, lightmeter.sch]
2015-03-06 Update board to connect dual PWM
    [lightmeter.brd]
2015-03-06 Some currently non-working attempts to turn PWM channels on/off.
2015-03-07 Switch around PWM pins so that we can also use ADC.
    [lightmeter.brd, lightmeter.sch]
2015-03-07 Fix debugging_write_uint8 in debugging.c
    [debugging.c]
2015-03-09 Some more work on mic stuff.
    [lightmeter.brd, lightmeter.sch]
2015-03-09 More work on mic stuff.
    [lightmeter.brd, lightmeter.sch]
2015-03-10 More fiddling with mic.
    [lightmeter.brd, lightmeter.sch]
2015-03-14 Make it possible to repeat sample specified number of times
2015-03-14 Fix typo in debugging.c
    [debugging.c]
2015-03-14 Various fixes and improvements to rawsamplestowav.py
    [rawsamplestowav.py]
2015-03-14 Lots of work on scaling for mic adc
2015-03-16 Board now fully routed and cleared again.
    [lightmeter.brd]
2015-03-16 Some work on name layouts.
    [lightmeter.brd, lightmeter.sch]
2015-03-17 Some experiments with adding band-pass filter into the mix.
2015-03-17 More work on audio stuff, filters etc.
2015-03-18 Fix nasty typo in debugging.h
    [debugging.h]
2015-03-18 Add sys core clock printout to main.c
2015-03-18 Add some timing code to main.c
    The FFT takes WAYYYYY too long.
    [main.c]
2015-03-18 Goetzel filter finally working!
2015-03-18 Remove fft lib.
    This runs too slowly to be of any practical use. Switching to Goetzel algorithm
    instead.
    [rawsamplestowav.py]
2015-03-18 Goetzel appears to more-or-less work on device.
2015-03-18 Get DMA working (I think)
2015-03-18 DMA not reading real values into buffer...
2015-03-18 Somewhat successful work on DMA.
2015-03-19 DMA working in circular mode.
2015-03-19 More DMA fiddling.
2015-03-19 Succeeded in pausing circular mode DMA?
2015-03-19 More improvements to DMA stuff.
2015-03-19 Some fixes to goetzel.c
    [goetzel.c]
2015-03-19 More DMA tweaking.
2015-03-19 Source of problem is numerical error triggered by signal/carrier freqs not dividing the sample frequency exactly.
2015-03-20 Switch back to more challenging frequency
2015-03-21 Some final tweaks to board and schematic.
    [lightmeter.brd, lightmeter.sch]
2015-03-21 Remove unnecessary angling of jumper resistor.
    [lightmeter.brd]
2015-03-21 Some work on adding option of crystal to board layout.
    [lightmeter.brd, lightmeter.sch]
2015-03-21 More work on adding option of crystal to layout.
    [lightmeter.brd]
2015-03-21 Crystal now incorporated into board layout.
    [lightmeter.brd]
2015-03-21 Remove trace to nowhere.
    [lightmeter.brd]
2015-03-21 Fix up adapter board.
    [swdtousb.brd, swdtousb.sch]
2015-03-22 Run rename script.
    [lightmeter.brd, lightmeter.sch]
2015-03-22 Some more minor tweaks to schematic.
    [lightmeter.brd]
2015-03-22 Sort out capacitor that was overlapping with button.
    [lightmeter.brd]
2015-03-22 Add holes in all four corners of PCB.
    [lightmeter.brd]
2015-03-22 Some tweaks to silkscreen.
    [lightmeter.brd]
2015-03-22 Some more tweaks to silkscreen.
    [lightmeter.brd]
2015-03-22 More silkscreen tweaks.
    [lightmeter.brd]
2015-03-22 Add schematic/board ordered from Seeed
    [lightmeter_seeed1.brd, lightmeter_seeed1.sch]
2015-03-22 Add version of adapter ordered from Seeed
    [swdtousb_seeed.brd, swdtousb_seeed.sch]
2015-03-22 Move ordered prototype board files into their own folder.
    [lightmeter_proto1.brd, lightmeter_proto1.sch, lightmeter_proto2.brd, lightmeter_proto2.sch, lightmeter_proto3.brd, lightmeter_proto3.sch, swdtousb_seeed.brd, swdtousb_seeed.sch]
2015-03-24 Attempted fix to adapter board layout.
2015-03-30 Move Seeed order into 'orders' folder.
    [lightmeter_seeed1.brd, lightmeter_seeed1.sch]
2015-03-30 Remove unused file lightmeter_grouped.brd
    [lightmeter_grouped.brd]
2015-03-30 Move some old notes on a prototype board into 'orders' folder.
2015-04-04 500k -> 510k (cheaper)
    [lightmeter.brd, lightmeter.sch]
2015-04-05 Fix some bugs in iso_bcd_to_third_stops (still buggy)
    [exposure.c]
2015-04-05 iso_bcd_to_third_stops in exposure.c now working correctly.
    [exposure.c]
2015-04-05 Fix various bits of code that used old BCD functions.
    [bcd.h, exposure.c, exposure.h, state.h, ui.c, ui.h]
2015-04-09 Use linker script for correct chip generated using STM32CubeMx.
    Board now works.
2015-04-09 Some changes to packages based on experience soldering prototype board.
    [lightmeter.brd, lightmeter.sch]
2015-04-11 Make schematic for accelerometer a bit easier to read.
    [lightmeter.brd, lightmeter.sch]
2015-04-11 Explicitly tie /CS to ground for screen.
    [lightmeter.brd, lightmeter.sch]
2015-04-11 Switch to using a more practical package for power mux diodes.
    [lightmeter.brd, lightmeter.sch]
2015-04-11 Increase pad size for small p-channel mosfets.
    [lightmeter.brd, lightmeter.sch]
2015-04-11 Switch to 6k49 resistors for I2C pullups since we've verified on test board that these work.
    [lightmeter.brd, lightmeter.sch]
2015-04-11 Increase size of protection diode pads.
    [lightmeter.brd, lightmeter.sch]
2015-04-11 Correct package error for 130Ohm resistor
2015-04-11 First step to making all 1u caps 0603
    [lightmeter.brd, lightmeter.sch]
2015-04-12 Fix missing include in accel.h
    [accel.h]
2015-04-12 Some tweaks to lightmeter.sch
    [lightmeter.sch]
2015-04-12 Attempt to increase pad size of buttons a bid.
    [lightmeter.brd, lightmeter.sch]
2015-04-12 Simple light measurements working.
    [lightmeter.sch]
2015-04-12 Fix mistake in piezo.c
    [piezo.c]
2015-04-13 Experiment with getting rid of screen/mic power mosfet
    [lightmeter.brd, lightmeter.sch]
2015-04-13 Revert "Experiment with getting rid of screen/mic power mosfet"
    This reverts commit 0ea2fc8952a41135a350a53187906d9f9b76826a.
    [lightmeter.brd, lightmeter.sch]
2015-04-13 Fix issue with pins being wrong way round for screen power MOSFET.
    [lightmeter.brd, lightmeter.sch]
2015-04-15 Some initial work on code for handling button presses (not working yet)
    [deviceconfig.h, main.c]
2015-04-15 Revert "Fix bug in exposure.c"
    This reverts commit 00d3a7749916842607eeade4d3d0995e10ebc5b2.
    [exposure.c]
2015-04-15 Some progress on button press handling.
2015-04-15 Fix button logic by adding additional diode.
    [lightmeter.brd, lightmeter.sch]
2015-04-15 More work on button handling code.
2015-04-16 Minor code formatting update to i2c.h
2015-04-16 Some possible accelerometer progress.
2015-04-16 Accelerometer working!
2015-04-16 Some work on lightmeter.brd
    [lightmeter.brd]
2015-04-16 Fix bug in display_reset() in display.c
    [display.c]
2015-04-17 Fix (?) some more issues in display.c code.
    [display.c]
2015-04-17 Accelerometer test code now working nicely.
2015-04-19 Some work on board/schematic.
    [lightmeter.brd, lightmeter.sch]
2015-04-19 Change to interrupt handler in buttons.c
2015-04-19 Some work on board and schematic.
    [lightmeter.brd, lightmeter.sch]
2015-04-21 Some more work on board/schematic.
    [lightmeter.brd, lightmeter.sch]
2015-04-21 Some more work on board.
    [lightmeter.brd]
2015-04-21 More work on button stuff.
2015-04-25 Some initial work on switching to Phillips light sensor.
    [lightmeter.brd, lightmeter.sch]
2015-04-26 Layour for new board mostly done.
    [lightmeter.brd]
2015-04-26 New board layour more-or-less complete.
    [lightmeter.brd]
2015-04-26 Some preparatory work on moving USB port further up.
    [lightmeter.brd]
2015-04-26 Move USB port up higher.
    [lightmeter.brd, lightmeter.sch]
2015-04-27 Some tweaks to case.openjscad.js
2015-04-27 Fix some mesh problems in case.openjscad.js that made sculpteo think there were eight parts rather than five.
2015-04-27 Better separation of different case parts in case.openjscad.js
2015-04-28 Fix logic bug in buttons.c
    [buttons.c, main.c]
2015-04-29 Some initial buggy work on getting menu scrolling to work in main UI code.
    [main.c, state.c, state.h, ui.c, ui.h]
2015-04-29 Fix stupid bug with systick counting in main.c
    [main.c]
2015-04-30 Add missing i2c/accel init calls to main.c
    [main.c]
2015-04-30 Some initial very buggy work on drawing arrow indicating currently-selected menu item.
    [state.h, ui.c]
2015-05-01 More buggy work on arrow in menu selection.
    [ui.c]
2015-05-01 Update TODO list for case.openjscad.js
2015-05-01 Uncomment commented-out components in case.openjscad.js
2015-05-01 Fix comment in buttons.c
    [buttons.c]
2015-05-04 Remove some old junk.
    [luminosity_function.csv, qb11_spectral_sensitivity.csv, qb12_spectral_sensitivity.csv, vemd2503x01_spectral_sensitivity.csv]
2015-05-04 Some initial efforts at reworking calculate_tables.py
    [calculate_tables.py]
2015-05-05 Add 0.75mm holes as possible supports for ND filter holder
    [lightmeter.brd]
2015-05-05 Some work on crystal.
    [lightmeter.brd, lightmeter.sch]
2015-05-05 Some fiddling with board/schematic etc.
    [lightmeter.brd, lightmeter.sch]
2015-05-05 Another fix to calculate_tables.py, uncovering potential problem.
    [calculate_tables.py]
2015-05-05 Fix typo in comment in calculate_tables.py
    [calculate_tables.py]
2015-05-05 Figure out timings for amp stages in calculate_tables.py
2015-05-05 Minor fix to calculate_tables.py
    [calculate_tables.py]
2015-05-06 Some initial work on timing length of button presses.
2015-05-06 Some fixes to SysTick configuration.
    [sysinit.c]
2015-05-06 Fix to logic in buttons.c
    [buttons.c]
2015-05-06 Some more (buggy) work on buttons
    [buttons.c, main.c]
2015-05-06 Short/long button press detection now appears to be working.
    [buttons.c]
2015-05-06 Minor optimization to buttons.c
2015-05-06 Some more work on button/ui stuff.
2015-05-06 Fix bug in button press handling code.
    [main.c]
2015-05-07 Fix incident dome hole missizing in case.openjscad.js
2015-05-08 Fix error in ref voltage in calculate_tables.py
    [calculate_tables.py]
2015-05-08 Switch back to sensible crystal package.
    [lightmeter.brd, lightmeter.sch]
2015-05-10 Use SPST analogue switches instead of MOSFETs in amp circuit.
    [lightmeter.brd, lightmeter.sch]
2015-05-11 Initial relayout of board following switch from MOSFETS to SPSTs
    [lightmeter.brd]
2015-05-11 Abortive case tweaking.
2015-05-11 Make all 1u caps 0603
    [lightmeter.brd, lightmeter.sch]
2015-05-11 Smash some labels.
    [lightmeter.brd]
2015-05-11 Some more work on board
    [lightmeter.brd, lightmeter.sch]
2015-05-12 Some work on adjusting case/board to screen dimensions.
    [lightmeter.brd]
2015-05-12 More work on case etc.
    [lightmeter.brd]
2015-05-12 Some more (incomplete) work on sensor hole positioning.
2015-05-12 Give accelerometer a bit more space in board layout.
    [lightmeter.brd]
2015-05-12 Enlarge microusb port cutout slightly.
    [lightmeter.brd, lightmeter.sch]
2015-05-12 Fix sensor positions.
2015-05-12 Revert "Bad log thing"
    This reverts commit edb7d561bdd73bbe62c72c74131943446c1511dd.
    [calculate_tables.py]
2015-05-12 Add link to battery in case.openjscad.js
2015-05-12 Remove EEPROM for now.
    [lightmeter.brd, lightmeter.sch]
2015-05-12 Some minor fixes to lightmeter.brd
    [lightmeter.brd]
2015-05-12 Add outline for filter holders to board.
    [lightmeter.brd]
2015-05-13 Remove decoupling cap for mic.
    [lightmeter.brd, lightmeter.sch]
2015-05-13 Add cheap op amp to lightmeter.lbr
    http://www2.mouser.com/ProductDetail/Microchip-Technology/MCP6001T-I-LT/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
    [lightmeter.brd, lightmeter.sch]
2015-05-13 Add amplifier to mic.
    [lightmeter.brd, lightmeter.sch]
2015-05-13 Some initial work on board layout for mic amp.
    [lightmeter.brd, lightmeter.sch]
2015-05-13 More work on mic amp board layout.
    [lightmeter.brd]
2015-05-13 More work on bard layout for mic amp.
    [lightmeter.brd, lightmeter.sch]
2015-05-13 Fix serious dimension error in case.openjscad.js
2015-05-14 BEFORE TEMP
    [lightmeter.brd, lightmeter.sch]
2015-05-15 Switch to cheaper 1% 3300pF cap
2015-05-15 Some more work on board layout for mic amp.
    [lightmeter.brd, lightmeter.sch]
2015-05-19 More work on board layout for mic.
    [lightmeter.brd]
2015-05-19 More work on board layout for mic amp.
    [lightmeter.brd]
2015-05-19 Fix design rule checks in board layout for mic amp.
    [lightmeter.brd]
2015-05-20 Add labels to mic amp
    [lightmeter.brd]
2015-05-20 Some more tweaks to board and parts spreadsheet.
    [lightmeter.brd]
2015-05-20 Make cap values in mic preamp better suited for working with high frequencies.
    [lightmeter.brd]
2015-05-20 Tweaking values for mic op amp.
    [lightmeter.brd, lightmeter.sch]
2015-05-20 Make some more space for filter holders.
    [lightmeter.brd]
2015-05-21 More tweaks to schematic and board.
    [lightmeter.brd, lightmeter.sch]
2015-05-22 Some preliminary work on switching to MEMS oscillator for external clock.
    [lightmeter.brd, lightmeter.sch]
2015-05-22 Some more work on oscillator.
    [lightmeter.brd, lightmeter.sch]
2015-05-22 More work on external oscillator.
    [lightmeter.brd, lightmeter.sch]
2015-05-23 More work on oscillator and some improvements to ground plane connectivity.
    [lightmeter.brd, lightmeter.sch]
2015-05-24 Update mic offset voltage in piezo.c
2015-05-24 Some work on board, parts list, etc.
2015-05-24 Some part consolidation.
    [lightmeter.brd, lightmeter.sch]
2015-05-24 More part consolidation.
    [lightmeter.brd, lightmeter.sch]
2015-05-24 Some updates to board and schematic.
    [lightmeter.brd, lightmeter.sch]
2015-05-25 Add bom.partslist
2015-05-25 Tweaks to board and schematic.
    [lightmeter.brd, lightmeter.sch]
2015-05-26 Some more work on bom.partslist and partfinder.py
2015-05-26 Some initial work on making room for larget crystal and associated components.
    [lightmeter.brd, lightmeter.sch]
2015-05-26 Some more work on integrating oscillator circuit to layout.
    [lightmeter.brd, lightmeter.sch]
2015-05-26 Oscillator layout now passes DRC; improve connectivity of ground polygon.
    [lightmeter.brd]
2015-05-26 Figure out component values for oscillator and some other tweaks.
    [lightmeter.brd, lightmeter.sch]
2015-05-26 Move somewhat precariously placed via.
    [lightmeter.brd]
2015-05-26 Improve connectivity of ground polygon.
    [lightmeter.brd]
2015-05-26 Make dimensions of battery connector more realistic.
    [lightmeter.brd, lightmeter.sch]
2015-05-26 More tweaks to silkscreen.
    [lightmeter.brd]
2015-05-27 Improve ground polygon connectivity.
    [lightmeter.brd]
2015-05-27 Remove GND jumper on bottonm layer
    [lightmeter.brd, lightmeter.sch]
2015-05-27 More work on improving coverage of ground polygon.
    [lightmeter.brd]
2015-05-27 Fix some DRC errors.
    [lightmeter.brd]
2015-05-27 Some modifications to battery plug socket and some attempts to make room for better piezo connectors.
    [lightmeter.brd, lightmeter.sch]
2015-05-27 Significant progress on making connection to piezo bender more accessible.
    [lightmeter.brd, lightmeter.sch]
2015-05-27 DRC check passes again.
    [lightmeter.brd, lightmeter.sch]
2015-05-27 New piezo connector layout complete.
    [lightmeter.brd, lightmeter.sch]
2015-05-27 Add missing trace to board.
    [lightmeter.brd]
2015-05-27 Fix silly mistake (one of the piezo wire holes was below the screen).
    [lightmeter.brd]
2015-05-27 Update bom.partslist with links to some useful Mouser product pages.
2015-05-27 Remove parts.numbers (replaced by bom.partslist)
2015-05-27 Change to square pads for piezo wire holes.
    [lightmeter.brd, lightmeter.sch]
2015-05-27 Minor correction to schematic description and layout improvement.
    [lightmeter.sch]
2015-05-27 Consolidate 3300pF caps
    [lightmeter.brd, lightmeter.sch]
2015-05-27 Change to silkscreen.
    [lightmeter.brd]
2015-05-27 Update to silkscreen.
    [lightmeter.brd]
2015-06-02 Add second Seeed prototype board to ordered/
    [lightmeter_seeed2.brd, lightmeter_seeed2.sch]
2015-06-11 Update code for pin config of new Seeed prototype.
2015-06-11 Fix MOSFET logic in display.c
    [display.c]
2015-06-11 Some tweaks to layout.
    [lightmeter.brd, lightmeter.sch]
2015-06-11 Fix screen power mosfet pad layout error
    [lightmeter.brd, lightmeter.sch]
2015-06-12 Update bom.partslist with ezmate crimp terminals.
2015-06-12 Minor updates to schematic.
    [lightmeter.brd, lightmeter.sch]
2015-06-12 Get rid of LREGENABLE (STM32 needs AVDD to be high to start up)
    [lightmeter.brd, lightmeter.sch]
2015-06-12 Get rid of LREGENABLE
    [lightmeter.sch]
2015-06-12 Some fixes to meter.c
    [meter.c]
2015-06-13 Some progress on metering mess.
    [lightmeter.brd, lightmeter.sch]
2015-06-13 Possible fix for maddening metering issues.
    [calculate_tables.py, main.c, meter.c]
2015-06-14 Is it finally fixed (??)
    [lightmeter.brd, lightmeter.sch]
2015-06-14 Some tweaks to 'stabilize' function in meter.c
    [meter.c]
2015-06-14 Fix up meter mess following correction to board.
    [main.c, meter.c]
2015-06-14 DMA now working for metering ADC.
2015-06-15 Some work on ND filters etc.
2015-06-15 Some more work on metering/calibration stuff.
2015-06-16 Fix logic error in meter_take_raw_integrated_readings
    [meter.c]
2015-06-16 Various tweaks and fixes to metering.
    [main.c, meter.c]
2015-06-16 Some work on mains noise filtering etc.
    [main.c, meter.c, meter.h]
2015-06-17 Some improvements to ground plane connectivity.
    [lightmeter.brd, lightmeter.sch]
2015-06-18 Some more (incomplete) work on ground plane connectivity.
    [lightmeter.brd, lightmeter.sch]
2015-06-21 Replace generic inductor with specific model in bom.partslist
2015-06-21 More work on improving PCB layout.
    [lightmeter.brd, lightmeter.sch]
2015-06-21 Use recommended components for buck convertor and more work on layout
    [lightmeter.brd, lightmeter.sch]
2015-06-21 More work on board and schematic.
    [lightmeter.brd, lightmeter.sch]
2015-06-22 Some work on pcb clearences.
    [lightmeter.brd]
2015-06-22 More work on board etc.
    [lightmeter.brd, lightmeter.sch]
2015-06-22 Use correct battery charger IC for LiPo battery (!) (same pin layout)
2015-06-23 More work on board layout. D- now pull up to 3.3V (changed buck reg)
    [lightmeter.brd, lightmeter.sch]
2015-06-23 More work on schematic and board; selectable charging rates.
    [lightmeter.brd, lightmeter.sch]
2015-06-24 Minor updates to board layout.
    [lightmeter.brd]
2015-06-24 Add EEPROM
    [lightmeter.brd, lightmeter.sch]
2015-07-04 Some improvements to ground polygon.
    [lightmeter.brd]
2015-07-04 Some fixes to tests in exposure.c
    [exposure.c]
2015-07-04 Frequency detection now working much better after fixing some sign bugs in goetzel implementation and in piezo.c
    [goetzel.c, goetzel.h, piezo.c]
2015-07-04 Normalizing for power thingy doesn't seem to do anything useful.
    [goetzel.c]
2015-07-04 Add bypass cap for mic
    [lightmeter.brd, lightmeter.sch]
2015-07-04 More improvements to ground polygon.
    [lightmeter.brd]
2015-07-05 TEMP WORK ON USB SERIES.
    [lightmeter.brd, lightmeter.sch]
2015-07-06 Fix logic bug in piezo_read_data (still doesn't work)
    [piezo.c]
2015-07-08 Some improvements/fixes to goetzel.c test code.
    [goetzel.c]
2015-07-08 Check that separate computations in 'goetzel2' function don't screw each other up.
2015-07-09 Fix typo in comment in hfsdp.c
    [hfsdp.c]
2015-07-11 Remove silly mistake regarding coefficient calculation
    [calccoeffs.py]
2015-07-11 Back to square one but with correct timer-determined sample rate.
    [goetzel.c, hfsdp.c, hfsdp.h, main.c, piezo.c, piezo.h]
2015-07-11 Add some notes on dma timer in piezo.c
2015-07-11 Some important fixes to mic stuff.
    [hfsdp.h, main.c, piezo.c, piezo.h, systime.h]
2015-07-13 Back at square one -- wobbly goetzel.
    [goetzel.c, goetzel.h, hfsdp.c, hfsdp.h]
2015-07-13 Some fixes to main.c and hfsdp.c (code using old apis)
    [hfsdp.c, main.c]
2015-07-14 Some more work on hamming; still a bit buggy.
    [hamming.c]
2015-07-15 Hamming encoding and decoding algorithm now working.
    Back at square one re problem with noisy signal generation in webconfig.js
    [hamming.c, hamming.h]
2015-07-16 Fix bug in piezo.c
    [piezo.c]
2015-07-16 Some more work on hamming stuff.
    hamming_bitshift_buffer_forward now appears to be working correctly
    hamming_scan_for_init_sequence still untested
    [hamming.c, hamming.h]
2015-07-16 Some fixes to hamming_scan_for_init_sequence
    [hamming.c, hamming.h]
2015-07-18 Sending on short messages working (but very very unreliably)
    [main.c]
2015-08-31 Remove unnecessary and possible unhelpful cap in mic preamp circuit
    [lightmeter.brd, lightmeter.sch]
2015-08-31 Minor updates to lightmeter.brd
    [lightmeter.brd]
2015-08-31 Initial work on switching to bluetooth LE from ultrasound
    [lightmeter.brd, lightmeter.sch]
2015-08-31 Some initial work on bluetooth
    [lightmeter.brd]
2015-09-01 Some more work on board/schematic for bluetooth
    [lightmeter.brd, lightmeter.sch]
2015-09-01 More work on bluetooth stuff.
    [lightmeter.brd, lightmeter.sch]
2015-09-01 Some significant progress on bluetooth layout.
    [lightmeter.brd]
2015-09-01 More work on bluetooth layout.
    [lightmeter.brd]
2015-09-01 Add USB protector ic
    [lightmeter.brd, lightmeter.sch]
2015-09-02 More work on bluetooth and usb protection diode ic
    [lightmeter.brd, lightmeter.sch]
2015-10-08 Changes to board layout.
    [lightmeter.brd]
2015-10-08 Some work on board layout
    [lightmeter.brd]
2015-10-09 More work on board layout and screw hole positioning.
    [lightmeter.brd]
2015-10-12 Improve ground plane connectivity
    [lightmeter.brd]
2015-10-13 Major progress on first draft of board layout -- design rule checks now complete
    [lightmeter.brd]
2015-10-13 Some corrections to board and schematic.
    [lightmeter.brd, lightmeter.sch]
2015-10-13 Remove leftover piezo schematic
    [lightmeter.brd, lightmeter.sch]
2015-10-25 Remove unneded cap and more work on board layout.
    [lightmeter.brd, lightmeter.sch]
2015-11-08 Some progress on board layout.
    [lightmeter.brd, lightmeter.sch]
2015-11-08 More improvements to layout.
    [lightmeter.brd]
2015-11-08 Sort out layout problem with one of the caps associated with bluetooth chip
    [lightmeter.brd, lightmeter.sch]
2015-12-22 Shift screen and buttons up.
    [lightmeter.brd]
2015-12-22 Some work on making room for bottom layer signals running along bottom of board
    [lightmeter.brd]
2015-12-22 Major progress on bluetooth chip SPI connections.
    [lightmeter.brd]
2015-12-22 Some work on making room for bluetooth antenna.
    [lightmeter.brd, lightmeter.sch]
2015-12-23 Some further work on bluetooth etc.
    [lightmeter.brd, lightmeter.sch]
2015-12-23 Add 2450AT18A100 (bluetooth antenna) to lightmeter.lbr
2015-12-23 Some initial work on placing balun and antenna for bluetooth
    [lightmeter.brd, lightmeter.sch]
2015-12-23 Some work on making room for antenna.
    [lightmeter.brd, lightmeter.sch]
2015-12-23 More work on bluetooth antenna.
    [lightmeter.brd, lightmeter.sch]
2015-12-24 More work on positioning arial.
    [lightmeter.brd]
2015-12-24 More work on positioning antenna.
    [lightmeter.brd]
2015-12-24 Shift things areound problematic screw hole in bottom left.
    [lightmeter.brd]
2015-12-24 More work on bluetooth-related layout issues.
    [lightmeter.brd]
2015-12-24 Some work on fixing DRC errors.
    [lightmeter.brd]
2015-12-24 DRC fix.
    [lightmeter.brd]
2015-12-24 Some tidying up.
    [lightmeter.brd]
2015-12-25 Remove unused solder jumper.
    [lightmeter.brd, lightmeter.sch]
2015-12-25 More work on fixing DRC errors.
    [lightmeter.brd]
2015-12-25 DRC errors all fixed now.
    [lightmeter.brd]
2015-12-25 Minor fixes.
    [lightmeter.brd]
2015-12-25 Some improvements to ground plane connnectivity.
    [lightmeter.brd]
2015-12-26 Some more work on ground plane connectivity.
    [lightmeter.brd]
2015-12-27 Various tweaks to silkscreen and layout.
    [lightmeter.brd, lightmeter.sch]
2016-02-06 Update schematic with usb protection diode ic
2016-02-06 Some tweaks to board.
    [lightmeter.brd]
2016-02-06 More tweaks to board -- looks about done.
    [lightmeter.brd]
2016-02-06 Restrict ground polygon under crystals
    [lightmeter.brd]
2016-02-12 Some improvements to board layout.
    [lightmeter.brd, lightmeter.sch]
2016-02-12 Add battery charger / power mux IC to lightmeter.lbr
2016-02-12 Some initial work on using combined power mux and battery charger.
    [lightmeter.brd, lightmeter.sch]
2016-02-12 More work on new mux design
    [lightmeter.brd, lightmeter.sch]
2016-02-13 More work on bat charger ic
    [lightmeter.brd, lightmeter.sch]
2016-02-13 More work on new layout.
    [lightmeter.brd, lightmeter.sch]
2016-02-13 Tidy some traces.
    [lightmeter.brd]
2016-02-13 Add pushbutton package for http://www.mouser.co.uk/ProductDetail/E-Switch/TL3342F260QG/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
    [lightmeter.brd]
2016-02-14 More work on layout (DRC errors remain).
    [lightmeter.brd]
2016-02-14 Dont bother with charger temp control, just use a single regular resistor.
    [lightmeter.brd, lightmeter.sch]
2016-02-22 Add resistor for charger temp control.
    [lightmeter.brd, lightmeter.sch]
2016-02-22 Switch to Make-based build system
2016-03-07 Remove separate LDO voltage regulator for AVREG -- probably unnecessary and gave rise to too much idle power consumption.
    [lightmeter.brd, lightmeter.sch]
2016-03-07 More work on fixing DRC violations.
    [lightmeter.brd, lightmeter.sch]
2016-03-07 Add jumper for better ground plane continuity.
    [lightmeter.brd, lightmeter.sch]
2016-03-07 Tidy up silkscreen a bit.
    [lightmeter.brd]
2016-03-07 Add another VCC polygon.
    [lightmeter.brd]
2016-03-09 Some minor fixes to shutter speed tables.
    [calculate_tables.py]
2016-03-10 Minor layout change.
    [lightmeter.brd]
2016-03-11 Add missing include in i2c.h (did not give rise to an error because it was included elsewhere, but should be here)
    [i2c.h]
2017-05-02 EAGLE version number bump in lightmeter.sch (no changes to schematic).
    [lightmeter.sch]
